LakshanandSugumar/agrobo/land/farmland-shortlist.md

# Agrobo farmland shortlist (first tomato farm)

Pulled from public listings on 2026-10-19. Prices, acreage and water details are as the listing states them and are not verified. Listings change daily, so call the broker before relying on any row.

**Filters used:** Southwest Florida first (launch region), California kept as backup, open or cleared ground (no orchards to rip out), at least ~20 acres in one block, a stated irrigation water source.

## Southwest Florida (launch region, chosen 2026-10-21)

SW Florida grows fresh-market tomatoes from fall to spring, so summer heat and rain, not frost, set the season. Soils are sandy with low organic matter and are farmed on raised beds with plastic mulch and seepage or drip irrigation. Every row below needs a South Florida Water Management District water use permit confirmed.

| # | Property | Acres (ha) | Ask | $/acre | Water (as listed) | Ground today | Why / watch-outs |
|---|---|---|---|---|---|---|---|
| 1 | Alva, Lee Co., FL (N River Rd) | 111.6 (45) | $1,332,000 | ~$11,900 | Irrigation canal on west boundary, no well listed | Cleared ex-citrus, laser-leveled, ag lease to Jan 2027 | Cheapest per acre, already leveled, near the Immokalee tomato belt. Needs a well/water use permit and soil residue test (ex-citrus). Agent Dalton Wade, (727) 888-4175. [Listing](https://www.landsearch.com/properties/n-river-rd-alva-fl-33920/5167966) |
| 2 | 1016 Goodno Rd, LaBelle, Hendry Co., FL | 140 (57) + adjoining 56 ac | $2,736,747 | ~$19,500 | Canal at south end for irrigation, Gerber Water District | Cleared ex-orange grove | Room to grow to ~196 ac. Sweetwater Land Co., Linda Dekle Davis, (863) 517-1153. [Listing](https://www.landsearch.com/properties/1016-goodno-rd-labelle-fl-33935/5572793) |
| 3 | 960 G Rd, LaBelle, Hendry Co., FL | 144.5 (58) | $2,537,500 | ~$17,600 | Water well + canals | Fenced pasture, suited to row crops | Fencing needs repair, listing mentions vandalism. Southern Heritage RE, Sherri Denning, (863) 673-0829. [Listing](https://www.landsearch.com/properties/960-g-rd-labelle-fl-33935/5158578) |
| 4 | Clewiston, Hendry Co., FL | 326 (132) | $11,000,000 on listing page ($8,000,000 on search page) | ~$33,700 | Wells, irrigation and water management, retention pond | ~180 ac active sod, ex-watermelon | Biggest and fully irrigated, but priciest; confirm the real ask. Agent Jamie Bederak, (423) 557-4310. [Listing](https://www.landsearch.com/properties/clewiston-fl/5443580) |

## California (backup, not the launch region)

| # | Property | Acres (ha) | Ask | $/acre | Water (as listed) | Ground today | Why / watch-outs |
|---|---|---|---|---|---|---|---|
| 1 | Dutra Central Ave Ranch, Clarksburg, Yolo Co., CA | 117 (47) | $2,223,000 | ~$19,000 | Riparian rights + pre-1914 North Delta rights, 2,000 GPM slough pump | Productive Delta ag land, 5 parcels | Senior surface water rights are the most valuable thing on this list. Yolo is core processing-tomato country. Listing flyer filename is dated 2012, so confirm it is current. [Listing](https://www.landwatch.com/yolo-county-california-farms-and-ranches-for-sale/pid/427597666) |
| 2 | 13450 Turner Island Rd, Dos Palos, Merced Co., CA | 127.5 gross / 122.5 farmable (50) | $2,677,500 | ~$21,000 | San Luis Canal Co. surface water + 1 ag well | Open ground | Clean open block with surface water. One page shows it Pending, the listing says Available; confirm status. Possible broker: Murray Ag Real Estate. [Listing](https://www.landwatch.com/merced-county-california-farms-and-ranches-for-sale/pid/428495026) |
| 3 | Palm Ave, Winton, Merced Co., CA | 19.7 (8) | $625,000 | ~$31,700 | Tier 1 Merced Irrigation District + shared ag well (40 HP) | Row crops 6+ years | Pilot-sized only (8 ha), but turnkey with strong water. MLS MC26201161. [Listing](https://www.landwatch.com/merced-county-california-farms-and-ranches-for-sale/pid/428203794) |

**Try-before-buy option:** 595 N Header Canal Rd, Fort Pierce, St. Lucie Co., FL. About 76-80 ac for lease at $5,000/month (12-60 months), seepage irrigation, multiple wells, pump stations, farmed 20+ years. Useful to run a first season while closing on a purchase. Contact Matt Eflanli, (561) 666-8288. [Listing](https://www.landsearch.com/properties/595-n-header-canal-rd-fort-pierce-fl-34945/4898677)

**Looked at and dropped:** French Camp, CA (76 ac, $4.49M, planted almonds, ~$59k/ac); Colusa River Rd, CA (345 ac, $6.5M, mostly walnuts and rice, row-crop acreage not stated); plus orchard, vineyard and rural-home listings in the Central Valley feed.

## Land vs robot cost

At ~$11,900-21,000/acre, land is roughly $29k-54k per hectare, against the sim's modeled robot capex of ~$77k/ha. On the top picks, land is a smaller check than the fleet.

## Due diligence before an offer

1. **Water:** confirm rights and deliveries in writing (district allocation history, well yield test). In the San Joaquin Valley, groundwater pumping limits under SGMA apply, so surface water matters. In Florida, confirm a South Florida Water Management District water use permit.
2. **Soil:** NRCS soil survey plus lab tests, including pesticide residue on ex-citrus ground.
3. **Title, zoning and Williamson Act status**, Phase I environmental, flood zone.
4. **Robot fit:** run each parcel's boundary and slope through the prototype's `/strategy_engine` to check block shape, headlands and RTK/cell coverage.

## Sources
- [LandSearch: Florida row crop land](https://www.landsearch.com/row-crop/florida)
- [LandSearch: San Joaquin County farmland](https://www.landsearch.com/agricultural/san-joaquin-county-ca)
- [LandWatch: Central Valley farms and ranches](https://www.landwatch.com/california-land-for-sale/central-valley-region/farms-ranches)
- Individual listing links in the table above.
