LakshanandSugumar/agrobo/robots/calc/fleet_capex.md

| Scenario | UGV/ha | $/UGV incl. share of implements + dock | UGVs $/ha | UAV | Hauler | Hub | Prep | **Total $/ha** | vs model |
|---|---:|---:|---:|---:|---:|---:|---:|---:|---:|
| Prototype model | 1.23 | 55,000 | 67,650 | 60 | 3,750 | 3,750 | 1,500 | **76,710** | +0 % |
| Real BOM, pilot prices, sim cycle time, mechanical weeder | 1.24 | 59,524 | 74,037 | 55 | 3,711 | 3,750 | 0 | **81,553** | +6 % |
| Real BOM, pilot prices, sim cycle time, laser weeder | 1.24 | 72,874 | 90,642 | 55 | 3,711 | 3,750 | 0 | **98,158** | +28 % |
| Real BOM, 100-unit prices, sim cycle time, mechanical weeder | 1.24 | 43,580 | 54,206 | 41 | 2,783 | 3,750 | 0 | **60,781** | -21 % |
| Real BOM, 100-unit prices, design-target cycle time, mechanical weeder | 0.82 | 43,580 | 35,912 | 41 | 2,783 | 3,750 | 0 | **42,486** | -45 % |
