LakshanandSugumar/agrobo/robots/electrical/E-02_safety_circuit.pdf

# E-02 Safety chain -> PNOZ s4 -> K1 drive / K2 arms

Dual channel, cross-monitored, Cat 3 / PL d target (ISO 13849-1). Stop category 0 for drive, cat 1 for arms (controlled stop then K2).

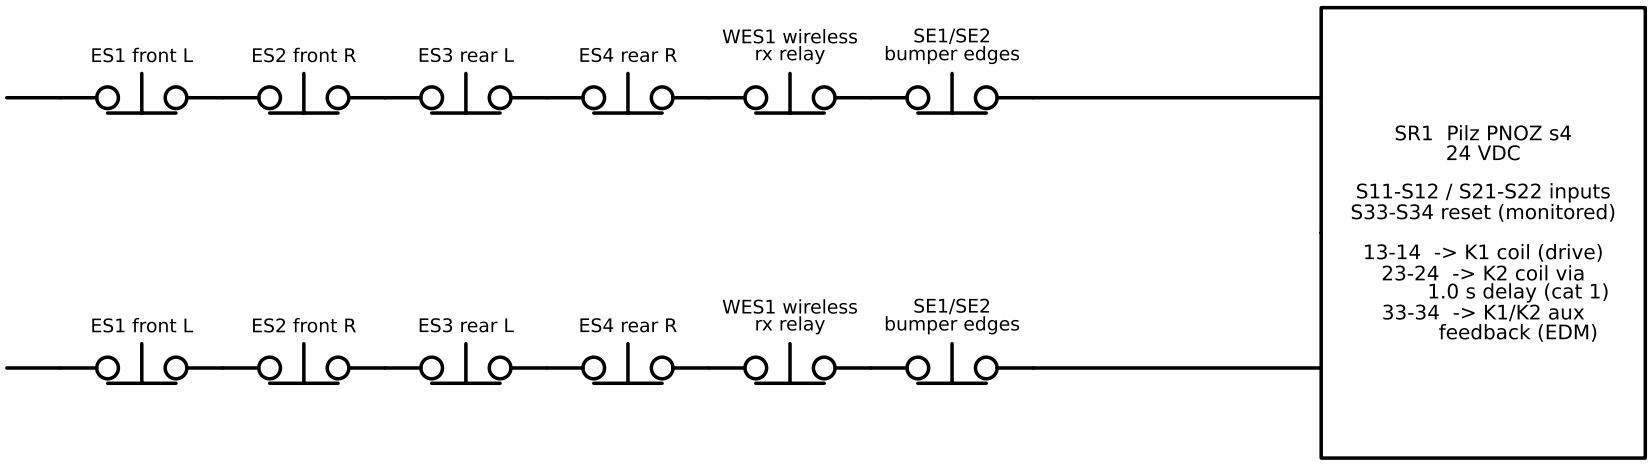
[picture p8: figure]
ES1 front L; ES2 front R; ES3 rear L; ES4 rear R; WES1 wireless rx relay; SE1/SE2 bumper edges; SR1 Pilz PNOZ s4 24 VDC; S11-S12 / S21-S22 inputs S33-S34 reset (monitored); 13-14 -> K1 coil (drive) 23-24 -> K2 coil via 1.0 s delay (cat 1) 33-34 -> K1/K2 aux feedback (EDM)

CH1 (S11-S12)

CH2 (S21-S22)

RS1 reset (blue)
at rear panel Also wired into SR1 inputs in series: FR5 controller safety I/O (each arm reports protective stop), BMS fault relay. Software stop (non-safety) path: Jetson -> Teensy -> VESC zero current + FR5 'stop' over Ethernet; used for normal pauses.
Geofence + speed limit (0.5 m/s near people detected by perception) are software functions and are NOT counted as safety functions in v1. Production: add SICK outdoorScan3 safety laser scanner zones (protective field 1.5 m at 1.5 m/s) to reach ISO 18497 people-detection.
