LakshanandSugumar/agrobo/robots/electrical/E-03_data_comms.pdf

# E-03 Data and communications architecture

Ethernet backbone + GMSL2 + USB3 + CAN-FD | ROS 2 Jazzy on Jetson, micro-ROS on Teensy | Agrobo rev A 2026-10-21

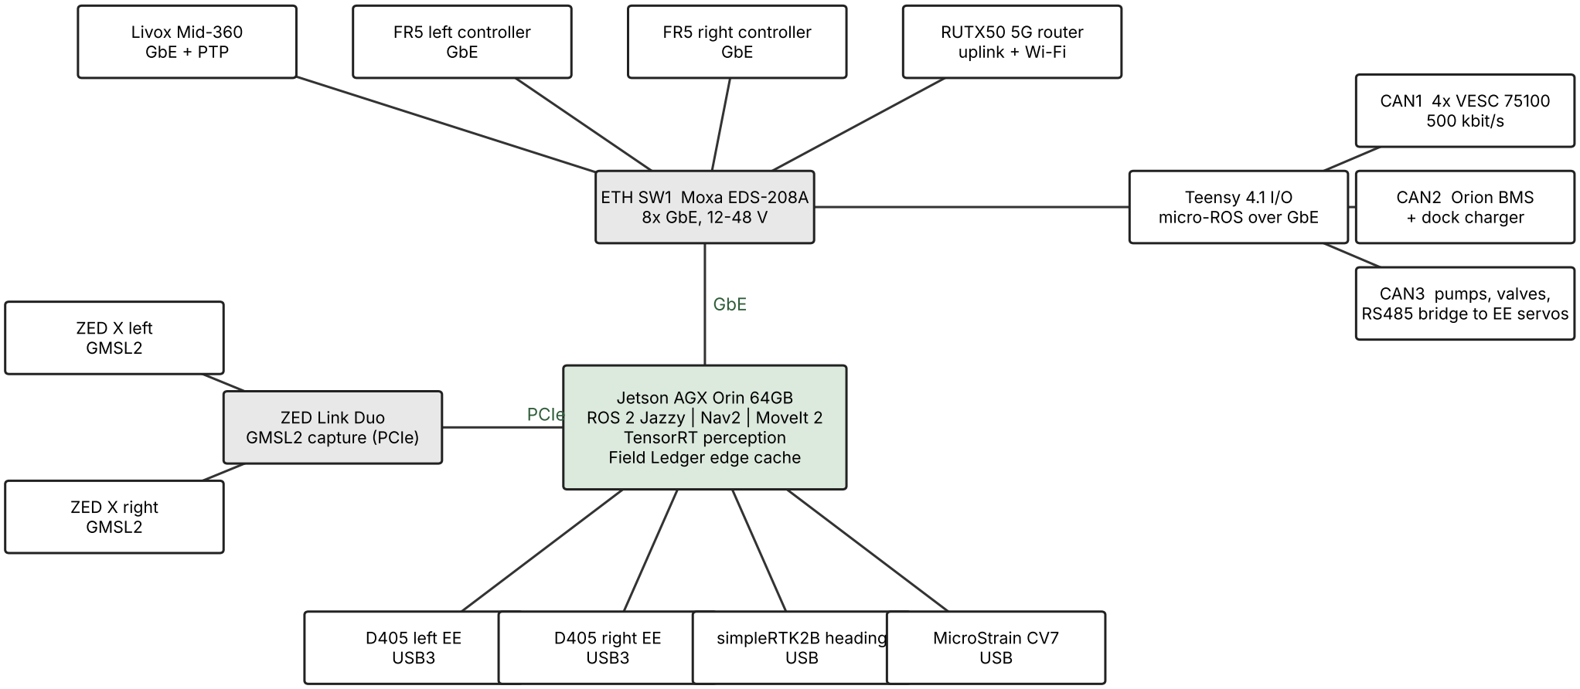
[picture p9: figure]
GbE; PCIe; Jetson AGX Orin 64GB ROS 2 Jazzy | Nav2 | MoveIt 2; TensorRT perception Field Ledger edge cache; ETH SW1 Moxa EDS-208A 8x GbE, 12-48 V; Livox Mid-360; GbE + PTP; FR5 left controller GbE; FR5 right controller GbE; RUTX50 5G router uplink + Wi-Fi; Teensy 4.1 I/O micro-ROS over GbE; ZED Link Duo GMSL2 capture (PCIe); ZED X left GMSL2; ZED X right GMSL2; D405 left EE USB3; D405 right EE USB3; simpleRTK2B heading USB; MicroStrain CV7 USB; CAN1 4x VESC 75100 500 kbit/s; CAN2 Orion BMS + dock charger; CAN3 pumps, valves, RS485 bridge to EE servos

RTK corrections: FDOT Florida Permanent Reference Network (FPRN) NTRIP over 5G; fallback = farm base station on a 900 MHz radio. Time sync: PTP grandmaster on the Jetson to lidar + switch; ZED X pair hardware-triggered by the ZED Link card.
Offline-first: the robot runs its day plan from the local Field Ledger cache; telemetry is buffered and synced when 5G returns.
