LakshanandSugumar/agrobo/film/v3/tex/leaflet0.png

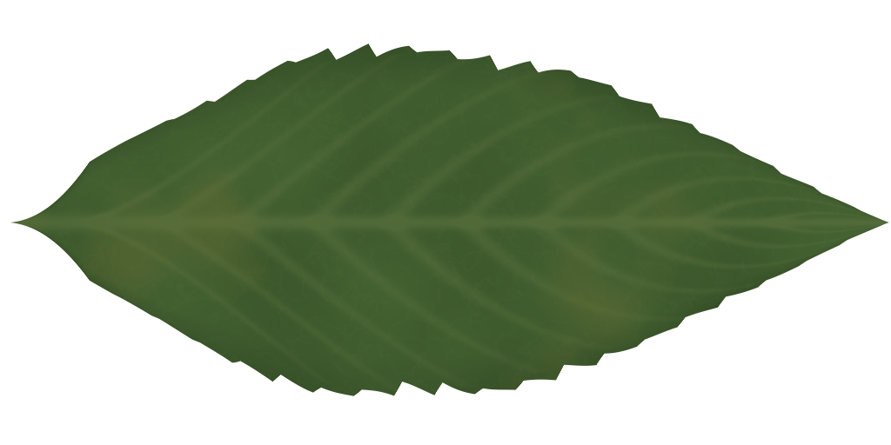
film/v3/tex/leaflet0.png
