LakshanandSugumar/agrobo/film/v3/tex/leaflet0_h.png

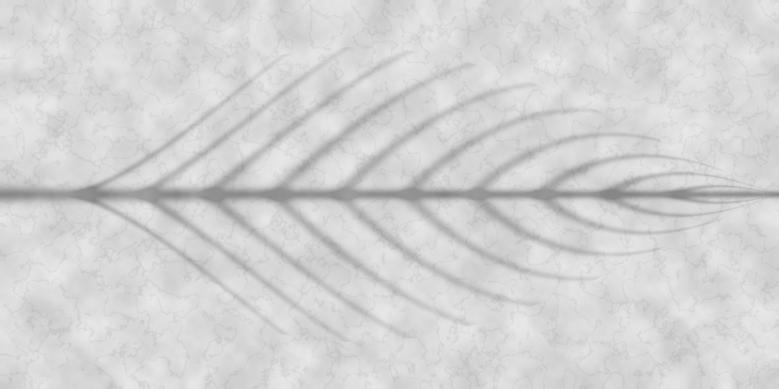
film/v3/tex/leaflet0_h.png
