LakshanandSugumar/agrobo/film/v3/tex/leaflet1.png

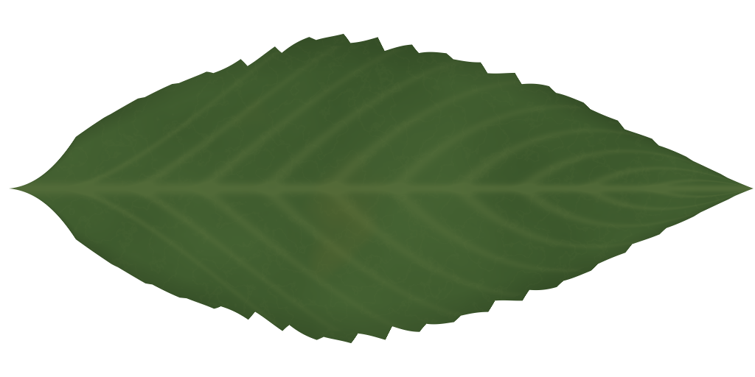
film/v3/tex/leaflet1.png
