LakshanandSugumar/agrobo/film/v3/tex/leaflet1_h.png

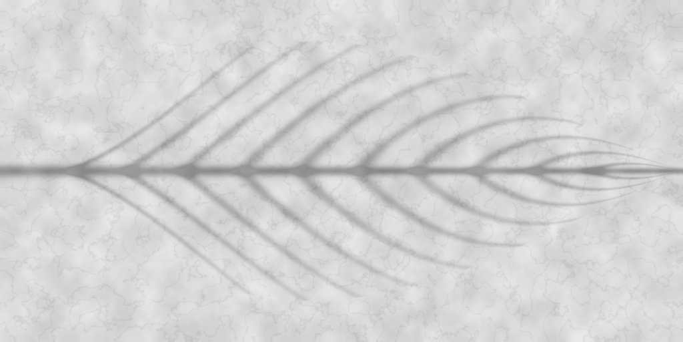
film/v3/tex/leaflet1_h.png
