LakshanandSugumar/agrobo/film/v3/tex/leaflet2.png

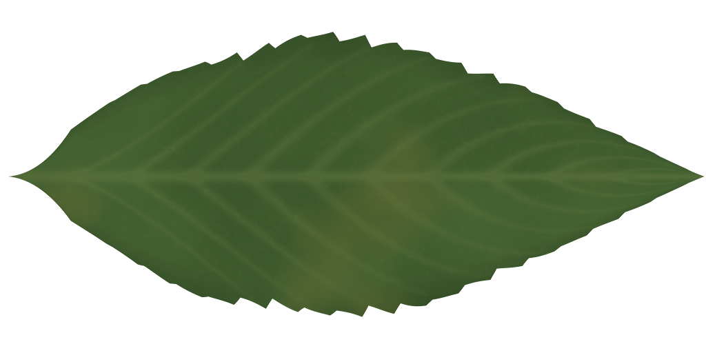
film/v3/tex/leaflet2.png
