LakshanandSugumar/agrobo/film/v3/tex/leaflet2_h.png

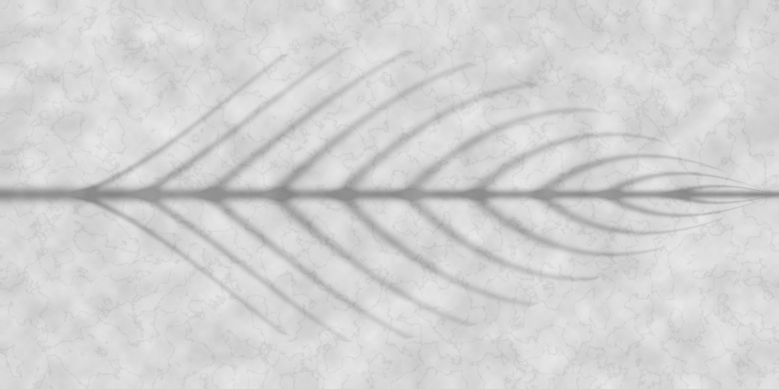
film/v3/tex/leaflet2_h.png
