LakshanandSugumar/agrobo/film/v3/tex/twig0.png

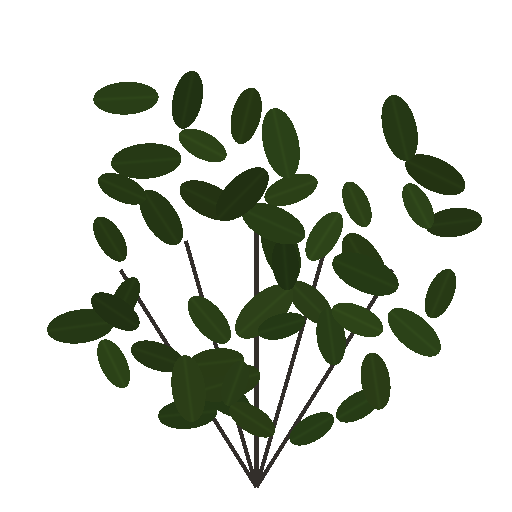
film/v3/tex/twig0.png
