LakshanandSugumar/agrobo/film/v3/tex/twig1.png

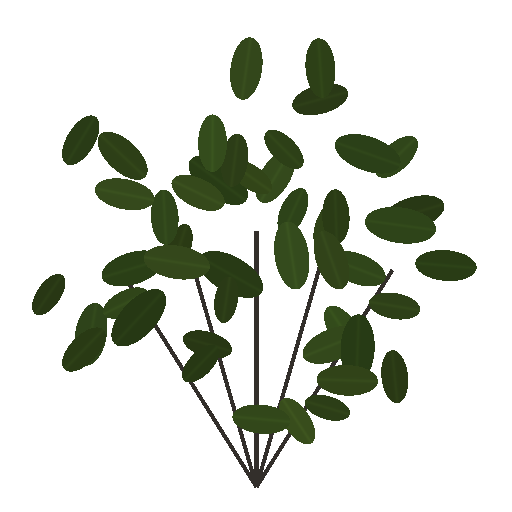
film/v3/tex/twig1.png
