LakshanandSugumar/agrobo/film/v3/tex/twig2.png

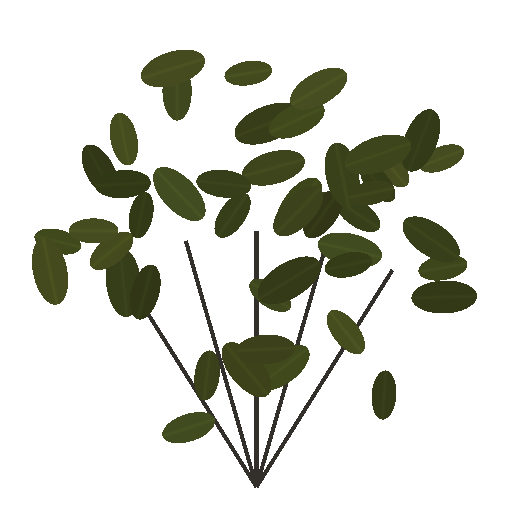
film/v3/tex/twig2.png
