LakshanandSugumar/agrobo/film/v3/tex/twig3.png

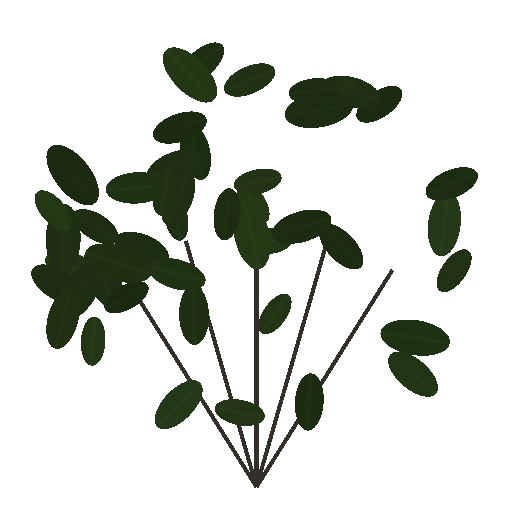
film/v3/tex/twig3.png
