LakshanandSugumar/agrobo/preview/film-takeover.png

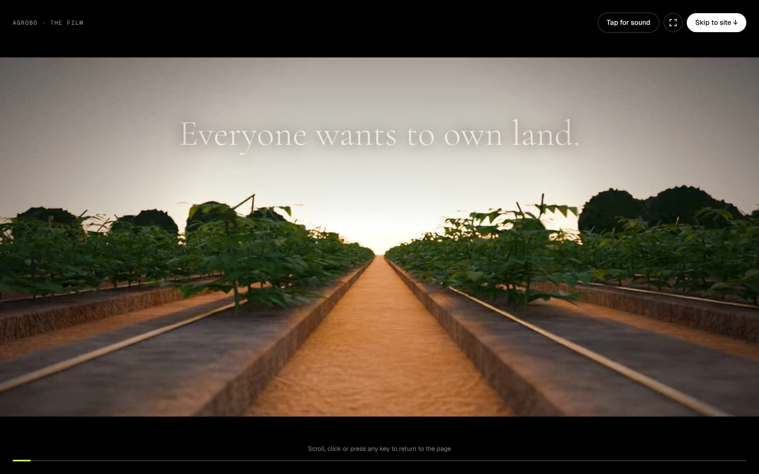
preview/film-takeover.png
