LakshanandSugumar/agrobo/preview/home.png

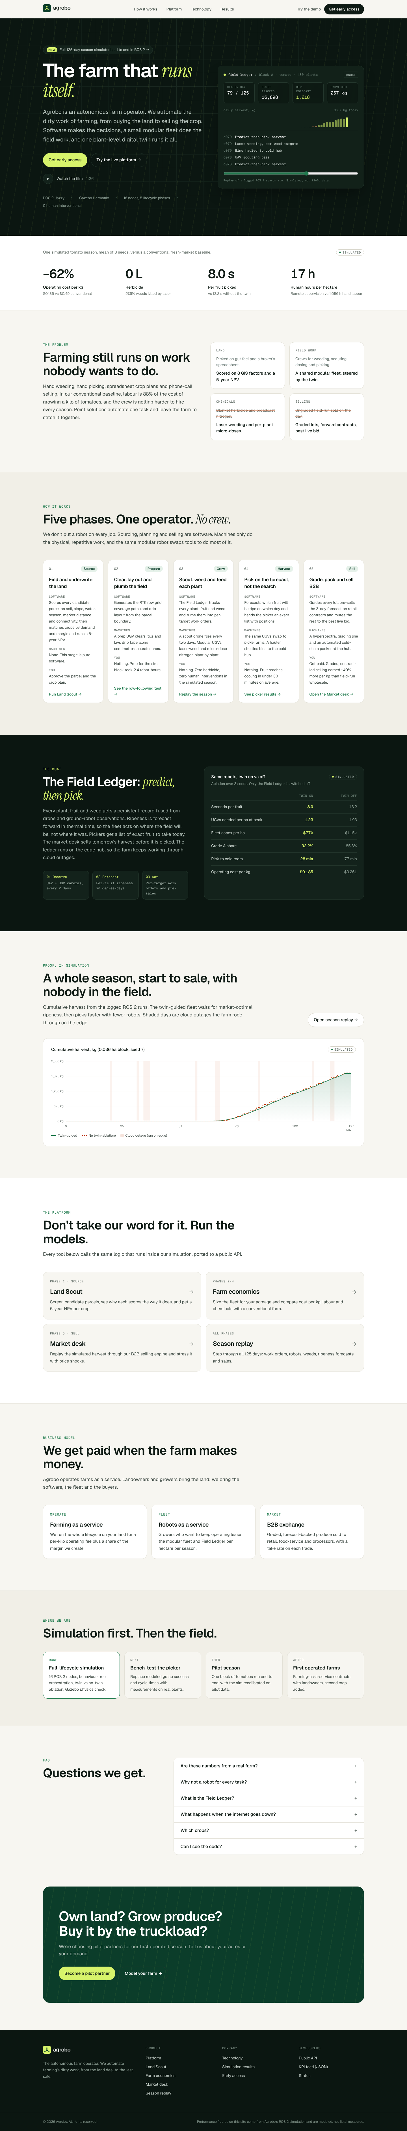
preview/home.png
