LakshanandSugumar/agrobo/preview/platform_economics.png

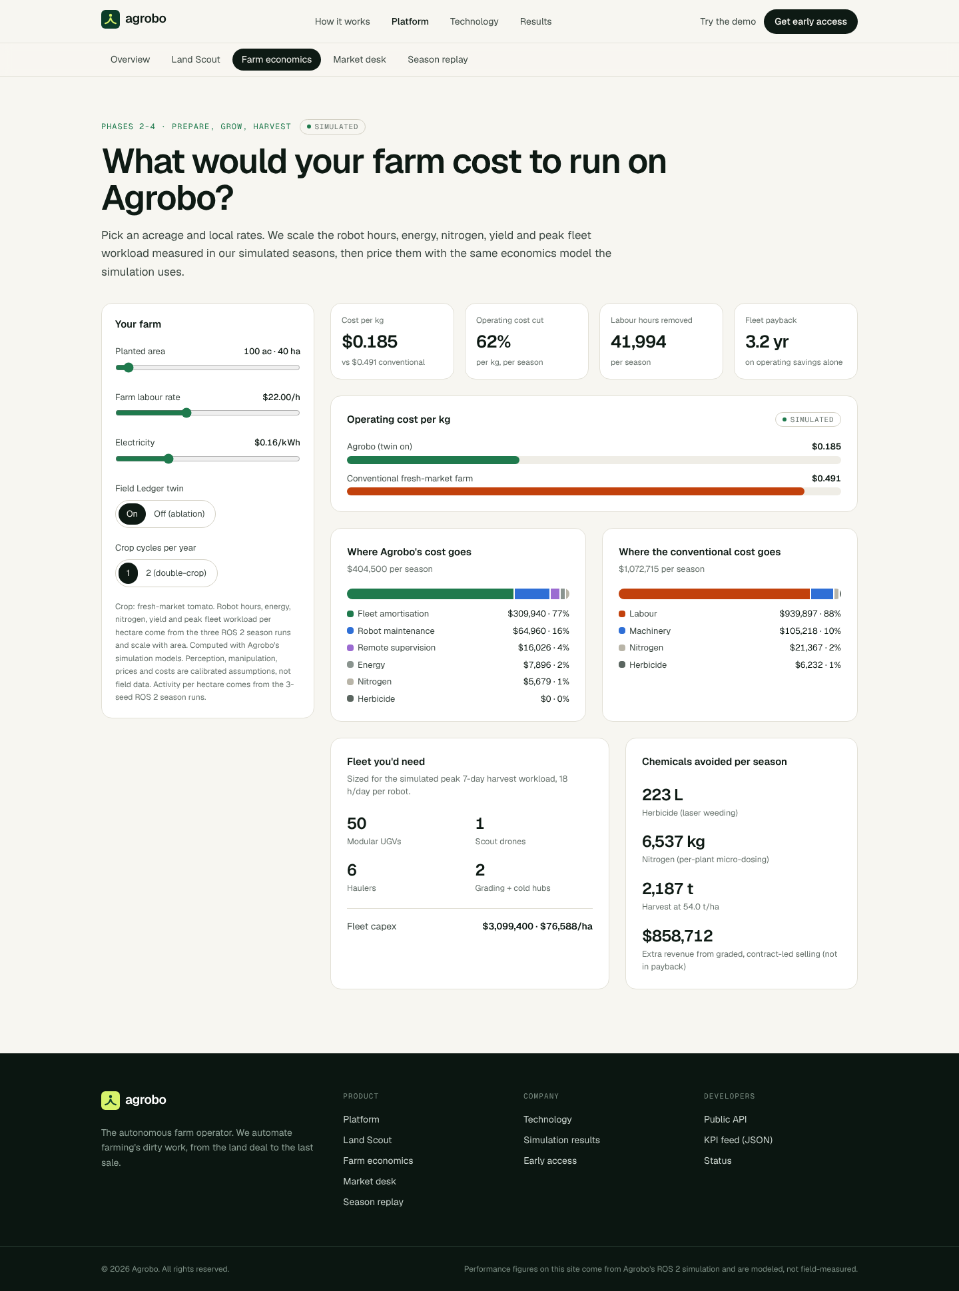
preview/platform_economics.png
