LakshanandSugumar/agrobo/preview/platform_land.png

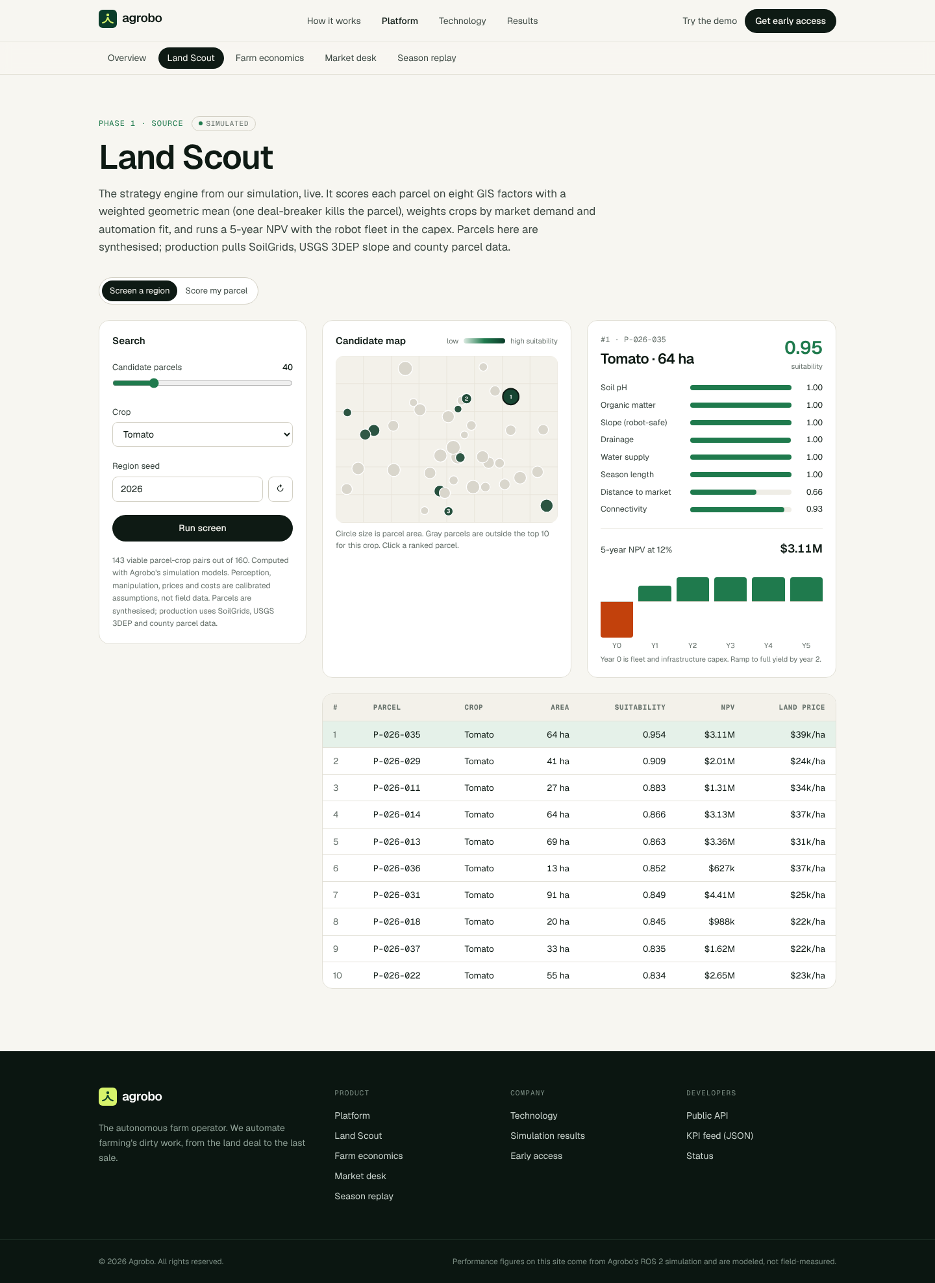
preview/platform_land.png
