LakshanandSugumar/agrobo/preview/platform_market.png

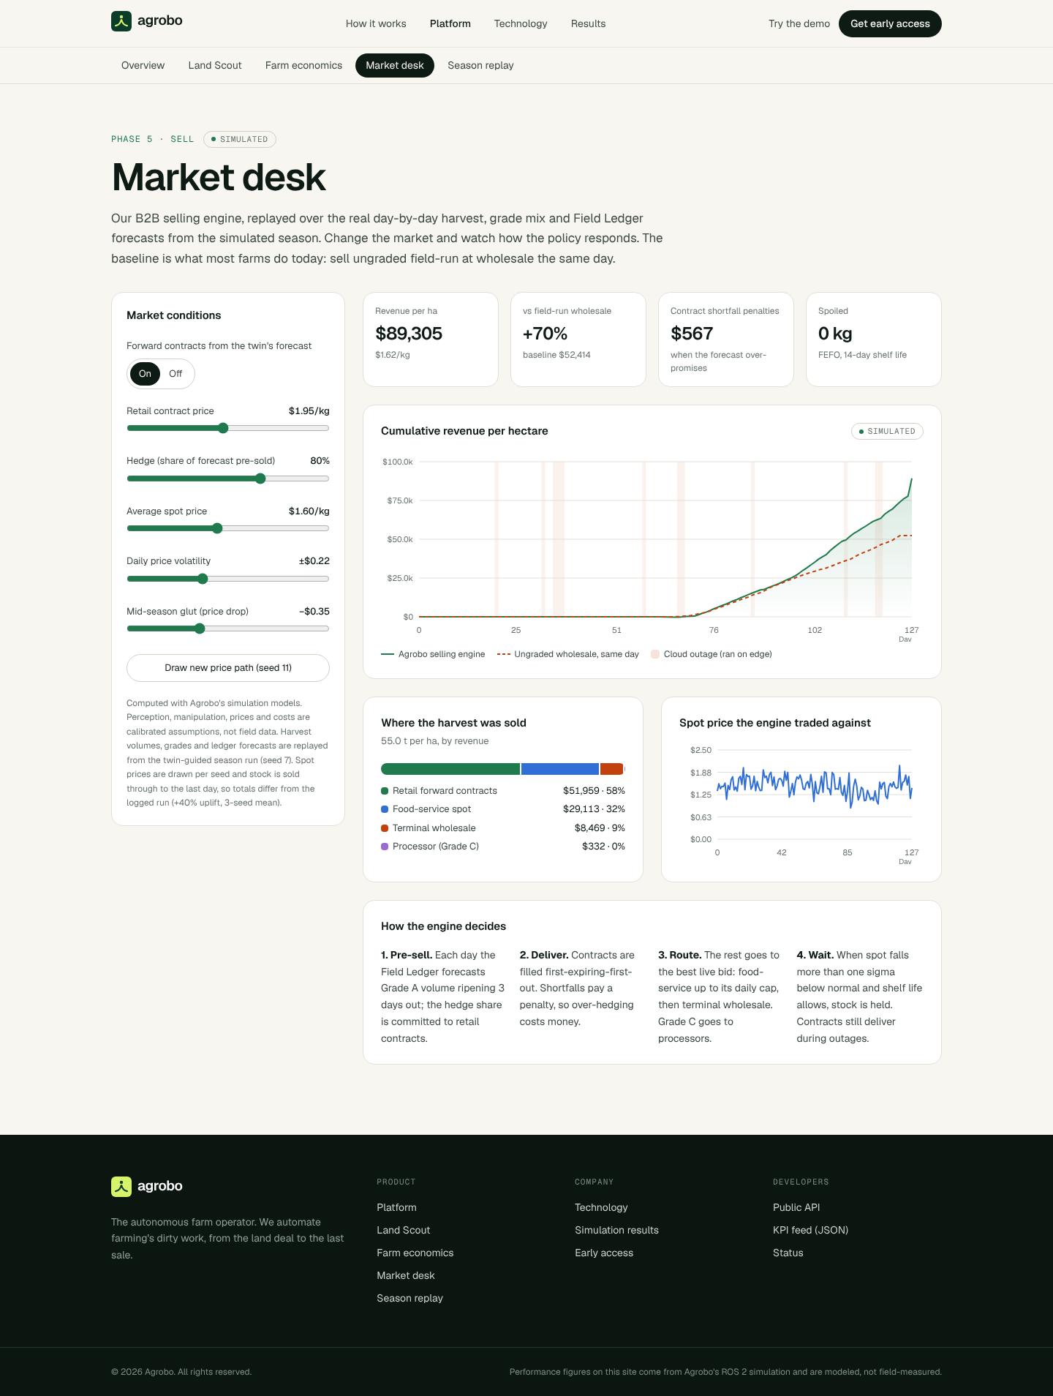
preview/platform_market.png
