LakshanandSugumar/agrobo/preview/platform_season.png

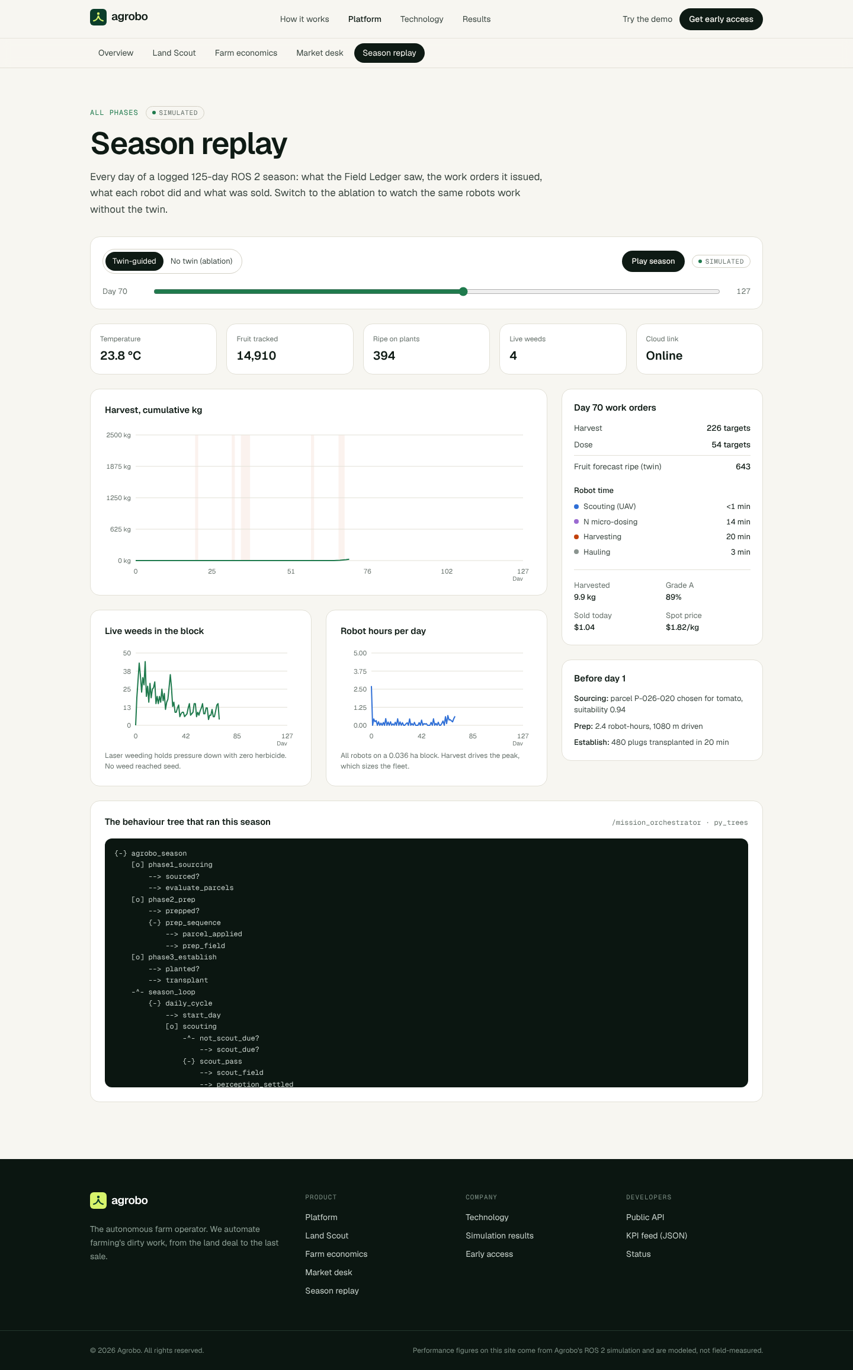
preview/platform_season.png
