LakshanandSugumar/agrobo/preview/technology.png

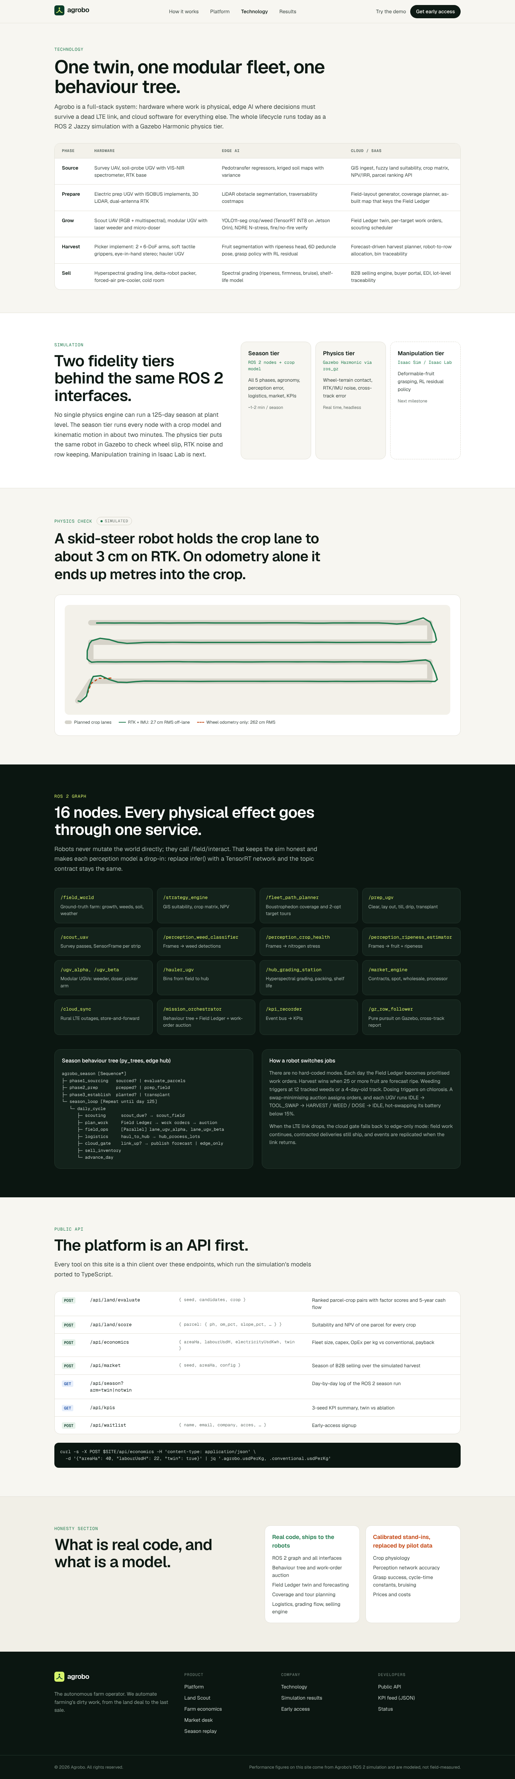
preview/technology.png
