LakshanandSugumar/agrobo/robots/cad/renders/HL1_hauler.png

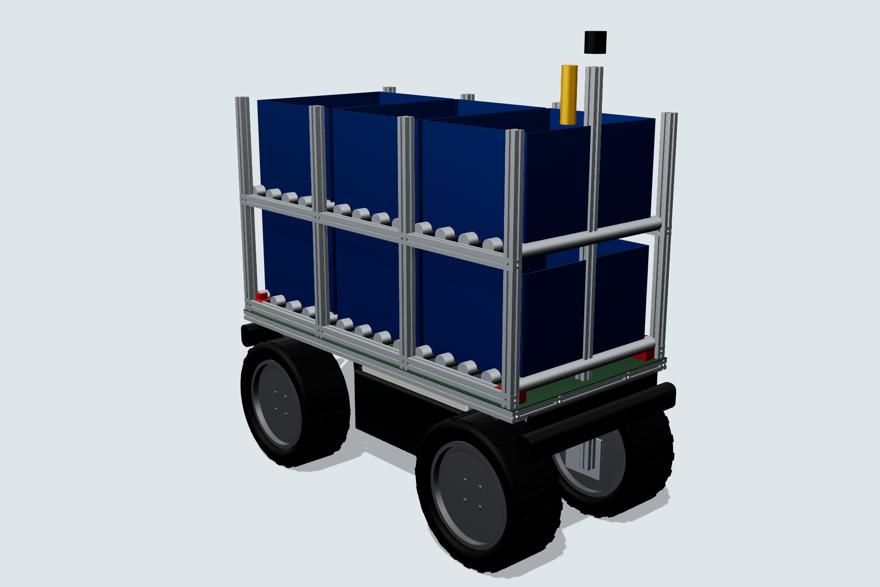
robots/cad/renders/HL1_hauler.png
