LakshanandSugumar/agrobo/robots/cad/renders/HM1_front_view_in_aisle.png

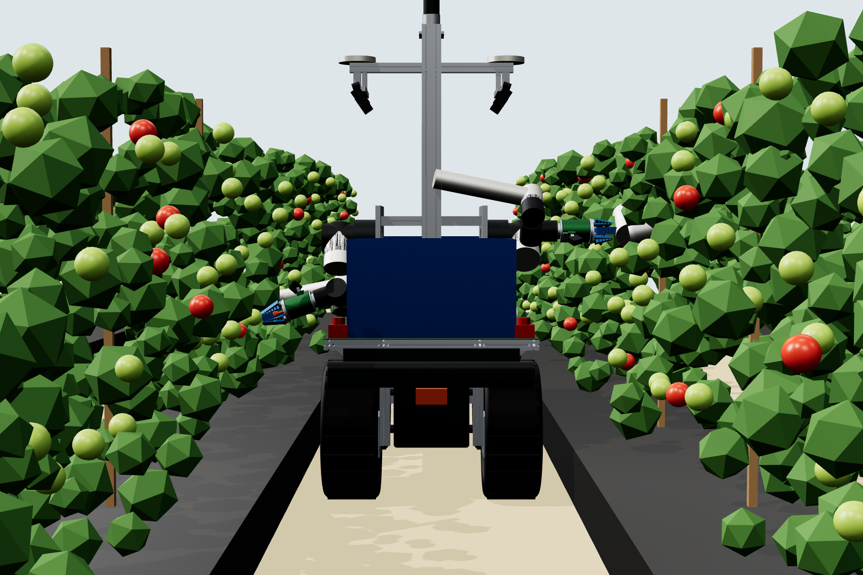
robots/cad/renders/HM1_front_view_in_aisle.png
