LakshanandSugumar/agrobo/robots/preview/gazebo-cameras.jpg

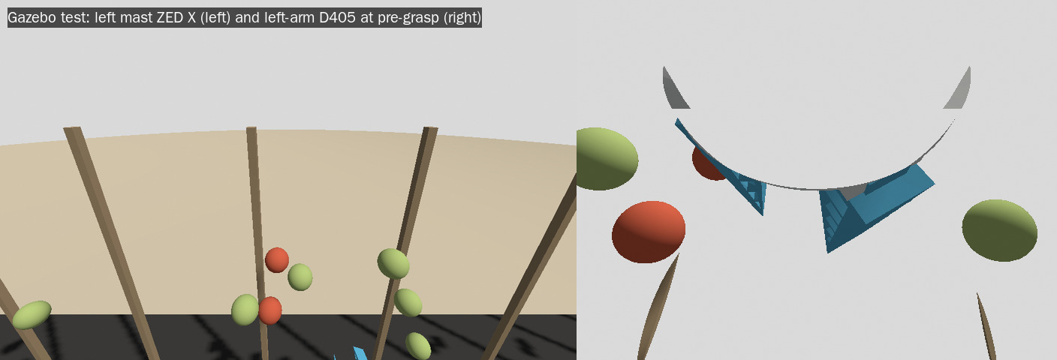
robots/preview/gazebo-cameras.jpg
