LakshanandSugumar/agrobo/screenshots/economics.png

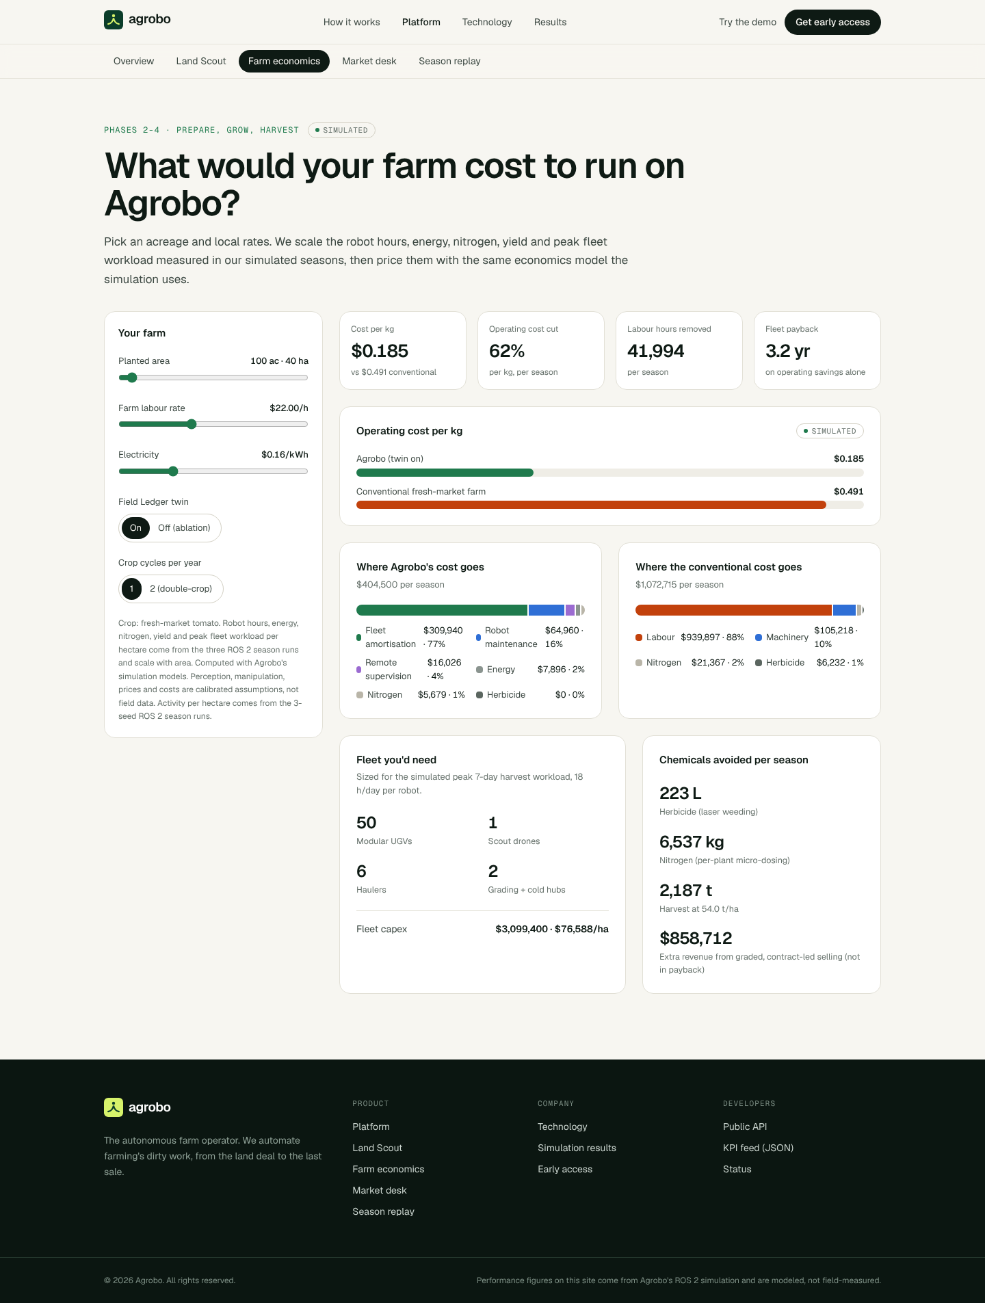
screenshots/economics.png
