LakshanandSugumar/agrobo/training/preview/scripted-pick-sequence.jpg

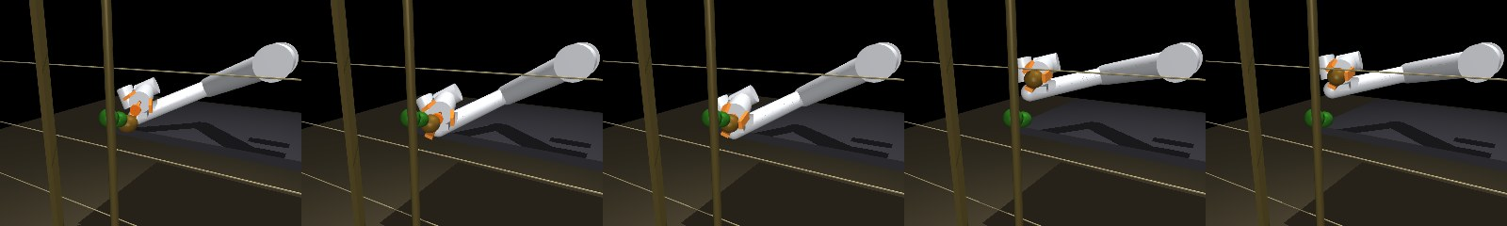
training/preview/scripted-pick-sequence.jpg
