LakshanandSugumar/agrobo/training/preview/synthetic-florida-labelled.jpg

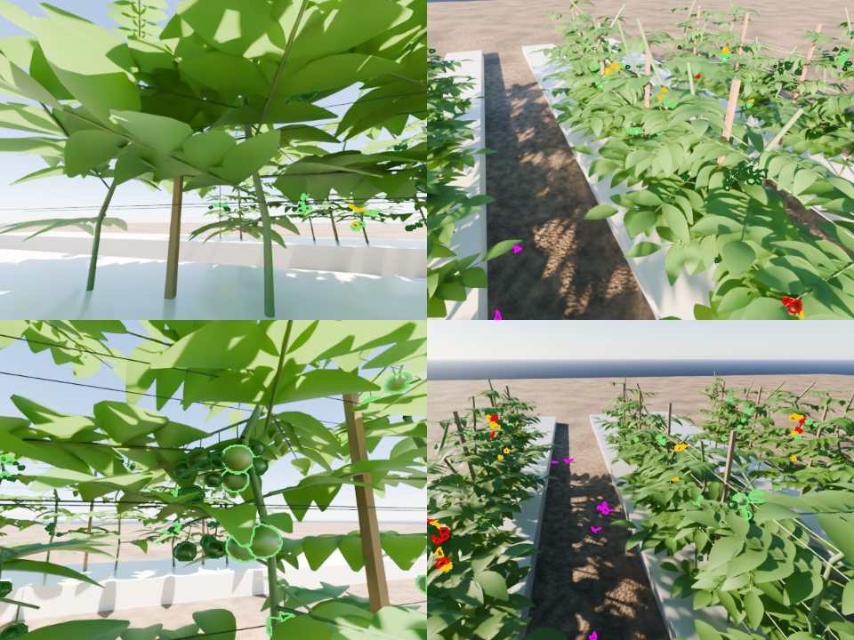
training/preview/synthetic-florida-labelled.jpg
