LakshanandSugumar/agrobo/world/preview/gazebo-sensors.jpg

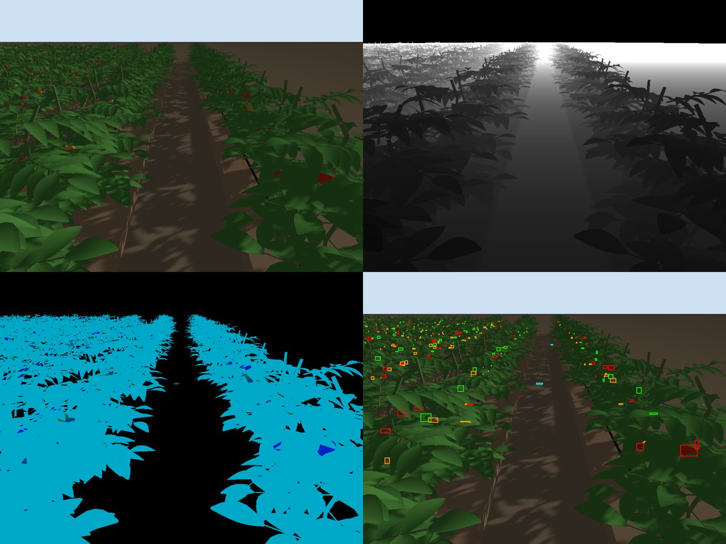
world/preview/gazebo-sensors.jpg
