LakshanandSugumar/agrobo/world/preview/labelled-samples.jpg

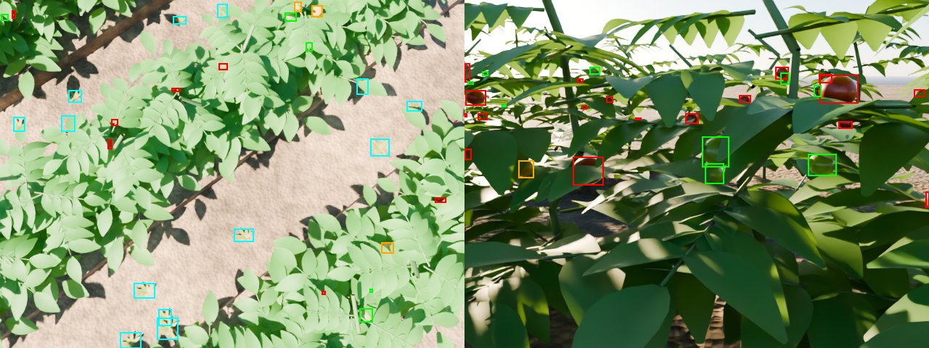
world/preview/labelled-samples.jpg
