LakshanandSugumar/agrobo/world/synth/sample_dataset/images/000000.png

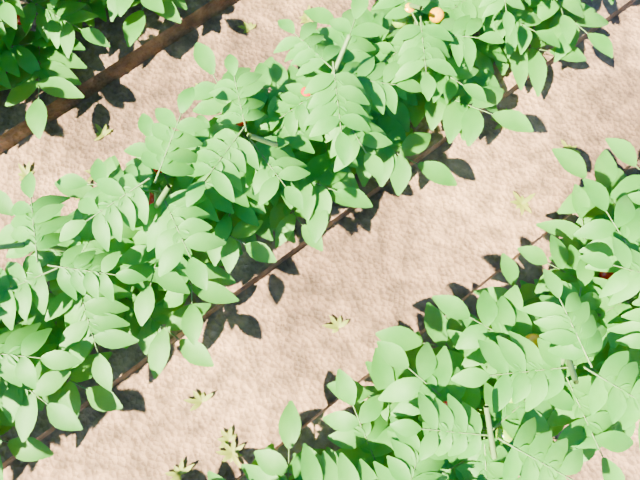
world/synth/sample_dataset/images/000000.png
