LakshanandSugumar/agrobo/world/synth/sample_dataset/images/000001.png

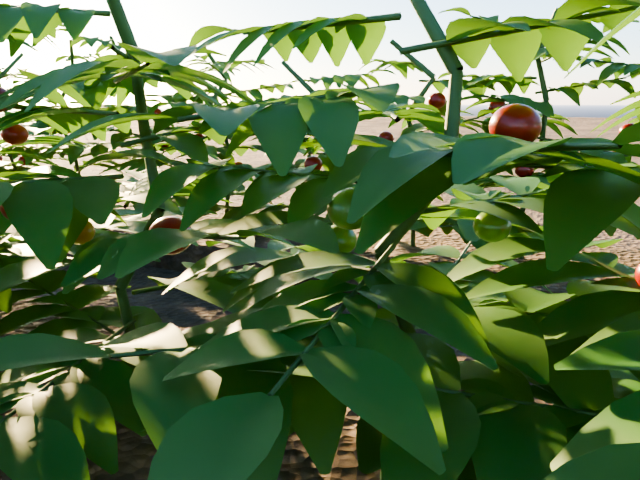
world/synth/sample_dataset/images/000001.png
