LakshanandSugumar/agrobo/world/synth/sample_dataset/masks/000000.png

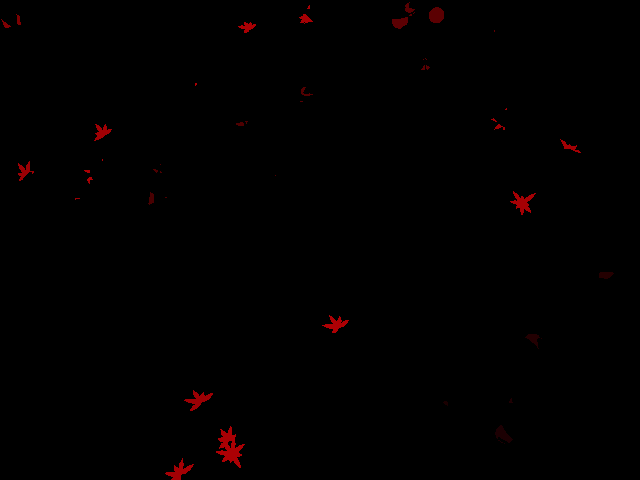
world/synth/sample_dataset/masks/000000.png
