LakshanandSugumar/agrobo/world/synth/sample_dataset/masks/000001.png

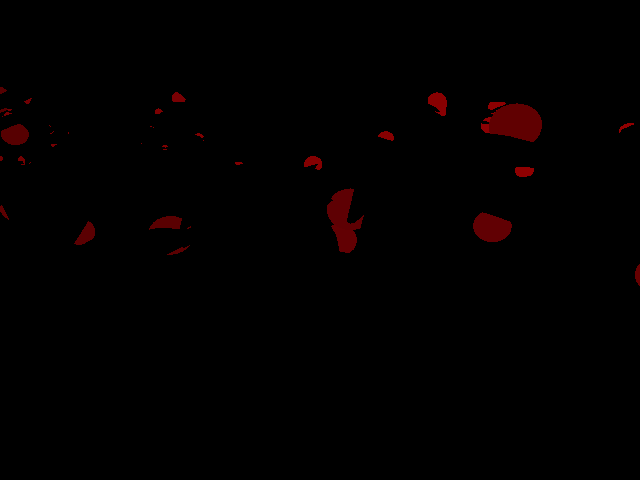
world/synth/sample_dataset/masks/000001.png
