LakshanandSugumar/agrobo/robots/cad/step/HM1_harvester_full_assembly.step

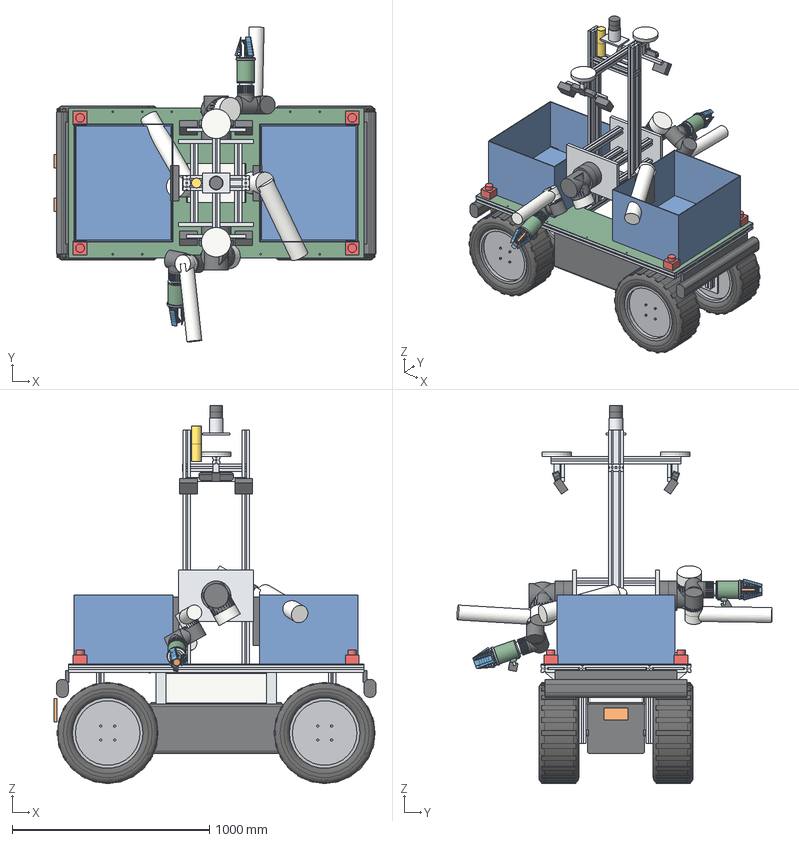
[picture p39: CAD file, 2026-10-21]
robots/cad/step/HM1_harvester_full_assembly.step
1632.0 x 1596.9 x 1916.5 mm
deck_frame
legs_and_axle_plates
deck_plate
tyre_fl x 4
hub_motor_fl x 4
shaft_fl x 4
battery_keel
keel_hangers
battery_connector
electronics_enclosure
bumpers
estops
dock_contacts
mast_posts
mast_beams
arm_mount_plates
lidar_pedestal
zedx
lidar
gnss
beacon
floods
brackets
arm_ctrl
totes
left_arm_base
left_shoulder
left_upper_arm
left_forearm
left_wrist_1
left_wrist_2
left_wrist_3
left_ee_flange_adapter x 2
left_ee_housing x 2
left_ee_servo_xm430 x 2
left_ee_front_plate x 2
left_ee_fingers x 2
left_ee_suction_cup x 2
left_ee_d405 x 2
left_ee_cam_bracket x 2
left_ee_ring_light x 2
right_arm_base
right_shoulder
right_upper_arm
right_forearm
right_wrist_1
right_wrist_2
right_wrist_3
