LakshanandSugumar/agrobo/robots/cad/step/EE1_end_effector_assembly.step

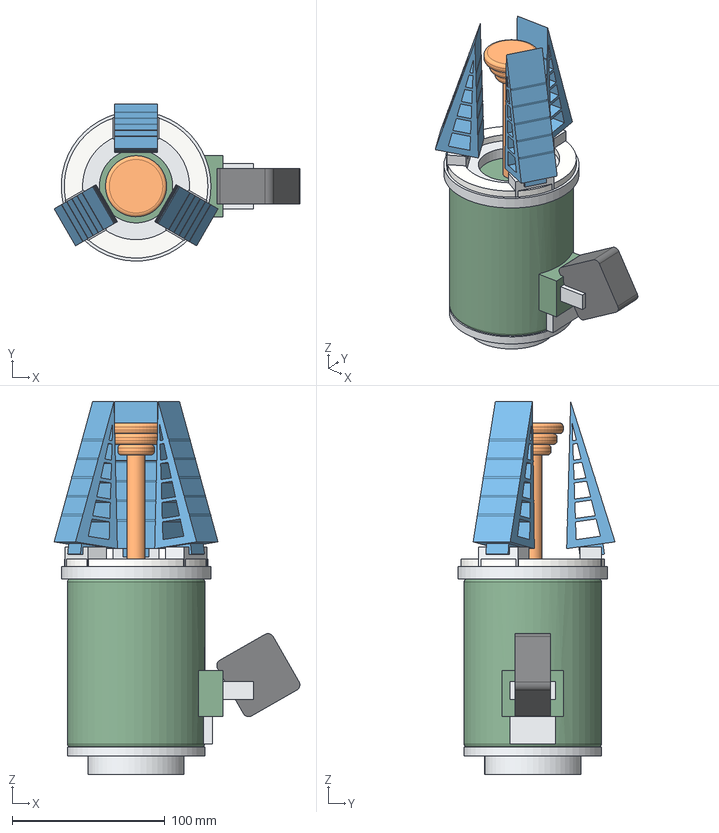
[picture p40: CAD file, 2026-10-21]
robots/cad/step/EE1_end_effector_assembly.step
160.8 x 102.8 x 244.1 mm
flange_adapter
housing
servo_xm430
front_plate
fingers
suction_cup
d405
cam_bracket
ring_light
