LakshanandSugumar/agrobo/robots/cad/step/HL1_hauler_full_assembly.step

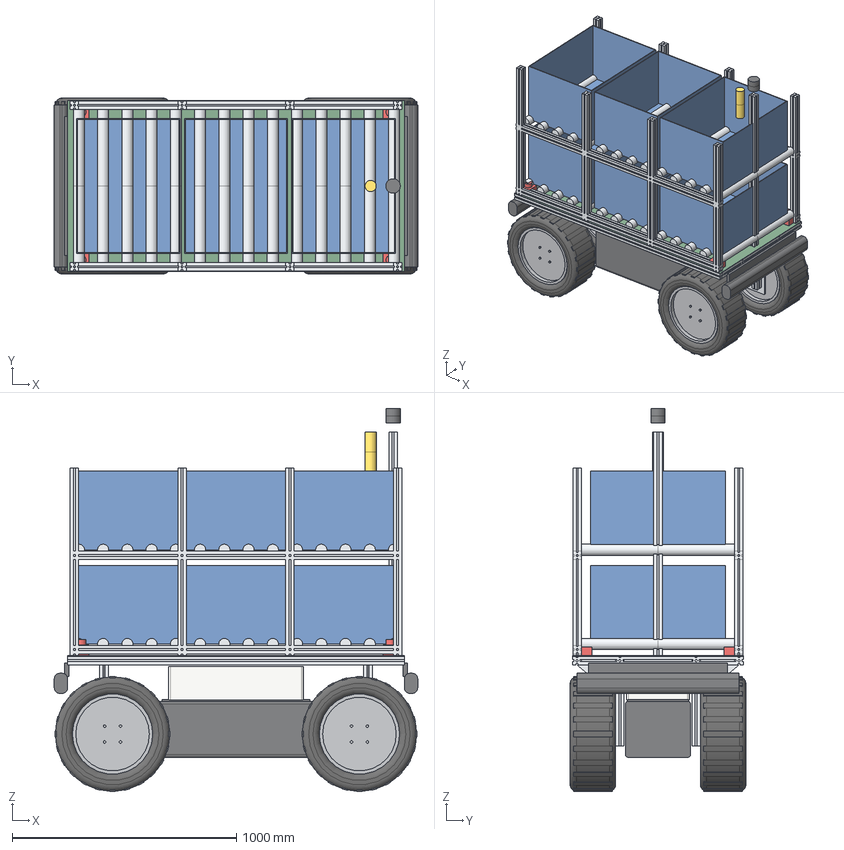
[picture p41: CAD file, 2026-10-21]
robots/cad/step/HL1_hauler_full_assembly.step
1620.0 x 783.0 x 1706.5 mm
deck_frame
legs_and_axle_plates
deck_plate
tyre_1_1 x 4
hub_1_1 x 4
battery_keel
electronics_enclosure
bumpers
estops
tote_rack_rollers
tote_0_0
tote_0_1
tote_1_0
tote_1_1
tote_2_0
tote_2_1
sensor_post
lidar
beacon
