LakshanandSugumar/agrobo/robots/cad/dxf/HM1-101_arm_mount_plate_20mm_6061_x2.dxf

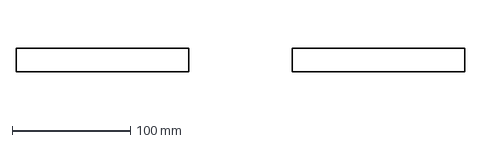
[picture p42: CAD file, 2026-10-21]
robots/cad/dxf/HM1-101_arm_mount_plate_20mm_6061_x2.dxf
380.0 x 20.0 mm
