LakshanandSugumar/agrobo/robots/cad/step/HM1-101_arm_mount_plate.step

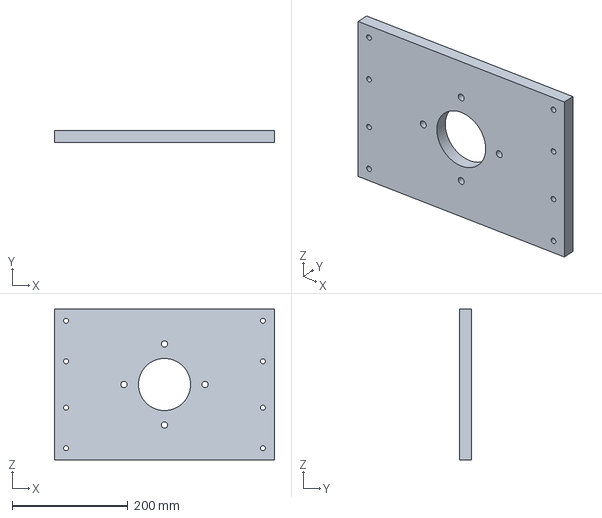
[picture p43: CAD file, 2026-10-21]
robots/cad/step/HM1-101_arm_mount_plate.step
380.0 x 20.0 x 260.0 mm
