LakshanandSugumar/agrobo/robots/urdf/agrobo_description/meshes/arm_wrist_3.stl

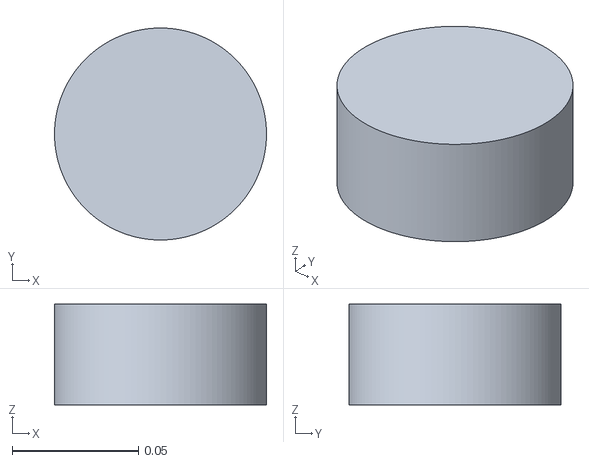
[picture p44: CAD file, 2026-10-21]
robots/urdf/agrobo_description/meshes/arm_wrist_3.stl
0.084 x 0.084 x 0.04
