LakshanandSugumar/agrobo/world/models/agrobo_scout_uav/meshes/agrobo_scout_uav.obj

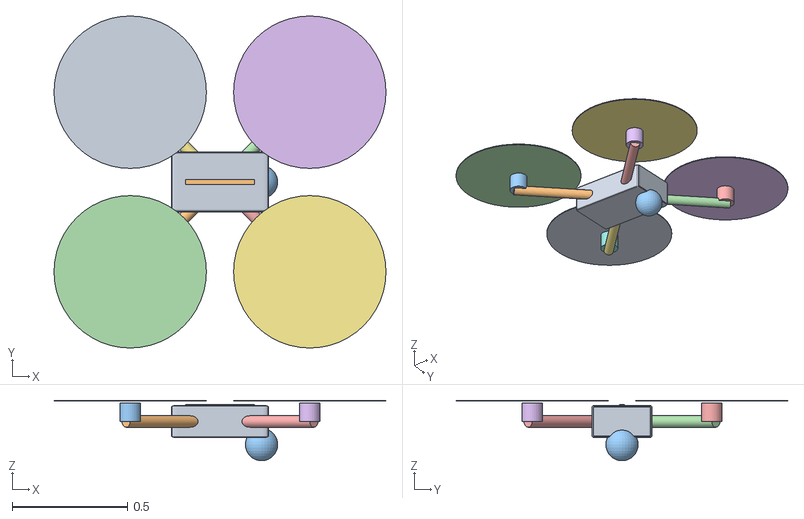
[picture p45: CAD file, 2026-10-21]
world/models/agrobo_scout_uav/meshes/agrobo_scout_uav.obj
1.44 x 1.44 x 0.262
drone_b
drone_g
drone_cam
drone_arm
drone_mot
drone_disc
drone_arm.001
drone_mot.001
drone_disc.001
drone_arm.002
drone_mot.002
drone_disc.002
drone_arm.003
drone_mot.003
drone_disc.003
