LakshanandSugumar/agrobo/world/models/agrobo_ugv_tiller/meshes/agrobo_ugv_tiller.obj

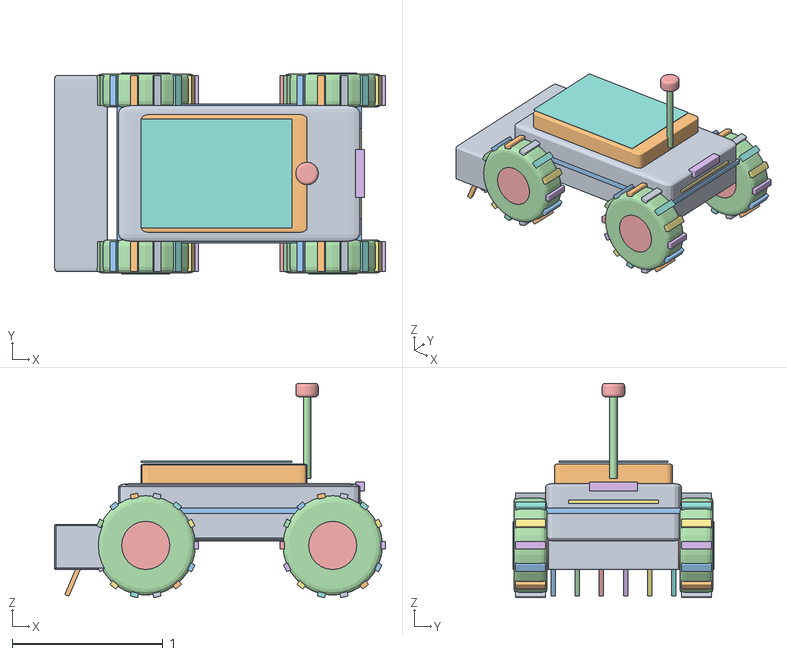
[picture p47: CAD file, 2026-10-21]
world/models/agrobo_ugv_tiller/meshes/agrobo_ugv_tiller.obj
2.20 x 1.33 x 1.42
ugv_chassis
ugv_top
ugv_stripe
ugv_w
ugv_hub
ugv_lug
ugv_lug.001
ugv_lug.002
ugv_lug.003
ugv_lug.004
ugv_lug.005
ugv_lug.006
ugv_lug.007
ugv_lug.008
ugv_lug.009
ugv_lug.010
ugv_lug.011
ugv_lug.012
ugv_lug.013
ugv_w.001
ugv_hub.001
ugv_lug.014
ugv_lug.015
ugv_lug.016
ugv_lug.017
ugv_lug.018
ugv_lug.019
ugv_lug.020
ugv_lug.021
ugv_lug.022
ugv_lug.023
ugv_lug.024
ugv_lug.025
ugv_lug.026
ugv_lug.027
ugv_w.002
ugv_hub.002
ugv_lug.028
ugv_lug.029
ugv_lug.030
ugv_lug.031
ugv_lug.032
ugv_lug.033
ugv_lug.034
ugv_lug.035
ugv_lug.036
ugv_lug.037
ugv_lug.038
ugv_lug.039
ugv_lug.040
ugv_lug.041
ugv_w.003
ugv_hub.003
ugv_lug.042
ugv_lug.043
ugv_lug.044
ugv_lug.045
ugv_lug.046
ugv_lug.047
ugv_lug.048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
