LakshanandSugumar/agrobo/world/models/tomato_fruit_green/meshes/tomato_fruit_green.obj

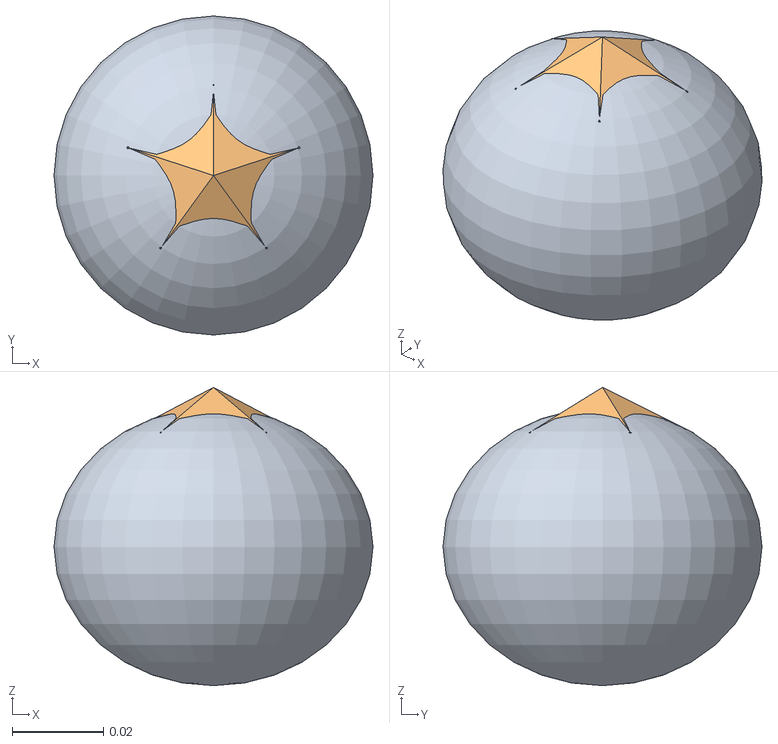
[picture p48: CAD file, 2026-10-21]
world/models/tomato_fruit_green/meshes/tomato_fruit_green.obj
0.07 x 0.07 x 0.0655
fruit
calyx
