LakshanandSugumar/agrobo/world/models/tomato_plant_fruiting_0_fruit_0/meshes/tomato_plant_fruiting_0_fruit_0.obj

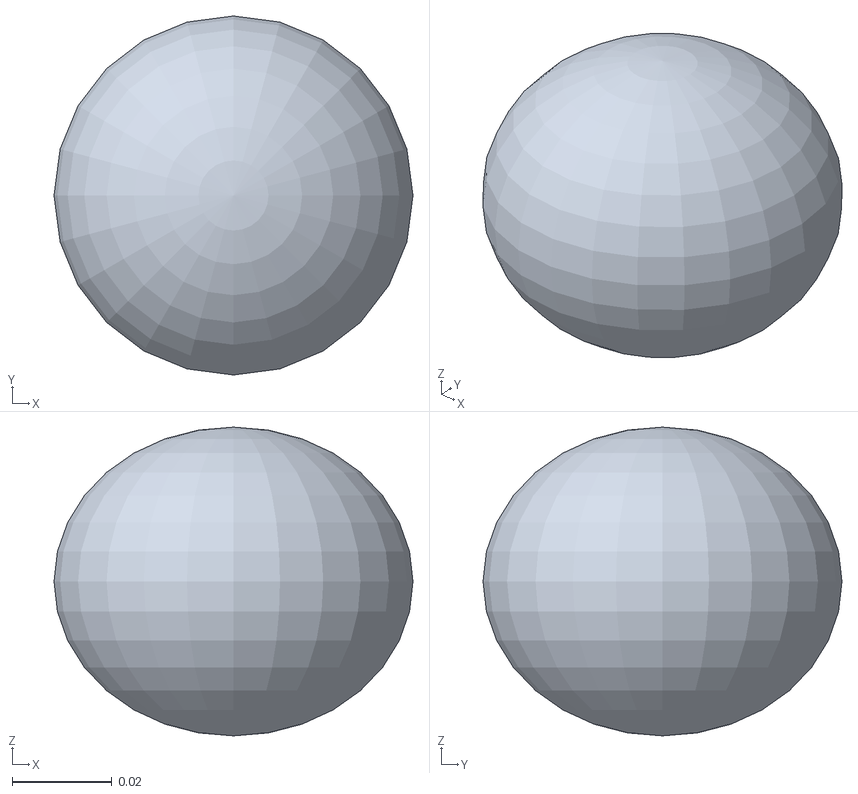
[picture p50: CAD file, 2026-10-21]
world/models/tomato_plant_fruiting_0_fruit_0/meshes/tomato_plant_fruiting_0_fruit_0.obj
0.072 x 0.072 x 0.0619
