LakshanandSugumar/agrobo/world/models/tomato_plant_fruiting_0_fruit_1/meshes/tomato_plant_fruiting_0_fruit_1.obj

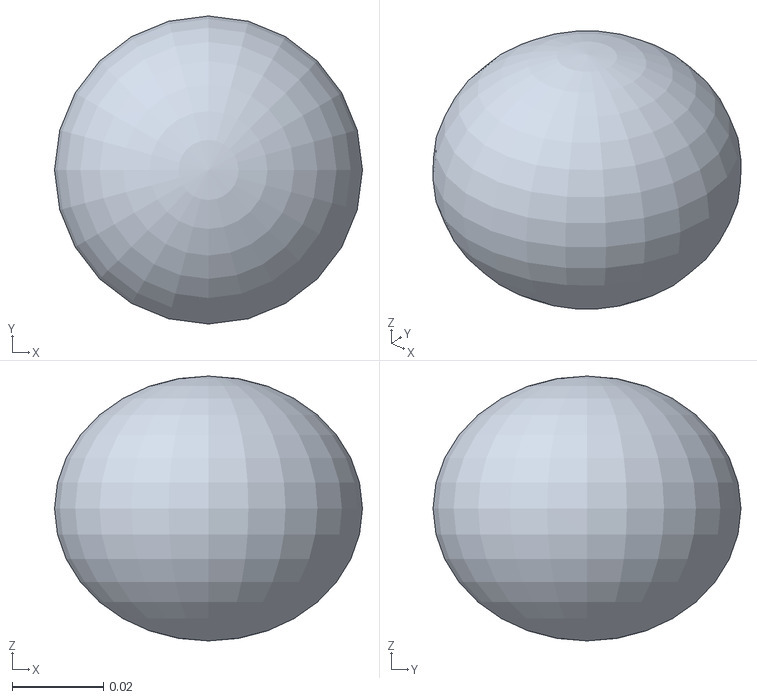
[picture p51: CAD file, 2026-10-21]
world/models/tomato_plant_fruiting_0_fruit_1/meshes/tomato_plant_fruiting_0_fruit_1.obj
0.0674 x 0.0674 x 0.058
