LakshanandSugumar/agrobo/world/models/tomato_plant_fruiting_0_fruit_2/meshes/tomato_plant_fruiting_0_fruit_2.obj

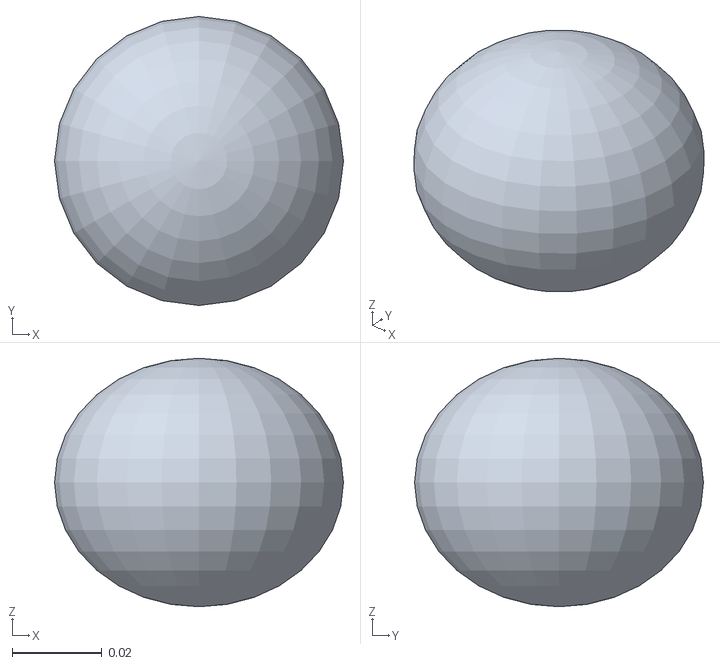
[picture p52: CAD file, 2026-10-21]
world/models/tomato_plant_fruiting_0_fruit_2/meshes/tomato_plant_fruiting_0_fruit_2.obj
0.0645 x 0.0645 x 0.0554
