LakshanandSugumar/agrobo/world/models/tomato_plant_fruiting_0_fruit_3/meshes/tomato_plant_fruiting_0_fruit_3.obj

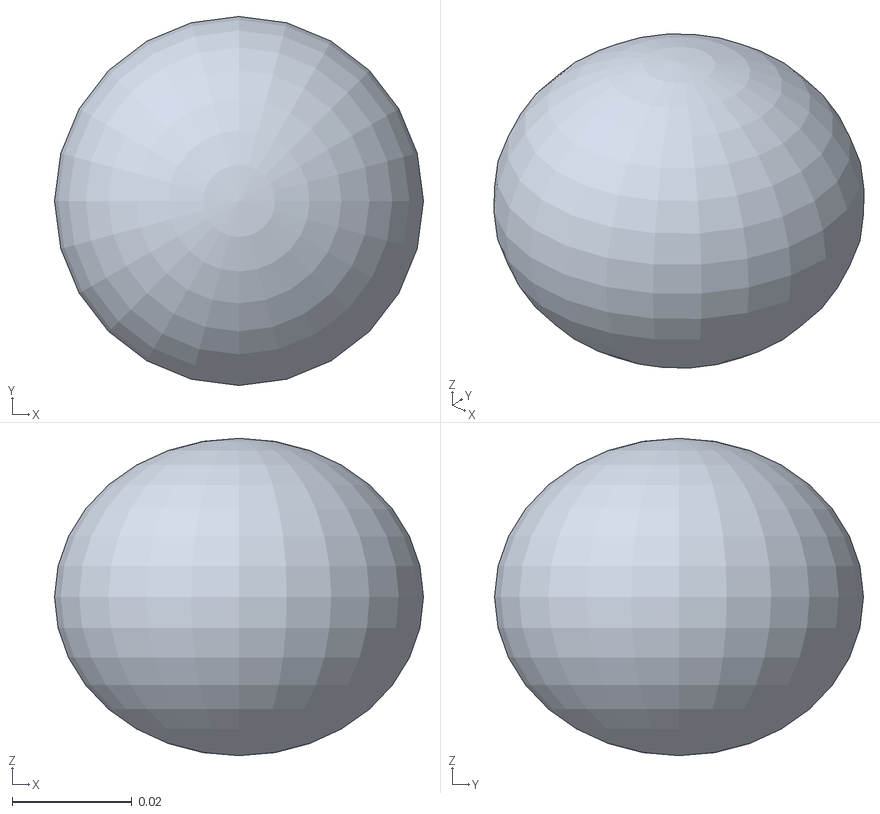
[picture p53: CAD file, 2026-10-21]
world/models/tomato_plant_fruiting_0_fruit_3/meshes/tomato_plant_fruiting_0_fruit_3.obj
0.0617 x 0.0617 x 0.0531
