LakshanandSugumar/agrobo/world/models/tomato_plant_fruiting_0_fruit_4/meshes/tomato_plant_fruiting_0_fruit_4.obj

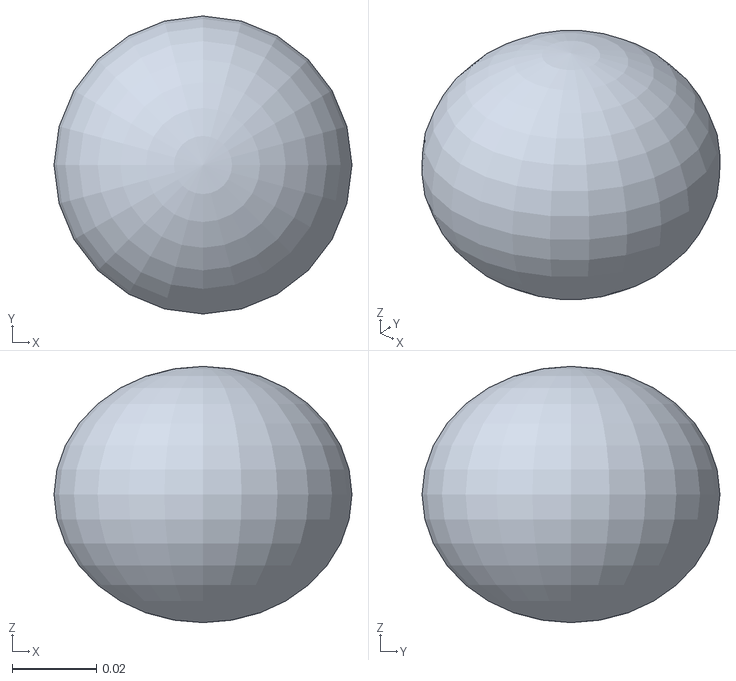
[picture p54: CAD file, 2026-10-21]
world/models/tomato_plant_fruiting_0_fruit_4/meshes/tomato_plant_fruiting_0_fruit_4.obj
0.0706 x 0.0706 x 0.0607
