LakshanandSugumar/agrobo/world/models/tomato_plant_fruiting_1/meshes/tomato_plant_fruiting_1_foliage.obj

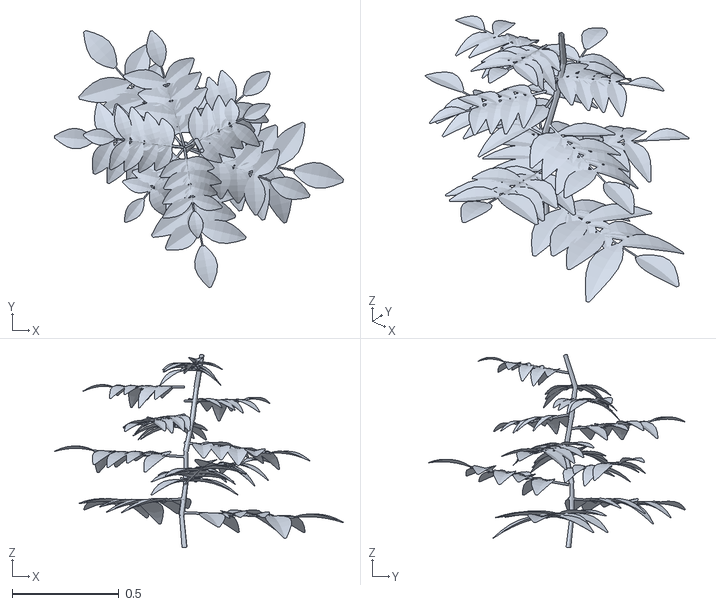
[picture p55: CAD file, 2026-10-21]
world/models/tomato_plant_fruiting_1/meshes/tomato_plant_fruiting_1_foliage.obj
1.35 x 1.20 x 0.905
