LakshanandSugumar/agrobo/world/models/tomato_plant_fruiting_1_fruit_0/meshes/tomato_plant_fruiting_1_fruit_0.obj

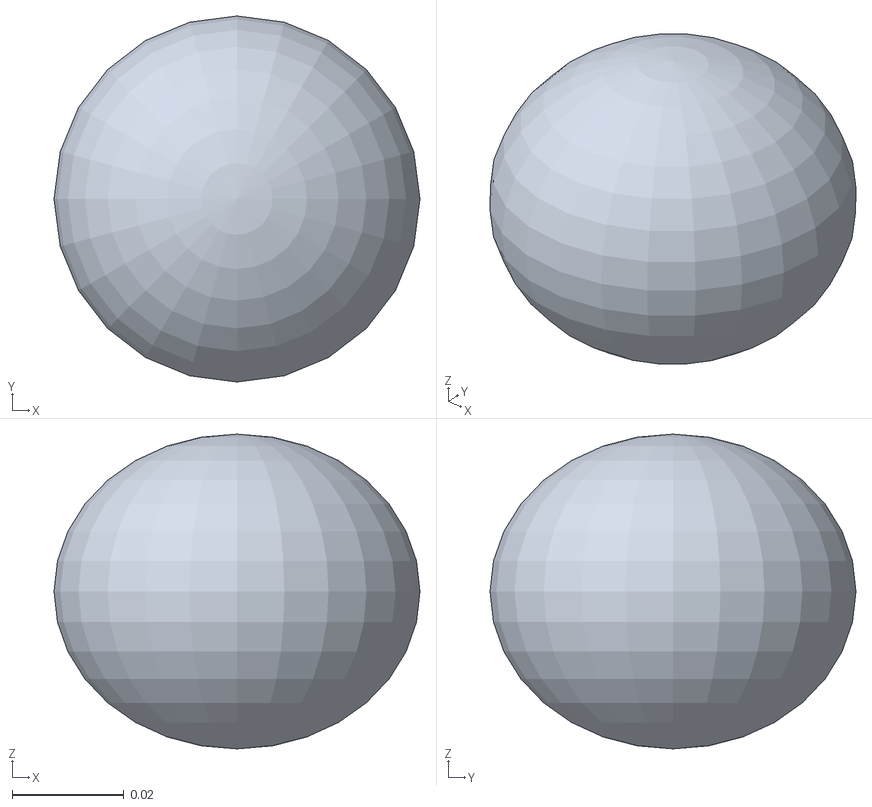
[picture p56: CAD file, 2026-10-21]
world/models/tomato_plant_fruiting_1_fruit_0/meshes/tomato_plant_fruiting_1_fruit_0.obj
0.0654 x 0.0654 x 0.0562
