LakshanandSugumar/agrobo/world/models/tomato_plant_fruiting_1_fruit_1/meshes/tomato_plant_fruiting_1_fruit_1.obj

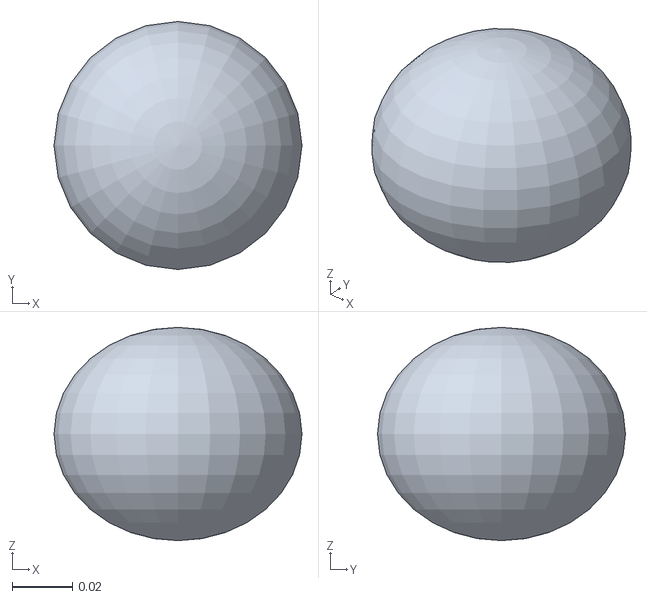
[picture p57: CAD file, 2026-10-21]
world/models/tomato_plant_fruiting_1_fruit_1/meshes/tomato_plant_fruiting_1_fruit_1.obj
0.0825 x 0.0825 x 0.0709
