LakshanandSugumar/agrobo/world/models/tomato_plant_fruiting_1_fruit_2/meshes/tomato_plant_fruiting_1_fruit_2.obj

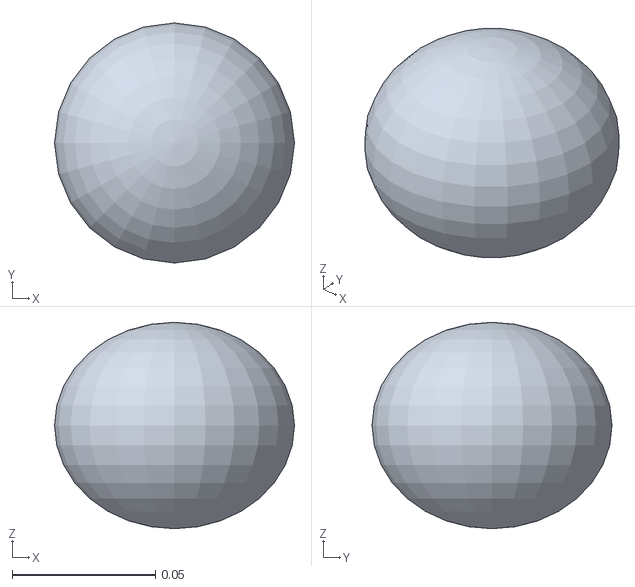
[picture p58: CAD file, 2026-10-21]
world/models/tomato_plant_fruiting_1_fruit_2/meshes/tomato_plant_fruiting_1_fruit_2.obj
0.0836 x 0.0836 x 0.0719
