LakshanandSugumar/agrobo/world/models/tomato_plant_fruiting_1_fruit_4/meshes/tomato_plant_fruiting_1_fruit_4.obj

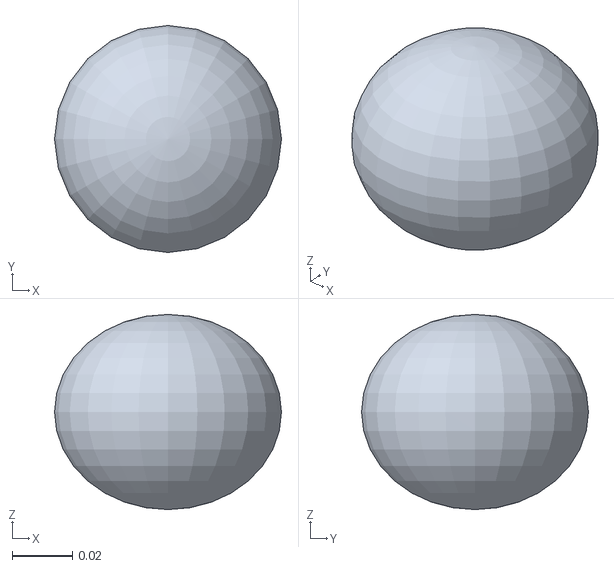
[picture p59: CAD file, 2026-10-21]
world/models/tomato_plant_fruiting_1_fruit_4/meshes/tomato_plant_fruiting_1_fruit_4.obj
0.0755 x 0.0755 x 0.065
