LakshanandSugumar/agrobo/world/models/tomato_plant_fruiting_2/meshes/tomato_plant_fruiting_2_foliage.obj

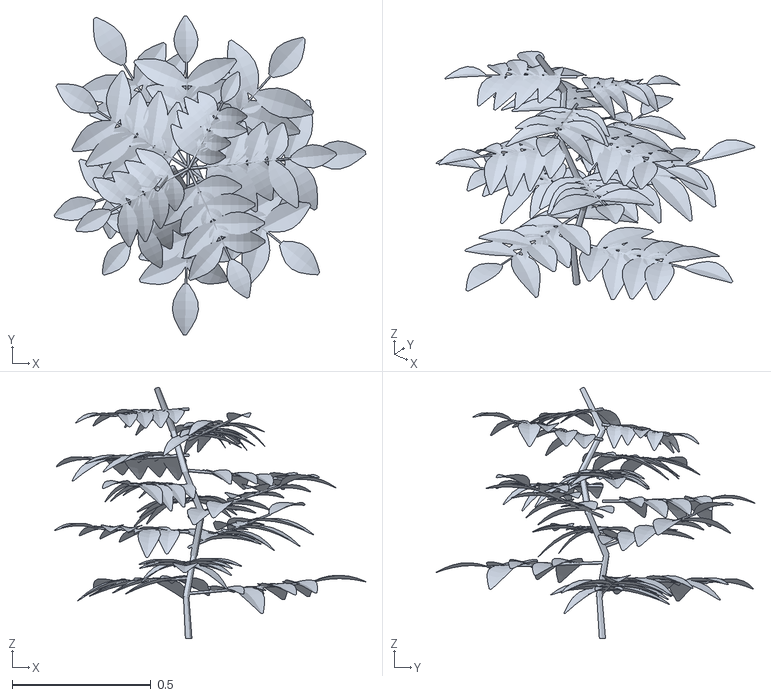
[picture p60: CAD file, 2026-10-21]
world/models/tomato_plant_fruiting_2/meshes/tomato_plant_fruiting_2_foliage.obj
1.12 x 1.15 x 0.906
