LakshanandSugumar/agrobo/world/models/tomato_plant_fruiting_2_fruit_2/meshes/tomato_plant_fruiting_2_fruit_2.obj

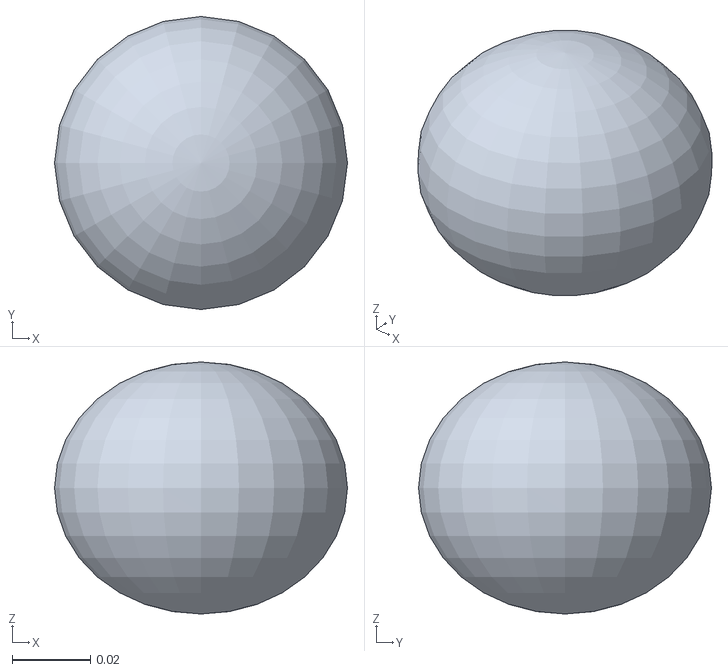
[picture p61: CAD file, 2026-10-21]
world/models/tomato_plant_fruiting_2_fruit_2/meshes/tomato_plant_fruiting_2_fruit_2.obj
0.075 x 0.075 x 0.0645
