LakshanandSugumar/agrobo/world/models/tomato_plant_seedling_1/meshes/tomato_plant_seedling_1_foliage.obj

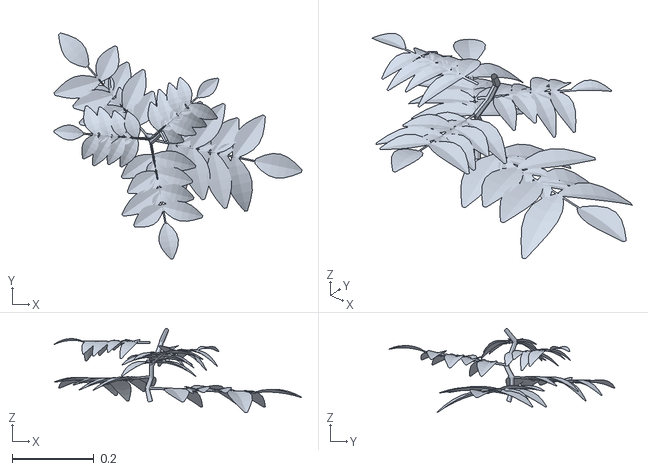
[picture p63: CAD file, 2026-10-21]
world/models/tomato_plant_seedling_1/meshes/tomato_plant_seedling_1_foliage.obj
0.608 x 0.554 x 0.207
