LakshanandSugumar/agrobo/world/models/tomato_plant_seedling_2/meshes/tomato_plant_seedling_2.obj

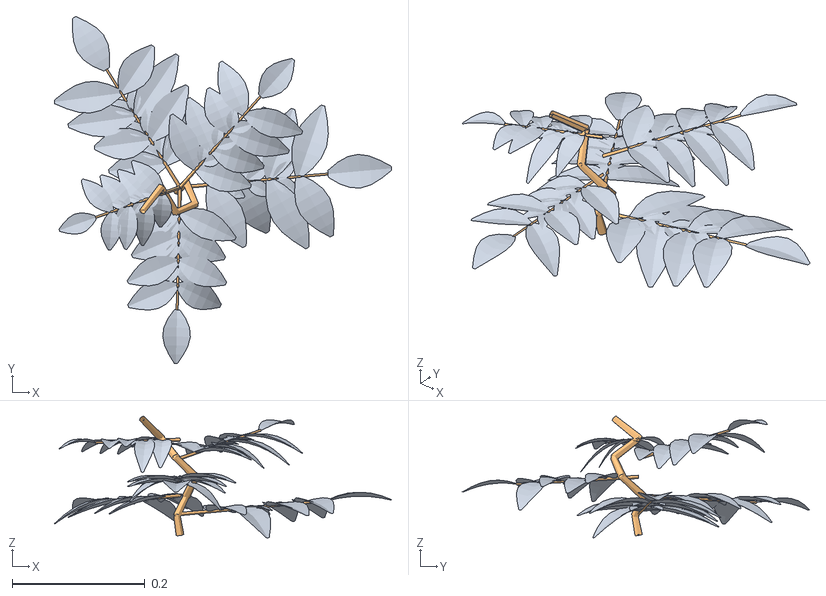
[picture p64: CAD file, 2026-10-21]
world/models/tomato_plant_seedling_2/meshes/tomato_plant_seedling_2.obj
0.509 x 0.523 x 0.184
p_leaves
p_stem
