LakshanandSugumar/agrobo/world/models/tomato_plant_vegetative_0/meshes/tomato_plant_vegetative_0_foliage.obj

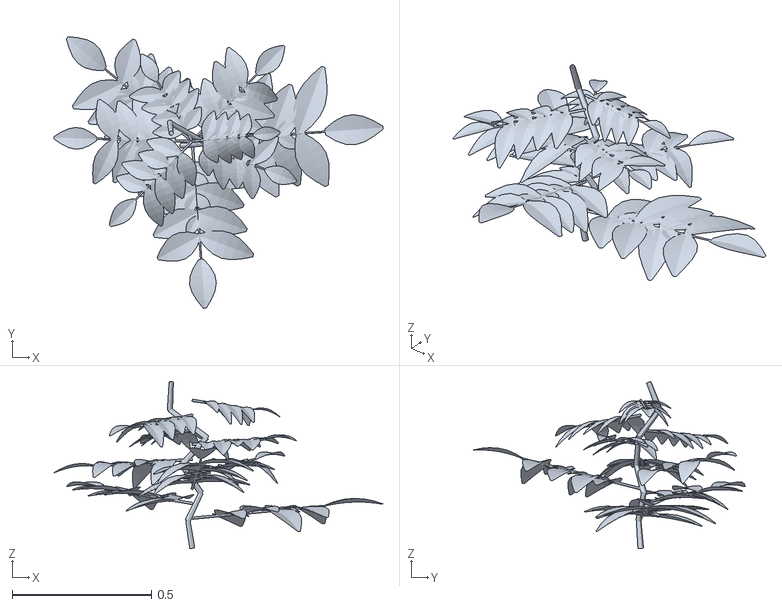
[picture p65: CAD file, 2026-10-21]
world/models/tomato_plant_vegetative_0/meshes/tomato_plant_vegetative_0_foliage.obj
1.18 x 0.975 x 0.6
