LakshanandSugumar/agrobo/world/models/tomato_plant_vegetative_1/meshes/tomato_plant_vegetative_1.obj

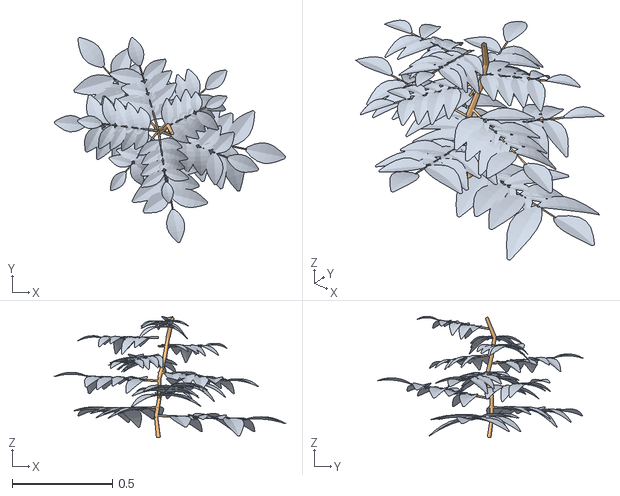
[picture p66: CAD file, 2026-10-21]
world/models/tomato_plant_vegetative_1/meshes/tomato_plant_vegetative_1.obj
1.15 x 1.02 x 0.603
p_leaves
p_stem
