LakshanandSugumar/agrobo/world/models/tomato_plant_vegetative_2/meshes/tomato_plant_vegetative_2.obj

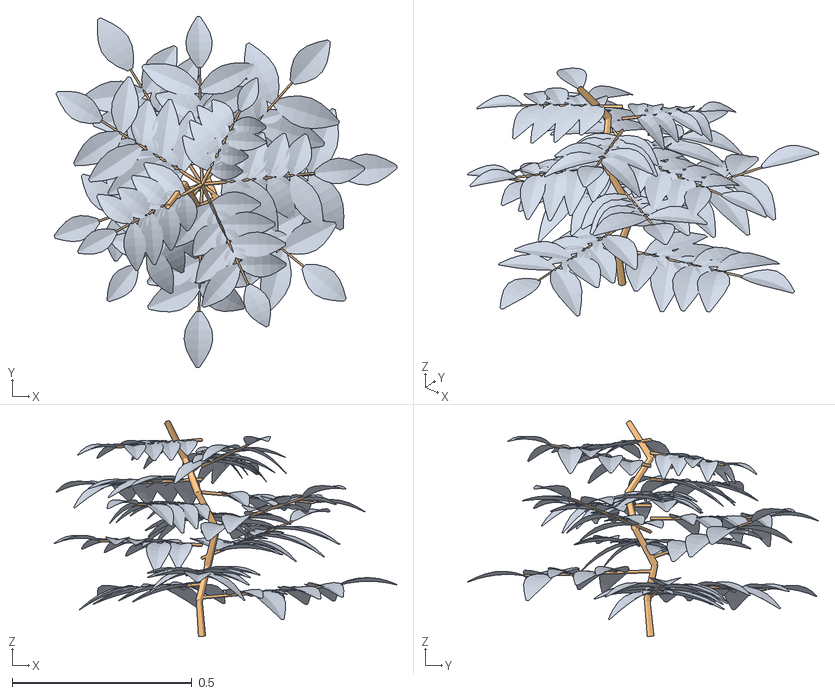
[picture p67: CAD file, 2026-10-21]
world/models/tomato_plant_vegetative_2/meshes/tomato_plant_vegetative_2.obj
0.955 x 0.977 x 0.602
p_leaves
p_stem
