LakshanandSugumar/agrobo/world/models/weed_seedling/meshes/weed_seedling_2s.obj

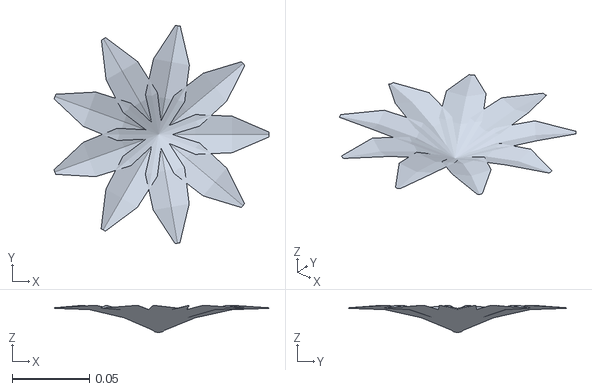
[picture p68: CAD file, 2026-10-21]
world/models/weed_seedling/meshes/weed_seedling_2s.obj
0.139 x 0.142 x 0.0178
