LakshanandSugumar/agrobo/robots/cad/dxf/AB1-201_deck_plate_3mm_5052.dxf

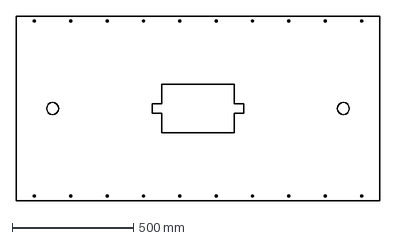
[picture p69: CAD file, 2026-10-21]
robots/cad/dxf/AB1-201_deck_plate_3mm_5052.dxf
1500.0 x 760.0 mm
