LakshanandSugumar/agrobo/robots/cad/step/EE1-005_cam_bracket.step

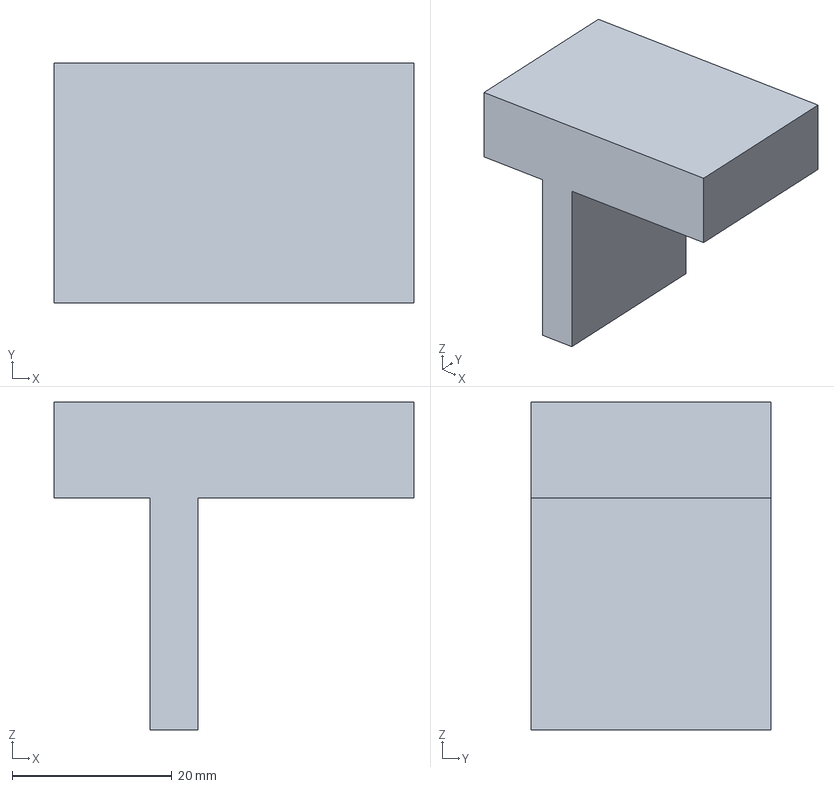
[picture p70: CAD file, 2026-10-21]
robots/cad/step/EE1-005_cam_bracket.step
45.0 x 30.0 x 41.0 mm
