LakshanandSugumar/agrobo/robots/urdf/agrobo_description/meshes/ee_body.stl

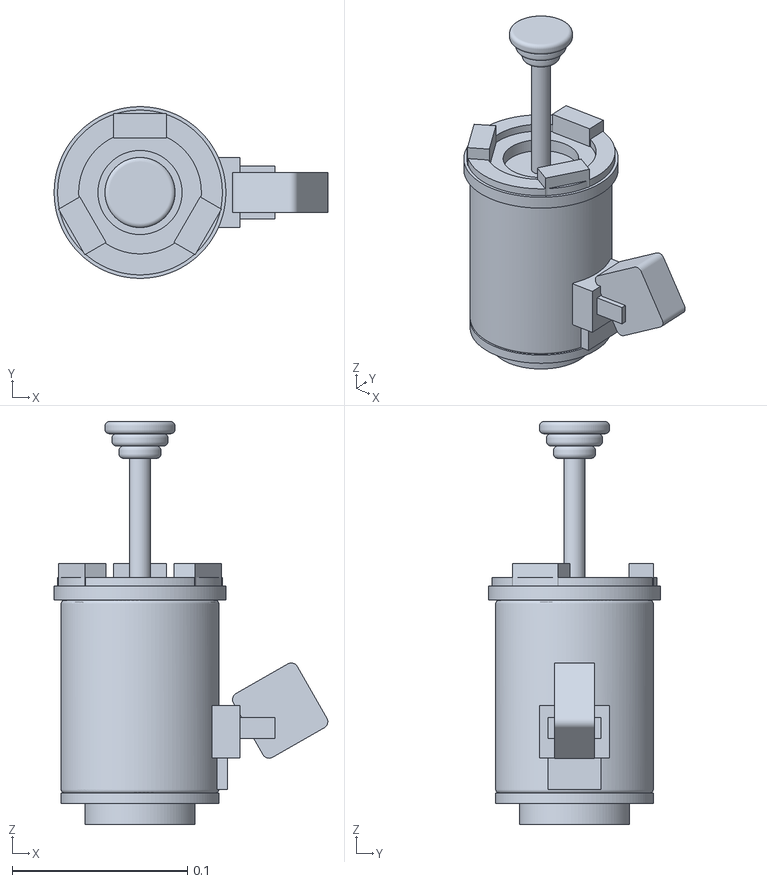
[picture p71: CAD file, 2026-10-21]
robots/urdf/agrobo_description/meshes/ee_body.stl
0.156 x 0.098 x 0.23
