LakshanandSugumar/agrobo/world/models/tomato_plant_fruiting_0/meshes/tomato_plant_fruiting_0_foliage.obj

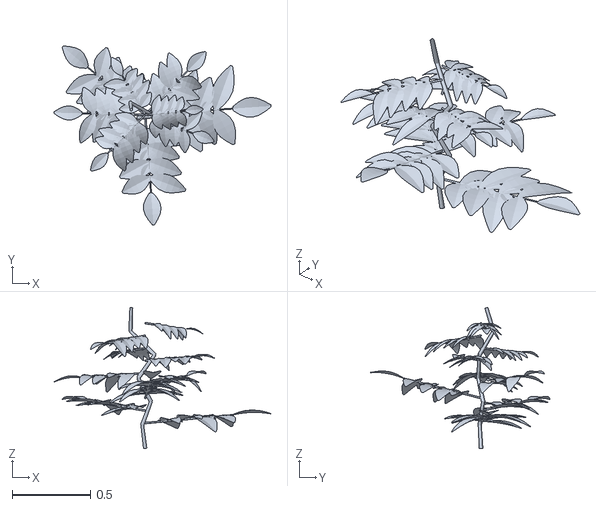
[picture p72: CAD file, 2026-10-21]
world/models/tomato_plant_fruiting_0/meshes/tomato_plant_fruiting_0_foliage.obj
1.39 x 1.15 x 0.905
