LakshanandSugumar/agrobo/world/models/tomato_plant_fruiting_1/meshes/tomato_plant_fruiting_1.obj

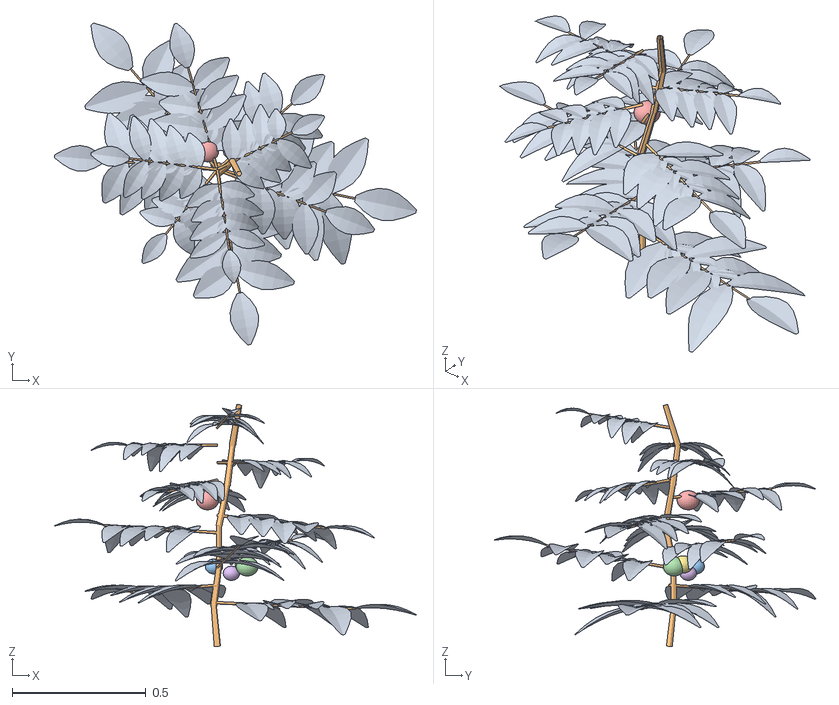
[picture p73: CAD file, 2026-10-21]
world/models/tomato_plant_fruiting_1/meshes/tomato_plant_fruiting_1.obj
1.35 x 1.20 x 0.905
p_leaves
p_stem
p_fr0
p_fr1
p_fr2
p_fr3
p_fr4
