LakshanandSugumar/agrobo/world/models/tomato_plant_fruiting_2/meshes/tomato_plant_fruiting_2.obj

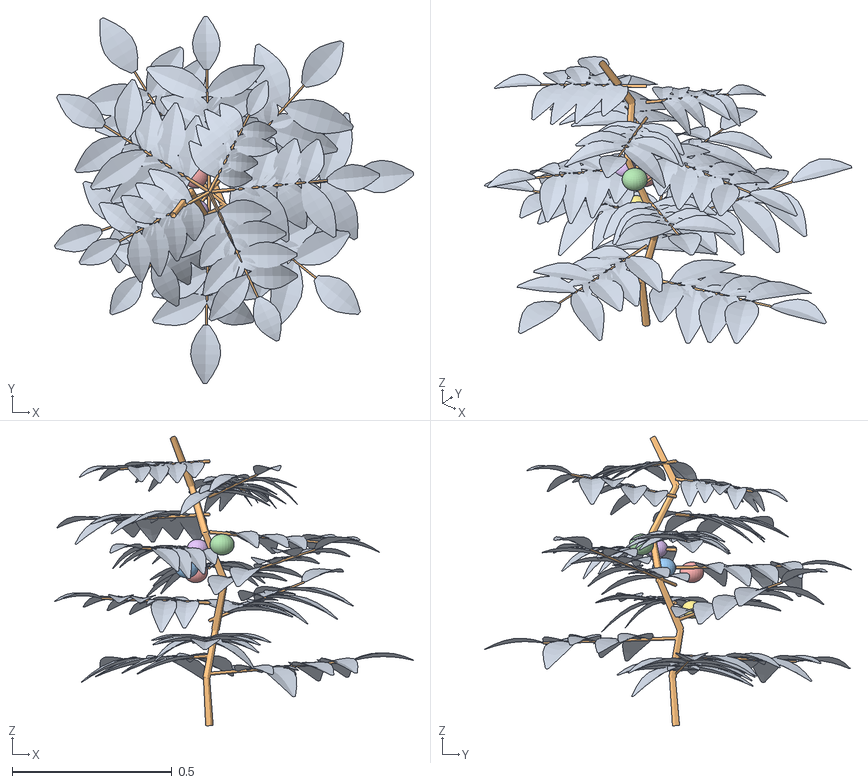
[picture p74: CAD file, 2026-10-21]
world/models/tomato_plant_fruiting_2/meshes/tomato_plant_fruiting_2.obj
1.12 x 1.15 x 0.906
p_leaves
p_stem
p_fr0
p_fr1
p_fr2
p_fr3
p_fr4
