LakshanandSugumar/agrobo/world/models/tomato_plant_seedling_0/meshes/tomato_plant_seedling_0_foliage.obj

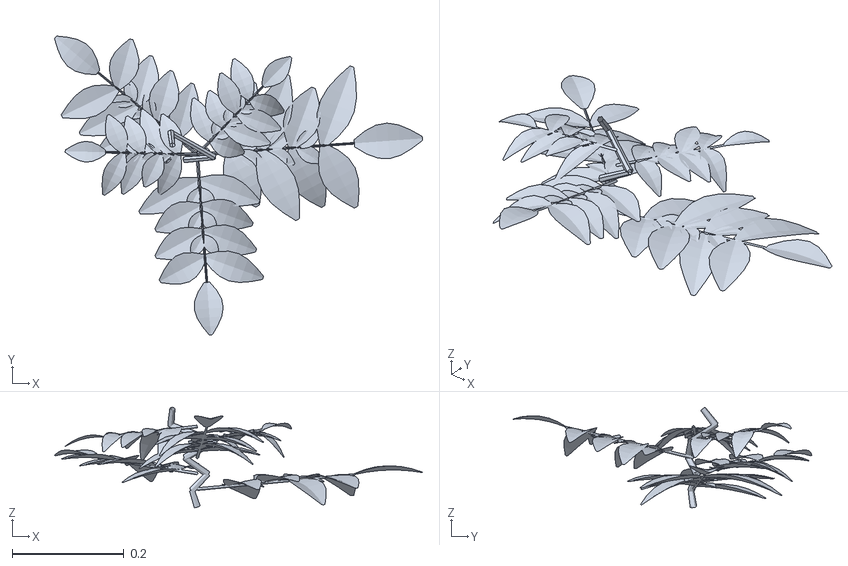
[picture p75: CAD file, 2026-10-21]
world/models/tomato_plant_seedling_0/meshes/tomato_plant_seedling_0_foliage.obj
0.658 x 0.534 x 0.18
