LakshanandSugumar/agrobo/world/models/tomato_plant_seedling_2/meshes/tomato_plant_seedling_2_foliage.obj

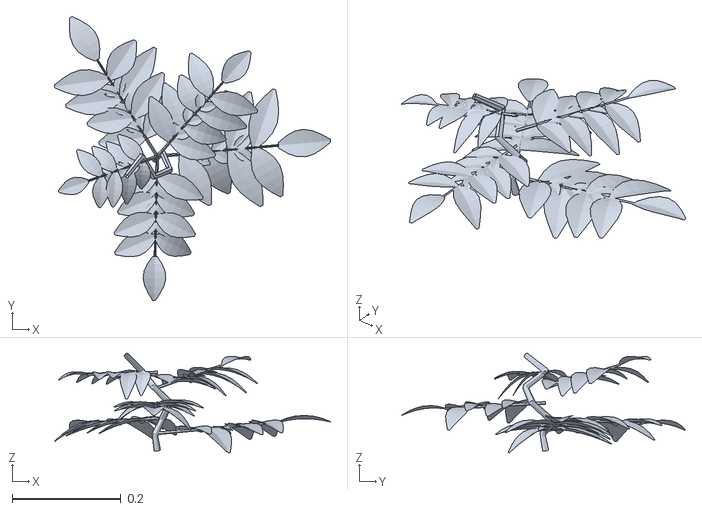
[picture p77: CAD file, 2026-10-21]
world/models/tomato_plant_seedling_2/meshes/tomato_plant_seedling_2_foliage.obj
0.509 x 0.523 x 0.184
