LakshanandSugumar/agrobo/world/models/tomato_plant_vegetative_0/meshes/tomato_plant_vegetative_0.obj

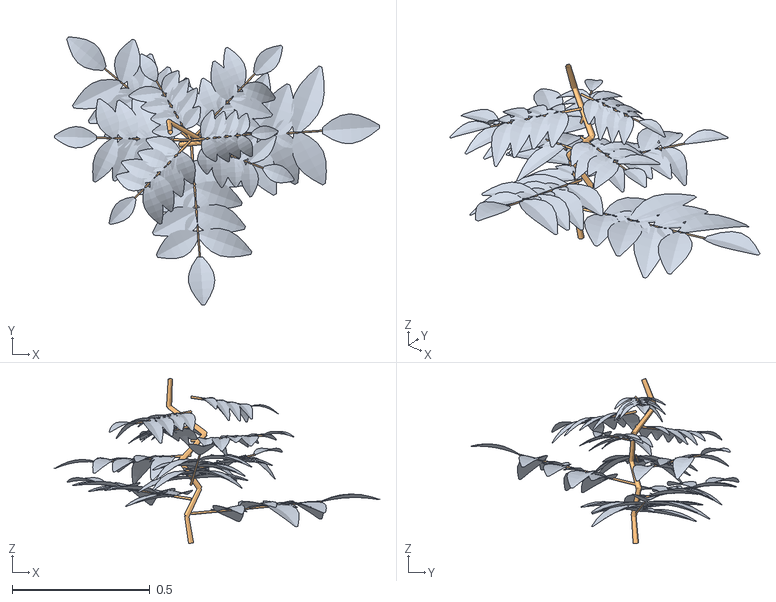
[picture p78: CAD file, 2026-10-21]
world/models/tomato_plant_vegetative_0/meshes/tomato_plant_vegetative_0.obj
1.18 x 0.975 x 0.6
p_leaves
p_stem
