LakshanandSugumar/agrobo/world/models/tomato_plant_vegetative_1/meshes/tomato_plant_vegetative_1_foliage.obj

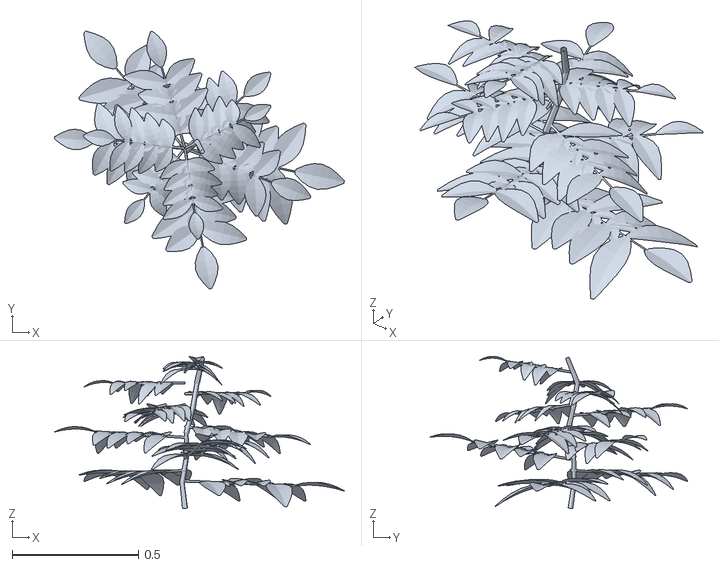
[picture p79: CAD file, 2026-10-21]
world/models/tomato_plant_vegetative_1/meshes/tomato_plant_vegetative_1_foliage.obj
1.15 x 1.02 x 0.603
