LakshanandSugumar/agrobo/robots/cad/dxf/AB1-202_axle_plate_10mm_6061_x4.dxf

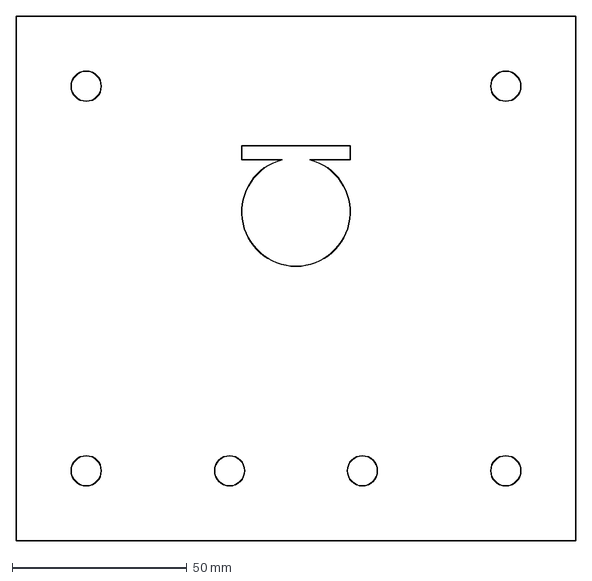
[picture p82: CAD file, 2026-10-21]
robots/cad/dxf/AB1-202_axle_plate_10mm_6061_x4.dxf
160.0 x 150.0 mm
