LakshanandSugumar/agrobo/robots/cad/step/EE1-003_front_plate.step

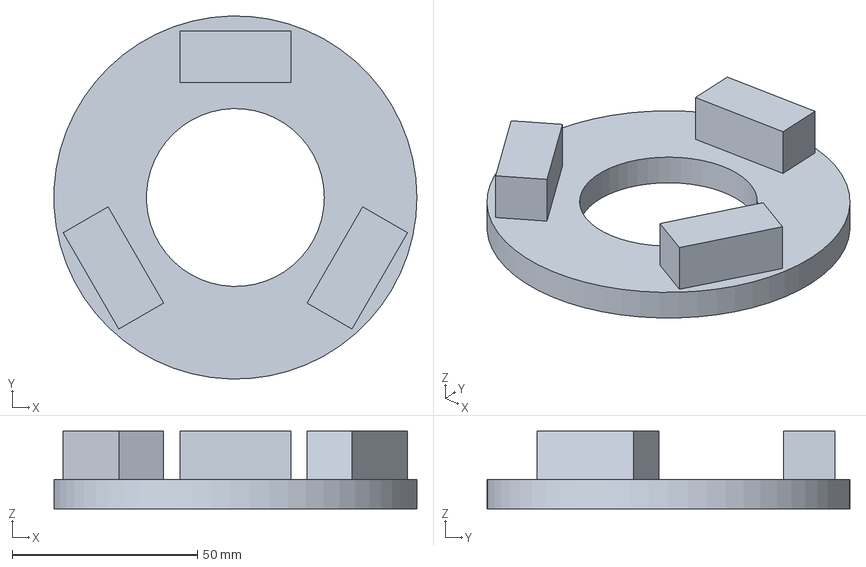
[picture p83: CAD file, 2026-10-21]
robots/cad/step/EE1-003_front_plate.step
97.9 x 98.0 x 21.0 mm
