LakshanandSugumar/agrobo/robots/urdf/agrobo_description/meshes/base_chassis.stl

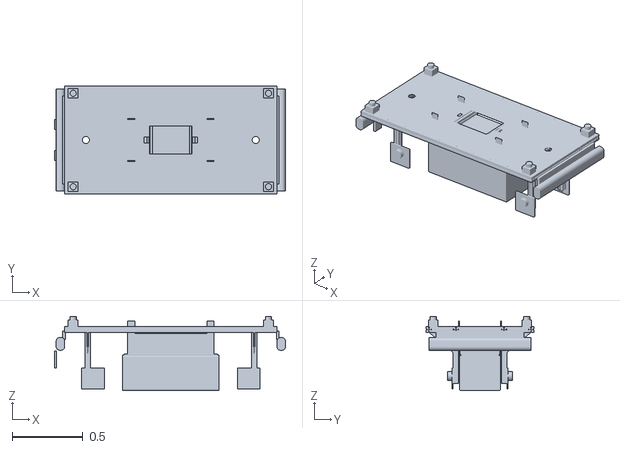
[picture p84: CAD file, 2026-10-21]
robots/urdf/agrobo_description/meshes/base_chassis.stl
1.63 x 0.76 x 0.524
