LakshanandSugumar/agrobo/robots/urdf/agrobo_description/meshes/arm_wrist_1.stl

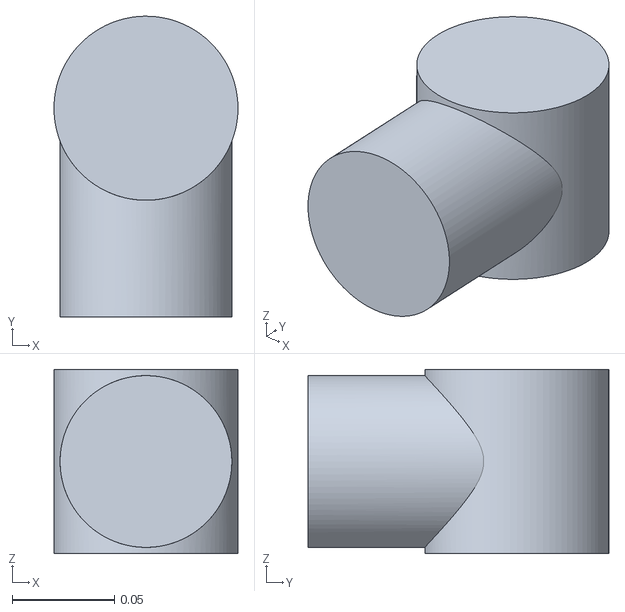
[picture p85: CAD file, 2026-10-21]
robots/urdf/agrobo_description/meshes/arm_wrist_1.stl
0.09 x 0.147 x 0.09
