LakshanandSugumar/agrobo/robots/cad/step/EE1-001_flange_adapter.step

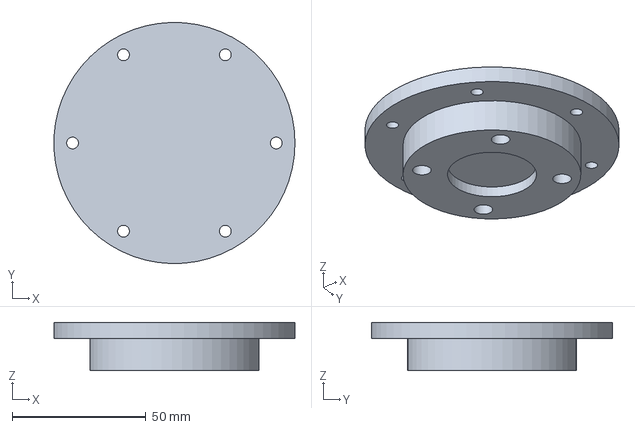
[picture p86: CAD file, 2026-10-21]
robots/cad/step/EE1-001_flange_adapter.step
89.9 x 90.0 x 18.0 mm
