LakshanandSugumar/agrobo/robots/urdf/agrobo_description/meshes/harvester_totes.stl

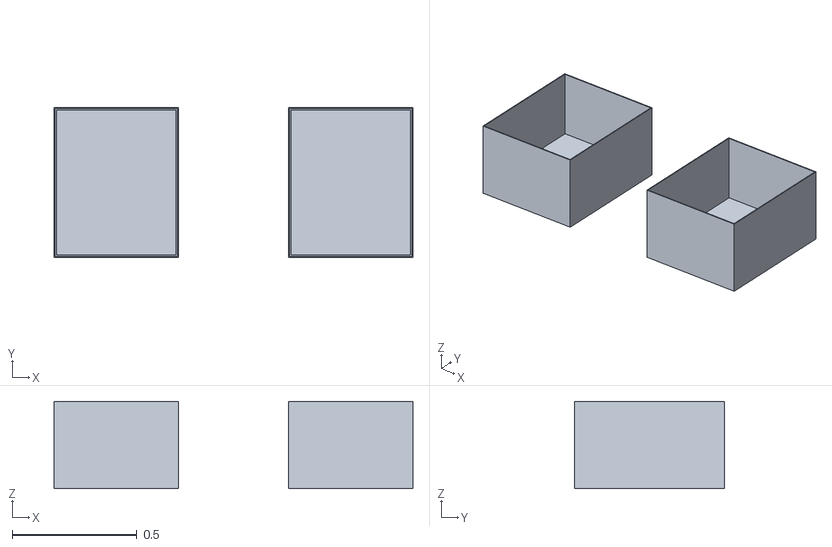
[picture p87: CAD file, 2026-10-21]
robots/urdf/agrobo_description/meshes/harvester_totes.stl
1.44 x 0.6 x 0.35
