LakshanandSugumar/agrobo/robots/urdf/agrobo_description/meshes/arm_upper_arm.stl

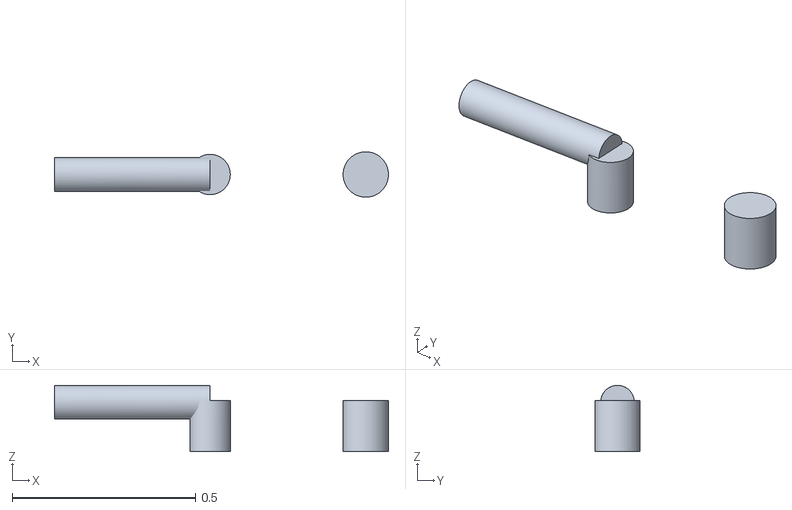
[picture p88: CAD file, 2026-10-21]
robots/urdf/agrobo_description/meshes/arm_upper_arm.stl
0.912 x 0.124 x 0.181
