LakshanandSugumar/agrobo/robots/cad/step/AB1-202_axle_plate.step

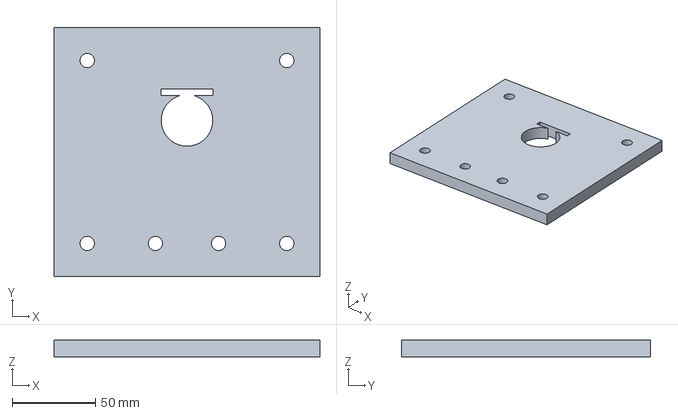
[picture p89: CAD file, 2026-10-21]
robots/cad/step/AB1-202_axle_plate.step
160.0 x 150.0 x 10.0 mm
