LakshanandSugumar/agrobo/robots/urdf/agrobo_description/meshes/wheel.stl

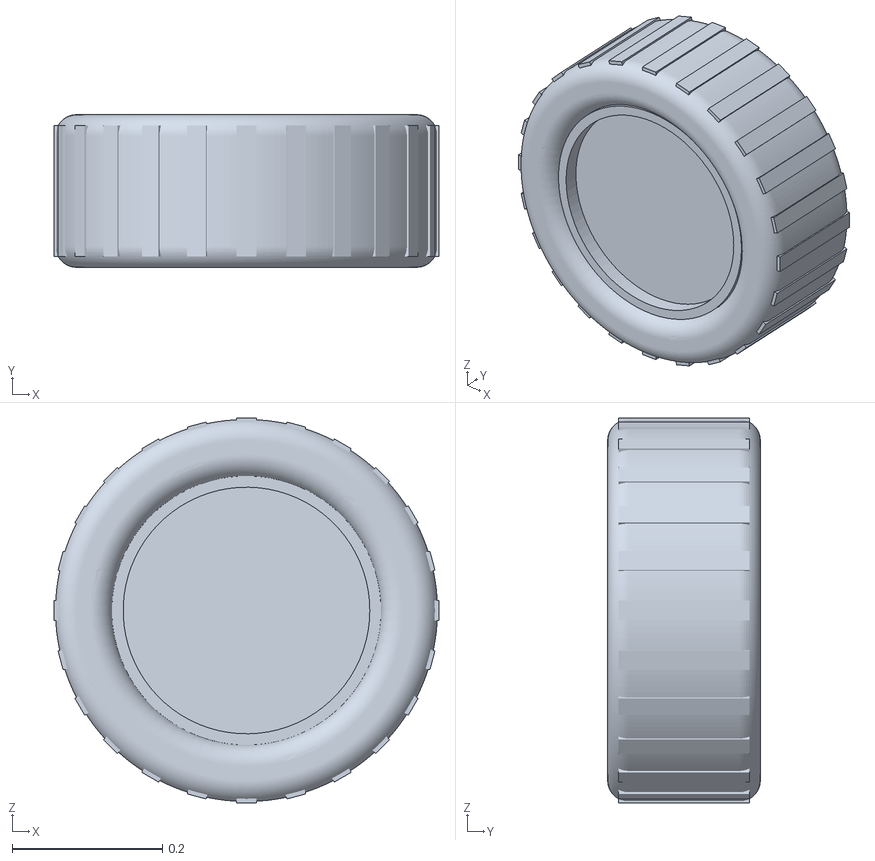
[picture p90: CAD file, 2026-10-21]
robots/urdf/agrobo_description/meshes/wheel.stl
0.512 x 0.203 x 0.512
