LakshanandSugumar/agrobo/robots/cad/step/AB1-201_deck_plate.step

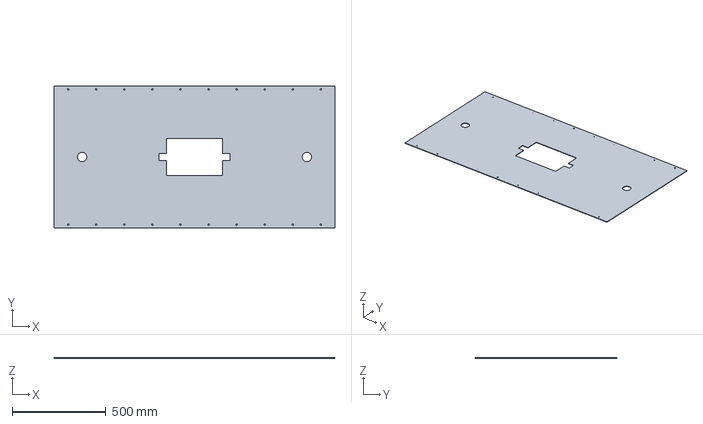
[picture p91: CAD file, 2026-10-21]
robots/cad/step/AB1-201_deck_plate.step
1500.0 x 760.0 x 3.00 mm
