LakshanandSugumar/agrobo/robots/urdf/agrobo_description/meshes/harvester_mast.stl

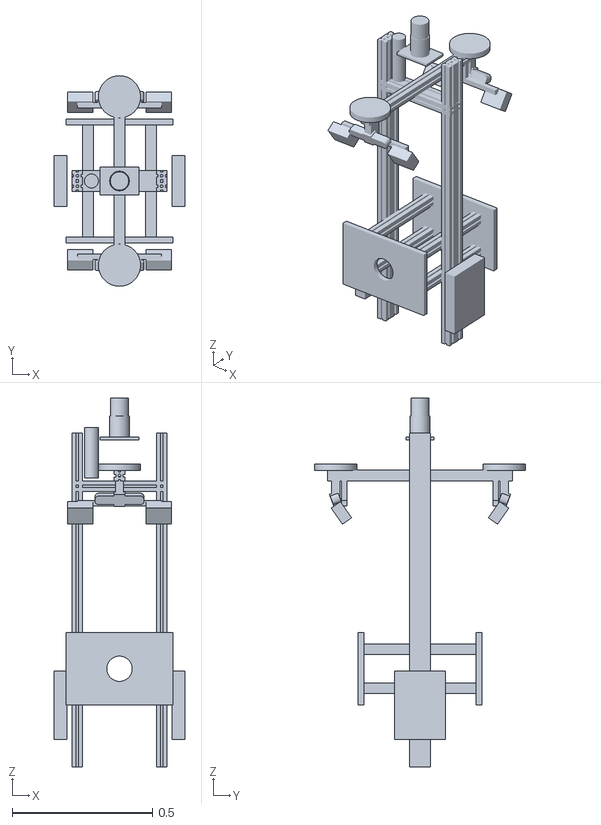
[picture p92: CAD file, 2026-10-21]
robots/urdf/agrobo_description/meshes/harvester_mast.stl
0.465 x 0.75 x 1.31
