LakshanandSugumar/agrobo/robots/urdf/agrobo_description/meshes/arm_arm_base.stl

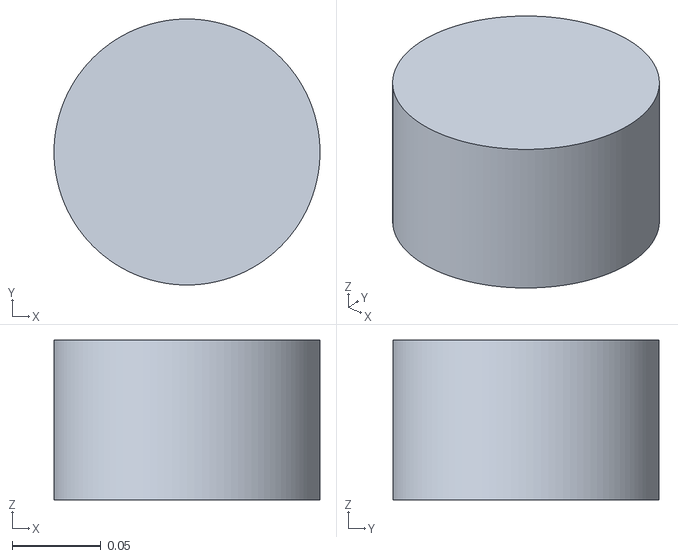
[picture p93: CAD file, 2026-10-21]
robots/urdf/agrobo_description/meshes/arm_arm_base.stl
0.15 x 0.15 x 0.09
