LakshanandSugumar/agrobo/robots/cad/step/EE1-002_housing.step

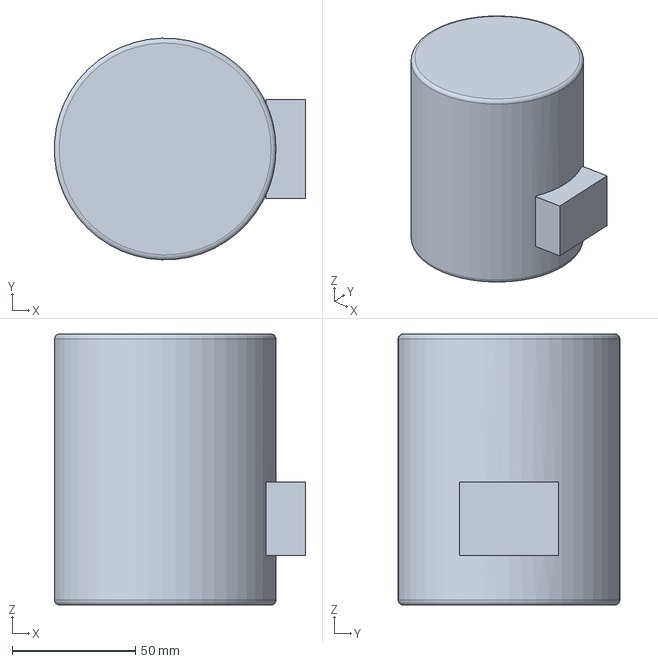
[picture p94: CAD file, 2026-10-21]
robots/cad/step/EE1-002_housing.step
101.9 x 90.0 x 110.0 mm
