LakshanandSugumar/agrobo/robots/urdf/agrobo_description/meshes/arm_wrist_2.stl

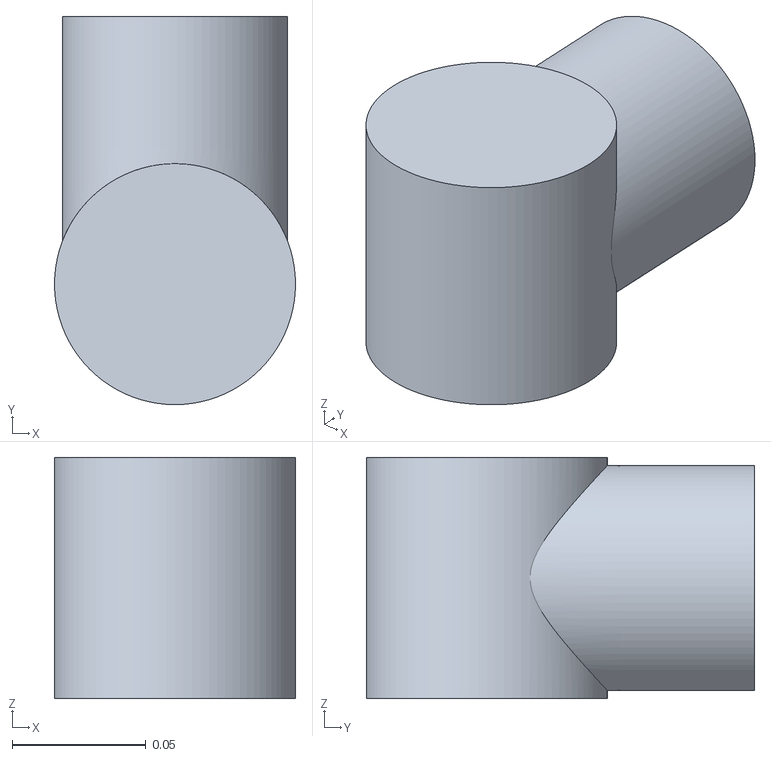
[picture p95: CAD file, 2026-10-21]
robots/urdf/agrobo_description/meshes/arm_wrist_2.stl
0.09 x 0.145 x 0.09
