LakshanandSugumar/agrobo/robots/cad/step/EE1-004_finger_single.step

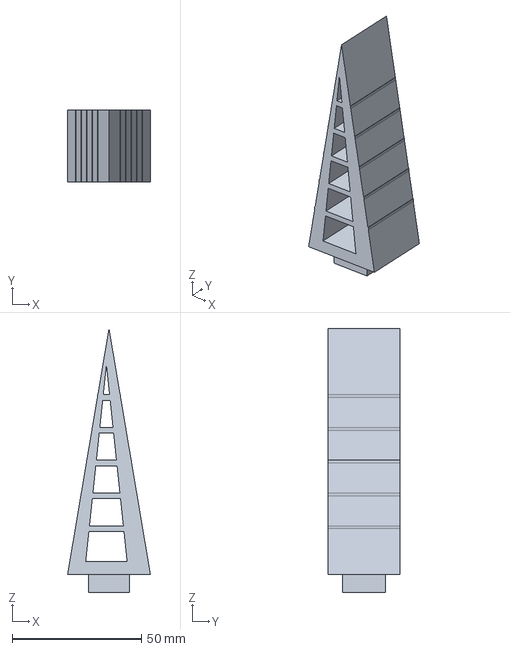
[picture p96: CAD file, 2026-10-21]
robots/cad/step/EE1-004_finger_single.step
32.0 x 28.0 x 102.0 mm
