LakshanandSugumar/agrobo/robots/urdf/agrobo_description/meshes/ee_finger.stl

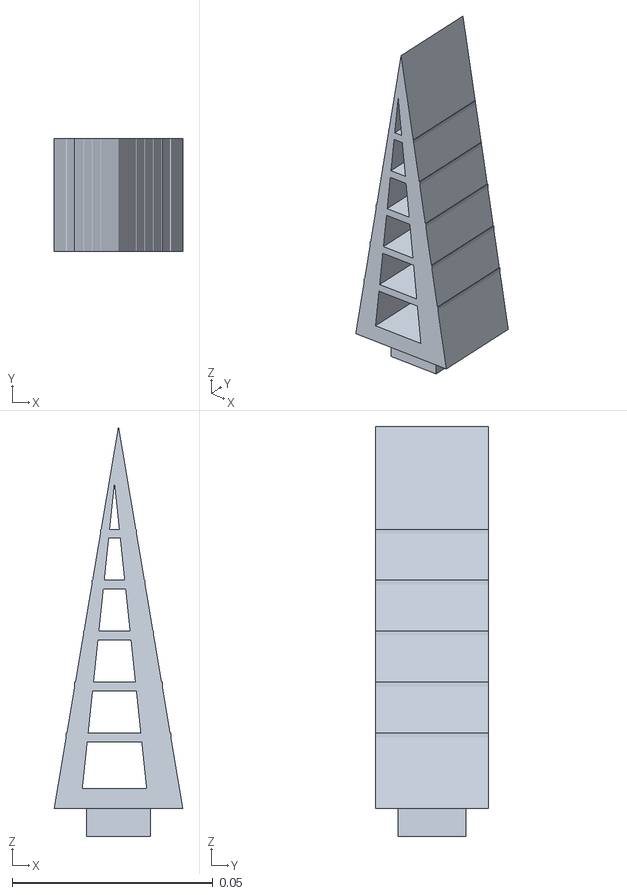
[picture p97: CAD file, 2026-10-21]
robots/urdf/agrobo_description/meshes/ee_finger.stl
0.032 x 0.028 x 0.102
