LakshanandSugumar/agrobo/robots/urdf/agrobo_description/meshes/arm_shoulder.stl

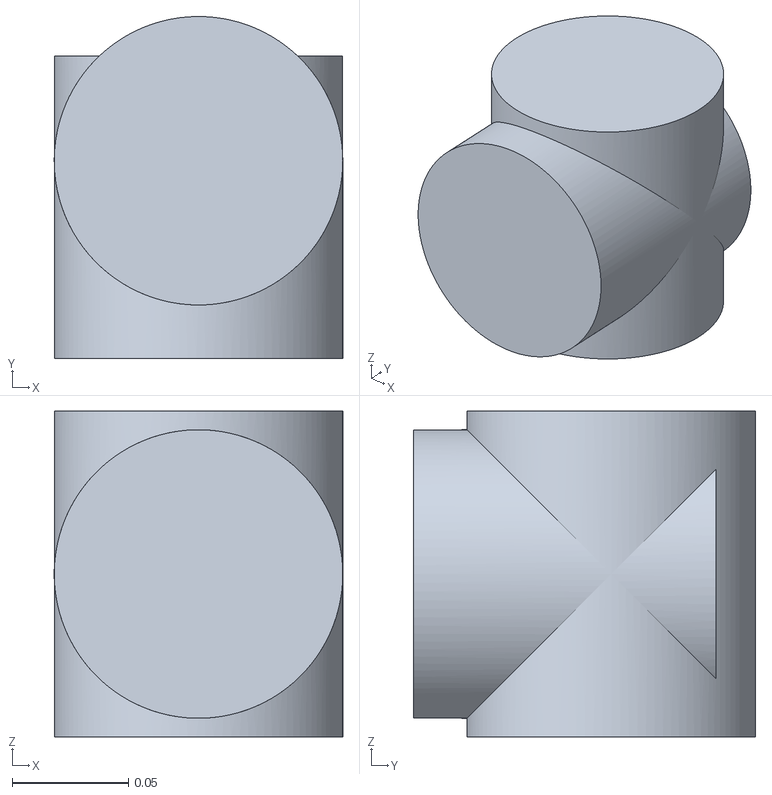
[picture p98: CAD file, 2026-10-21]
robots/urdf/agrobo_description/meshes/arm_shoulder.stl
0.124 x 0.147 x 0.14
