LakshanandSugumar/agrobo/robots/urdf/agrobo_description/meshes/arm_forearm.stl

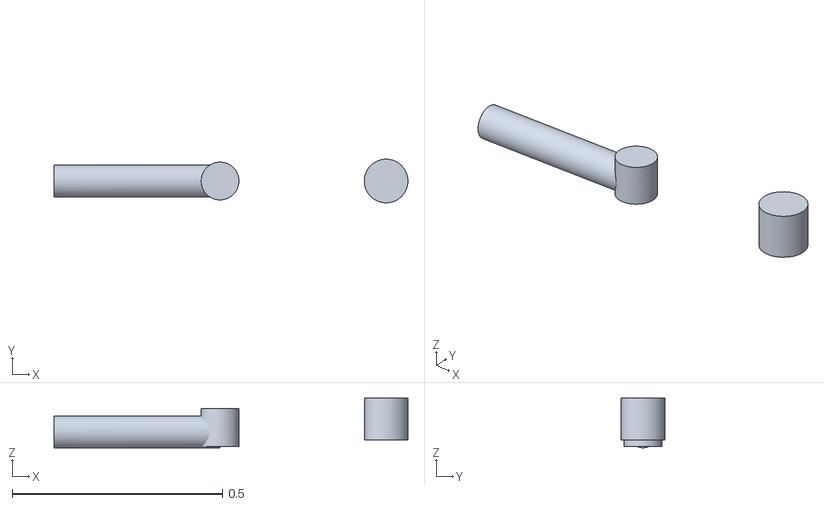
[picture p99: CAD file, 2026-10-21]
robots/urdf/agrobo_description/meshes/arm_forearm.stl
0.842 x 0.104 x 0.118
