LakshanandSugumar/agrobo/(list of files, cad)

Other CAD files:
world/models/tomato_fruit_red/meshes/tomato_fruit_red.obj
world/models/tomato_fruit_turning/meshes/tomato_fruit_turning.obj
world/models/tomato_plant_fruiting_1_fruit_3/meshes/tomato_plant_fruiting_1_fruit_3.obj
world/models/tomato_plant_fruiting_2_fruit_0/meshes/tomato_plant_fruiting_2_fruit_0.obj
world/models/tomato_plant_fruiting_2_fruit_1/meshes/tomato_plant_fruiting_2_fruit_1.obj
world/models/tomato_plant_fruiting_2_fruit_3/meshes/tomato_plant_fruiting_2_fruit_3.obj
world/models/tomato_plant_fruiting_2_fruit_4/meshes/tomato_plant_fruiting_2_fruit_4.obj
robots/cad/stl/EE1-001_flange_adapter.stl
robots/cad/stl/EE1-002_housing.stl
robots/cad/stl/EE1-003_front_plate.stl
robots/cad/stl/EE1-004_finger_single.stl
robots/cad/stl/EE1-005_cam_bracket.stl
