LakshanandSugumar/agrobo/robots/calc/results.md

# AB-1 / HM-1 design calculations

Generated by `calc/design_calcs.py` from `cad/src/params.py`. Inputs are engineering estimates; items marked *verify* need a bench or field measurement on the first prototype.

## 1. Mass budget and centre of gravity

| Item | kg | CoG z (m) |
|---|---:|---:|
| deck frame + legs + brackets | 95.0 | 0.50 |
| LFP keel pack 10.75 kWh | 78.0 | 0.28 |
| 4x hub motor + tyre | 78.0 | 0.25 |
| electronics enclosure + cooler (under deck) | 28.0 | 0.48 |
| 2x FR5 arm | 44.0 | 0.95 |
| 2x arm controller | 5.0 | 0.70 |
| mast + sensors + lights | 28.0 | 1.25 |
| 2x end-effector | 2.2 | 0.95 |
| 2x totes, full (35 kg fruit each) | 76.0 | 0.75 |
| **Gross (crates full)** | **434** | **0.556** |

Empty totes: 364 kg, CoG z 0.519 m.

## 2. Static stability

- Lateral tip-over angle (arms stowed): **27.5 deg**
- Lateral tip-over, one arm fully out to the downhill side with fruit: **25.9 deg** (CoG shift 20 mm)
- Longitudinal tip-over angle: **44.7 deg**
- Florida vegetable fields are < 2 deg; the bed shoulder can tilt one side by ~6 deg if a tyre rides up on it. Required margin: tip angle >= 3x worst operating tilt (6 deg -> 18 deg). Result: PASS.
- Software limit: arms may not extend beyond 0.6 m lateral when IMU roll > 8 deg.

## 3. Traction and drive motors

- Rolling resistance: Crr 0.15 (loose sand), 0.25 (wet furrow), +5 % grade.
- Continuous tractive force 852 N -> **54 N m per wheel** (motor rated 130 N m).
- Peak (wet furrow + 0.3 g) 2556 N -> **162 N m per wheel** (motor peak 200 N m).
- Traction limit at mu = 0.5 (wet sand): 2130 N > peak demand: SLIP RISK.
- Drive power at 1.5 m/s transit: 1597 W total (80 % drivetrain efficiency).
- Wheel speed at 1.5 m/s: 56 rpm (hub motor runs 45 km/h at 10 in rim, so it is torque-limited, not speed-limited; run it in FOC current mode with the VESC). *Verify* low-speed torque ripple below 0.1 m/s on the bench.

## 4. Power budget and runtime

| Load | Harvesting W | Transit W |
|---|---:|---:|
| drive (4 hub motors, crawl/stop-go while picking) | 250 | 1597 |
| 2x FR5 arm (avg while picking) | 360 | 80 |
| Jetson AGX Orin 64GB (MAXN) | 60 | 45 |
| cameras (2 ZED X, 2 D405) + lidar + GNSS + IMU | 35 | 25 |
| network (5G router + mesh radio) | 18 | 18 |
| LED work lights (night ~50 % of hours) | 100 | 0 |
| enclosure thermoelectric cooler (FL summer) | 150 | 150 |
| 2x vacuum pump + valves | 30 | 0 |
| EE servos + ring lights | 16 | 2 |
| safety controller, BMS, contactors, misc | 20 | 20 |
| **Total incl. 5 % DC-DC loss** | **1094** | **2039** |

- Pack: 16S2P EVE LF105 = 51.2 V x 210 Ah = **10.75 kWh**, 90 % usable = 9.68 kWh.
- Runtime harvesting: **8.8 h**; transit only: 4.7 h.
- Dock charge at 3.5 kW (Delta-Q IC3500-class, CC to 85 % + taper): 2.9 h.
- Achievable duty with autonomous dock charging: **17.8 h/day** (prototype economics assumed 18 h/day with hot swaps; see docs/09_cost_vs_model.md).

## 5. Arm workspace coverage (fruit band, near half of canopy)

- Shoulder at y = 0.372 m, z = 0.95 m, side-mounted. Row centre 0.915 m from aisle centre.
- Fruit band z 0.45-1.4 m, canopy depth 0.35 m, +/-0.45 m along the row per stop.
- Effective reach to grasp centre with approach standoff: 0.800 m.
- **Coverage: 99.8 %** of sampled fruit positions are reachable from one stop (remaining ones are on the far side of the row and get picked from the next aisle).

## 6. Pick cycle-time budget (per arm)

| Step | s |
|---|---:|
| approach from previous fruit (twin-predicted target, no search) | 2.5 |
| visual servo final 10 cm with D405 (closed loop) | 1.8 |
| suction engage + finger close (current-limited 3.6 N) | 0.8 |
| twist 120 deg + pull (detach at calyx, jointless variety) | 1.2 |
| retract + place in crate (soft drop < 10 cm) | 2.6 |
| verify + log fruit id in Field Ledger | 0.1 |
| **Total per fruit per arm** | **9.0** |

- Two arms at 85 % utilisation: **680 fruit/h per robot** = 5.3 s/fruit robot-level (prototype sim modelled 8.0 s/fruit twin-guided, so the sim is the conservative case). Published research pickers run 10-25 s/fruit per arm; 9 s/arm is a v1 target to prove on the bench, not a measured number.
- At 0.20 kg mature-green fruit: 136 kg/h; 2 totes (70 kg) fill in 31 min, so the hauler must swap totes at least that often.

## 7. Ground pressure

- Per-tyre load 109 kg; footprint ~195 cm2 at 10 psi -> **55 kPa** (human foot ~ 25-60 kPa; tractors 80-150 kPa). Low compaction in the aisle; no beds are driven on.
