LakshanandSugumar/agrobo/preview/results.png

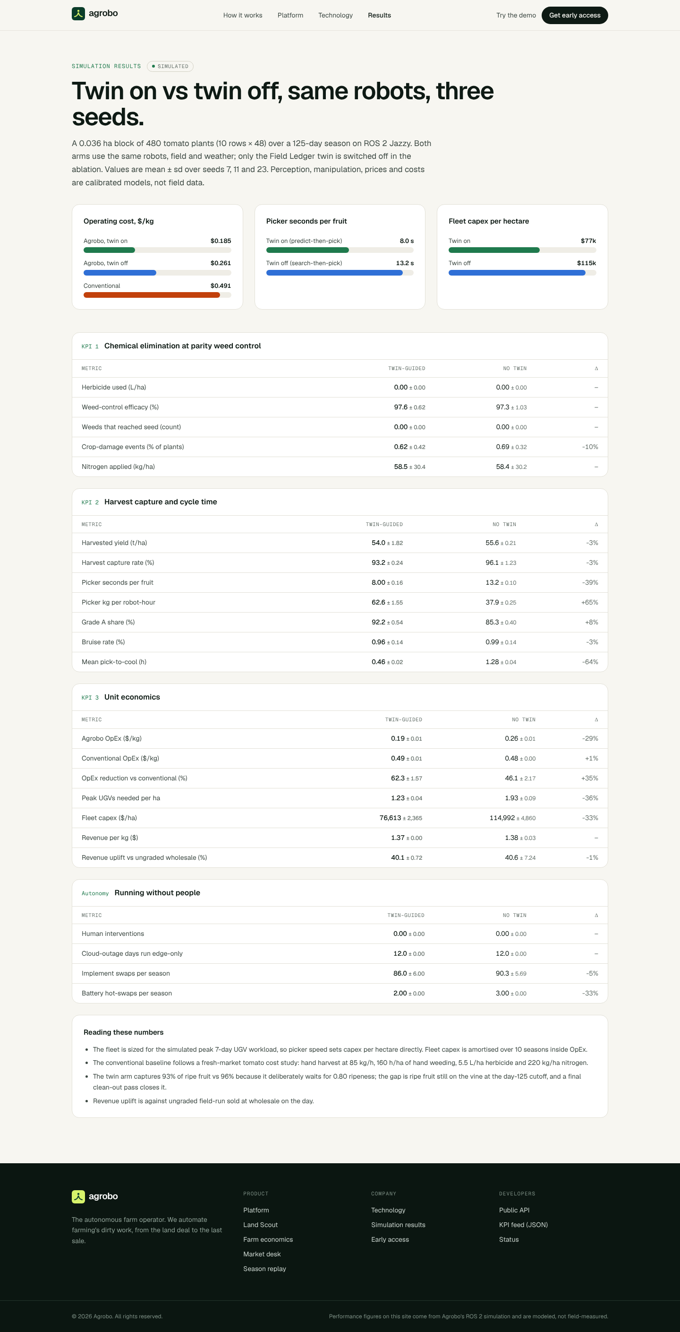
preview/results.png
