LakshanandSugumar/agrobo/robots/urdf/agrobo_description/agrobo_harvester.relative.urdf

<?xml version="1.0"?>
<!-- Agrobo HM-1 harvester on AB-1 base. GENERATED by urdf/generate_urdf.py from cad/src/params.py. Do not hand-edit. -->
<robot name="agrobo_harvester">
  <link name="base_footprint">
  </link>
  <link name="base_link">
    <inertial><origin xyz="0 0 0.42"/><mass value="213"/><inertia ixx="9.9844" iyy="43.532" izz="46.327" ixy="0" ixz="0" iyz="0"/></inertial>
    <visual><geometry><mesh filename="meshes/base_chassis.stl"/></geometry><material name="grey"><color rgba="0.78 0.8 0.82 1"/></material></visual>
    <collision><origin xyz="0 0 0.58" rpy="0 0 0"/><geometry><box size="1.6 0.76 0.04"/></geometry></collision>
    <collision><origin xyz="0 0 0.275" rpy="0 0 0"/><geometry><box size="0.68 0.29 0.25"/></geometry></collision>
    <collision><origin xyz="0 0 0.48" rpy="0 0 0"/><geometry><box size="0.6 0.28 0.15"/></geometry></collision>
    <collision><origin xyz="0.78 0 0.48" rpy="0 0 0"/><geometry><box size="0.06 0.72 0.09"/></geometry></collision>
    <collision><origin xyz="-0.78 0 0.48" rpy="0 0 0"/><geometry><box size="0.06 0.72 0.09"/></geometry></collision>
    <collision><origin xyz="0.55 0.17 0.39" rpy="0 0 0"/><geometry><box size="0.16 0.05 0.38"/></geometry></collision>
    <collision><origin xyz="0.55 -0.17 0.39" rpy="0 0 0"/><geometry><box size="0.16 0.05 0.38"/></geometry></collision>
    <collision><origin xyz="-0.55 0.17 0.39" rpy="0 0 0"/><geometry><box size="0.16 0.05 0.38"/></geometry></collision>
    <collision><origin xyz="-0.55 -0.17 0.39" rpy="0 0 0"/><geometry><box size="0.16 0.05 0.38"/></geometry></collision>
  </link>
  <joint name="base_footprint_joint" type="fixed"><parent link="base_footprint"/><child link="base_link"/><origin xyz="0 0 0" rpy="0 0 0"/>
  </joint>
  <link name="front_left_wheel">
    <inertial><origin xyz="0 0 0"/><mass value="19.5"/><inertia ixx="0.38148" iyy="0.62903" izz="0.38148" ixy="0" ixz="0" iyz="0"/></inertial>
    <visual><geometry><mesh filename="meshes/wheel.stl"/></geometry><material name="dark"><color rgba="0.15 0.15 0.16 1"/></material></visual>
    <collision><origin xyz="0 0 0" rpy="1.5708 0 0"/><geometry><cylinder radius="0.254" length="0.203"/></geometry></collision>
  </link>
  <joint name="front_left_wheel_joint" type="continuous"><parent link="base_link"/><child link="front_left_wheel"/><origin xyz="0.55 0.29 0.254" rpy="0 0 0"/>
    <axis xyz="0 1 0"/>
  </joint>
  <link name="front_right_wheel">
    <inertial><origin xyz="0 0 0"/><mass value="19.5"/><inertia ixx="0.38148" iyy="0.62903" izz="0.38148" ixy="0" ixz="0" iyz="0"/></inertial>
    <visual><geometry><mesh filename="meshes/wheel.stl"/></geometry><material name="dark"><color rgba="0.15 0.15 0.16 1"/></material></visual>
    <collision><origin xyz="0 0 0" rpy="1.5708 0 0"/><geometry><cylinder radius="0.254" length="0.203"/></geometry></collision>
  </link>
  <joint name="front_right_wheel_joint" type="continuous"><parent link="base_link"/><child link="front_right_wheel"/><origin xyz="0.55 -0.29 0.254" rpy="0 0 0"/>
    <axis xyz="0 1 0"/>
  </joint>
  <link name="rear_left_wheel">
    <inertial><origin xyz="0 0 0"/><mass value="19.5"/><inertia ixx="0.38148" iyy="0.62903" izz="0.38148" ixy="0" ixz="0" iyz="0"/></inertial>
    <visual><geometry><mesh filename="meshes/wheel.stl"/></geometry><material name="dark"><color rgba="0.15 0.15 0.16 1"/></material></visual>
    <collision><origin xyz="0 0 0" rpy="1.5708 0 0"/><geometry><cylinder radius="0.254" length="0.203"/></geometry></collision>
  </link>
  <joint name="rear_left_wheel_joint" type="continuous"><parent link="base_link"/><child link="rear_left_wheel"/><origin xyz="-0.55 0.29 0.254" rpy="0 0 0"/>
    <axis xyz="0 1 0"/>
  </joint>
  <link name="rear_right_wheel">
    <inertial><origin xyz="0 0 0"/><mass value="19.5"/><inertia ixx="0.38148" iyy="0.62903" izz="0.38148" ixy="0" ixz="0" iyz="0"/></inertial>
    <visual><geometry><mesh filename="meshes/wheel.stl"/></geometry><material name="dark"><color rgba="0.15 0.15 0.16 1"/></material></visual>
    <collision><origin xyz="0 0 0" rpy="1.5708 0 0"/><geometry><cylinder radius="0.254" length="0.203"/></geometry></collision>
  </link>
  <joint name="rear_right_wheel_joint" type="continuous"><parent link="base_link"/><child link="rear_right_wheel"/><origin xyz="-0.55 -0.29 0.254" rpy="0 0 0"/>
    <axis xyz="0 1 0"/>
  </joint>
  <link name="harvester_mast">
    <inertial><origin xyz="0 0 1.2"/><mass value="28"/><inertia ixx="4.5033" iyy="3.7333" izz="1.5167" ixy="0" ixz="0" iyz="0"/></inertial>
    <visual><geometry><mesh filename="meshes/harvester_mast.stl"/></geometry><material name="grey"><color rgba="0.78 0.8 0.82 1"/></material></visual>
    <collision><origin xyz="-0.15 0 1.225" rpy="0 0 0"/><geometry><box size="0.04 0.08 1.25"/></geometry></collision>
    <collision><origin xyz="0.15 0 1.225" rpy="0 0 0"/><geometry><box size="0.04 0.08 1.25"/></geometry></collision>
    <collision><origin xyz="0 0 0.95" rpy="0 0 0"/><geometry><box size="0.38 0.44 0.26"/></geometry></collision>
    <collision><origin xyz="0 0 1.64" rpy="0 0 0"/><geometry><box size="0.1 0.7 0.06"/></geometry></collision>
    <collision><origin xyz="0 0 1.88" rpy="0 0 0"/><geometry><cylinder radius="0.035" length="0.08"/></geometry></collision>
  </link>
  <joint name="mast_joint" type="fixed"><parent link="base_link"/><child link="harvester_mast"/><origin xyz="0 0 0" rpy="0 0 0"/>
  </joint>
  <link name="harvester_totes">
    <inertial><origin xyz="0 0 0.775"/><mass value="6"/><inertia ixx="0.24125" iyy="1.0412" izz="1.16" ixy="0" ixz="0" iyz="0"/></inertial>
    <visual><geometry><mesh filename="meshes/harvester_totes.stl"/></geometry><material name="tote"><color rgba="0.15 0.35 0.62 1"/></material></visual>
    <collision><origin xyz="0.47 0 0.778" rpy="0 0 0"/><geometry><box size="0.5 0.6 0.35"/></geometry></collision>
    <collision><origin xyz="-0.47 0 0.778" rpy="0 0 0"/><geometry><box size="0.5 0.6 0.35"/></geometry></collision>
  </link>
  <joint name="totes_joint" type="fixed"><parent link="base_link"/><child link="harvester_totes"/><origin xyz="0 0 0" rpy="0 0 0"/>
  </joint>
  <link name="lidar_link">
  </link>
  <joint name="lidar_joint" type="fixed"><parent link="base_link"/><child link="lidar_link"/><origin xyz="0 0 1.882" rpy="0 0 0"/>
  </joint>
  <link name="imu_link">
  </link>
  <joint name="imu_joint" type="fixed"><parent link="base_link"/><child link="imu_link"/><origin xyz="0 0 0.48" rpy="0 0 0"/>
  </joint>
  <link name="gnss_left_link">
  </link>
  <joint name="gnss_left_joint" type="fixed"><parent link="base_link"/><child link="gnss_left_link"/><origin xyz="0 0.3 1.67" rpy="0 0 0"/>
  </joint>
  <link name="gnss_right_link">
  </link>
  <joint name="gnss_right_joint" type="fixed"><parent link="base_link"/><child link="gnss_right_link"/><origin xyz="0 -0.3 1.67" rpy="0 0 0"/>
  </joint>
  <link name="zed_left_link">
  </link>
  <joint name="zed_left_joint" type="fixed"><parent link="base_link"/><child link="zed_left_link"/><origin xyz="0 0.325 1.555" rpy="0 0.349066 1.5708"/>
  </joint>
  <link name="zed_right_link">
  </link>
  <joint name="zed_right_joint" type="fixed"><parent link="base_link"/><child link="zed_right_link"/><origin xyz="0 -0.325 1.555" rpy="0 0.349066 -1.5708"/>
  </joint>
  <link name="left_arm_base">
    <inertial><origin xyz="0 0 0.045"/><mass value="2"/><inertia ixx="0.0041625" iyy="0.0041625" izz="0.005625" ixy="0" ixz="0" iyz="0"/></inertial>
    <visual><geometry><mesh filename="meshes/arm_arm_base.stl"/></geometry><material name="dark"><color rgba="0.15 0.15 0.16 1"/></material></visual>
    <collision><origin xyz="0 0 0.045" rpy="0 0 0"/><geometry><cylinder radius="0.075" length="0.09"/></geometry></collision>
  </link>
  <joint name="left_arm_mount_joint" type="fixed"><parent link="harvester_mast"/><child link="left_arm_base"/><origin xyz="0 0.22 0.95" rpy="-1.5708 0 0"/>
  </joint>
  <link name="left_arm_shoulder">
    <inertial><origin xyz="0 0 0"/><mass value="4"/><inertia ixx="0.010758" iyy="0.010758" izz="0.00845" ixy="0" ixz="0" iyz="0"/></inertial>
    <visual><geometry><mesh filename="meshes/arm_shoulder.stl"/></geometry><material name="dark"><color rgba="0.15 0.15 0.16 1"/></material></visual>
    <collision><origin xyz="0 0 0" rpy="0 0 0"/><geometry><cylinder radius="0.062" length="0.14"/></geometry></collision>
  </link>
  <joint name="left_arm_shoulder_pan_joint" type="revolute"><parent link="left_arm_base"/><child link="left_arm_shoulder"/><origin xyz="0 0 0.152" rpy="0 0 0"/>
    <axis xyz="0 0 1"/>
    <limit lower="-3.0543" upper="3.0543" effort="150" velocity="3.142"/><dynamics damping="0.5" friction="0.1"/>
  </joint>
  <link name="left_arm_upper_arm">
    <inertial><origin xyz="0 0 0"/><mass value="6.5"/><inertia ixx="0.10422" iyy="0.10422" izz="0.008125" ixy="0" ixz="0" iyz="0"/></inertial>
    <visual><geometry><mesh filename="meshes/arm_upper_arm.stl"/></geometry><material name="white"><color rgba="0.93 0.93 0.91 1"/></material></visual>
    <collision><origin xyz="-0.2125 0 0.135" rpy="0 1.5708 0"/><geometry><cylinder radius="0.046" length="0.425"/></geometry></collision>
    <collision><origin xyz="0 0 0.07" rpy="0 0 0"/><geometry><cylinder radius="0.062" length="0.14"/></geometry></collision>
    <collision><origin xyz="-0.425 0 0.07" rpy="0 0 0"/><geometry><cylinder radius="0.055" length="0.14"/></geometry></collision>
  </link>
  <joint name="left_arm_shoulder_lift_joint" type="revolute"><parent link="left_arm_shoulder"/><child link="left_arm_upper_arm"/><origin xyz="0 0 0" rpy="1.5708 0 0"/>
    <axis xyz="0 0 1"/>
    <limit lower="-4.6251" upper="1.4835" effort="150" velocity="3.142"/><dynamics damping="0.5" friction="0.1"/>
  </joint>
  <link name="left_arm_forearm">
    <inertial><origin xyz="0 0 0"/><mass value="3.5"/><inertia ixx="0.048067" iyy="0.048067" izz="0.0028" ixy="0" ixz="0" iyz="0"/></inertial>
    <visual><geometry><mesh filename="meshes/arm_forearm.stl"/></geometry><material name="white"><color rgba="0.93 0.93 0.91 1"/></material></visual>
    <collision><origin xyz="-0.1975 0 0.02" rpy="0 1.5708 0"/><geometry><cylinder radius="0.038" length="0.395"/></geometry></collision>
    <collision><origin xyz="-0.395 0 0.03" rpy="0 0 0"/><geometry><cylinder radius="0.045" length="0.09"/></geometry></collision>
  </link>
  <joint name="left_arm_elbow_joint" type="revolute"><parent link="left_arm_upper_arm"/><child link="left_arm_forearm"/><origin xyz="-0.425 0 0" rpy="0 0 0"/>
    <axis xyz="0 0 1"/>
    <limit lower="-2.7925" upper="2.7925" effort="150" velocity="3.142"/><dynamics damping="0.5" friction="0.1"/>
  </joint>
  <link name="left_arm_wrist_1">
    <inertial><origin xyz="0 0 0"/><mass value="1.6"/><inertia ixx="0.0021433" iyy="0.0021433" izz="0.00162" ixy="0" ixz="0" iyz="0"/></inertial>
    <visual><geometry><mesh filename="meshes/arm_wrist_1.stl"/></geometry><material name="dark"><color rgba="0.15 0.15 0.16 1"/></material></visual>
    <collision><origin xyz="0 0 0" rpy="0 0 0"/><geometry><cylinder radius="0.045" length="0.09"/></geometry></collision>
  </link>
  <joint name="left_arm_wrist_1_joint" type="revolute"><parent link="left_arm_forearm"/><child link="left_arm_wrist_1"/><origin xyz="-0.395 0 0.102" rpy="0 0 0"/>
    <axis xyz="0 0 1"/>
    <limit lower="-4.6251" upper="1.4835" effort="28" velocity="3.142"/><dynamics damping="0.5" friction="0.1"/>
  </joint>
  <link name="left_arm_wrist_2">
    <inertial><origin xyz="0 0 0"/><mass value="1.6"/><inertia ixx="0.0021433" iyy="0.0021433" izz="0.00162" ixy="0" ixz="0" iyz="0"/></inertial>
    <visual><geometry><mesh filename="meshes/arm_wrist_2.stl"/></geometry><material name="dark"><color rgba="0.15 0.15 0.16 1"/></material></visual>
    <collision><origin xyz="0 0 0" rpy="0 0 0"/><geometry><cylinder radius="0.045" length="0.09"/></geometry></collision>
  </link>
  <joint name="left_arm_wrist_2_joint" type="revolute"><parent link="left_arm_wrist_1"/><child link="left_arm_wrist_2"/><origin xyz="0 -0.102 0" rpy="1.5708 0 0"/>
    <axis xyz="0 0 1"/>
    <limit lower="-3.0543" upper="3.0543" effort="28" velocity="3.142"/><dynamics damping="0.5" friction="0.1"/>
  </joint>
  <link name="left_arm_wrist_3">
    <inertial><origin xyz="0 0 0"/><mass value="0.8"/><inertia ixx="0.00045947" iyy="0.00045947" izz="0.0007056" ixy="0" ixz="0" iyz="0"/></inertial>
    <visual><geometry><mesh filename="meshes/arm_wrist_3.stl"/></geometry><material name="dark"><color rgba="0.15 0.15 0.16 1"/></material></visual>
    <collision><origin xyz="0 0 -0.02" rpy="0 0 0"/><geometry><cylinder radius="0.042" length="0.04"/></geometry></collision>
  </link>
  <joint name="left_arm_wrist_3_joint" type="revolute"><parent link="left_arm_wrist_2"/><child link="left_arm_wrist_3"/><origin xyz="0 0.1 0" rpy="1.5708 3.14159 3.14159"/>
    <axis xyz="0 0 1"/>
    <limit lower="-3.0543" upper="3.0543" effort="28" velocity="3.142"/><dynamics damping="0.5" friction="0.1"/>
  </joint>
  <link name="left_arm_tool0">
  </link>
  <joint name="left_arm_tool0_joint" type="fixed"><parent link="left_arm_wrist_3"/><child link="left_arm_tool0"/><origin xyz="0 0 0" rpy="0 0 0"/>
  </joint>
  <link name="left_ee_body">
    <inertial><origin xyz="0 0 0.08"/><mass value="0.95"/><inertia ixx="0.0025076" iyy="0.0025076" izz="0.00096187" ixy="0" ixz="0" iyz="0"/></inertial>
    <visual><geometry><mesh filename="meshes/ee_body.stl"/></geometry><material name="grey"><color rgba="0.78 0.8 0.82 1"/></material></visual>
    <collision><origin xyz="0 0 0.073" rpy="0 0 0"/><geometry><cylinder radius="0.045" length="0.146"/></geometry></collision>
    <collision><origin xyz="0.067 0 0.12" rpy="0 0 0"/><geometry><box size="0.03 0.03 0.06"/></geometry></collision>
  </link>
  <joint name="left_ee_mount_joint" type="fixed"><parent link="left_arm_tool0"/><child link="left_ee_body"/><origin xyz="0 0 0" rpy="0 0 0"/>
  </joint>
  <link name="left_ee_finger_1">
    <inertial><origin xyz="0 0 0.04"/><mass value="0.05"/><inertia ixx="4.0871e-05" iyy="4.1354e-05" izz="7.0167e-06" ixy="0" ixz="0" iyz="0"/></inertial>
    <visual><geometry><mesh filename="meshes/ee_finger.stl"/></geometry><material name="blue"><color rgba="0.1 0.45 0.7 1"/></material></visual>
    <collision><origin xyz="0 0 0.0475" rpy="0 0 0"/><geometry><box size="0.024 0.028 0.095"/></geometry></collision>
  </link>
  <joint name="left_ee_finger_1_joint" type="revolute"><parent link="left_ee_body"/><child link="left_ee_finger_1"/><origin xyz="2.32683e-18 0.038 0.15" rpy="0 0 1.5708"/>
    <axis xyz="0 -1 0"/>
    <limit lower="-0.15" upper="0.45" effort="2.0" velocity="2"/><dynamics damping="0.5" friction="0.1"/>
  </joint>
  <link name="left_ee_finger_2">
    <inertial><origin xyz="0 0 0.04"/><mass value="0.05"/><inertia ixx="4.0871e-05" iyy="4.1354e-05" izz="7.0167e-06" ixy="0" ixz="0" iyz="0"/></inertial>
    <visual><geometry><mesh filename="meshes/ee_finger.stl"/></geometry><material name="blue"><color rgba="0.1 0.45 0.7 1"/></material></visual>
    <collision><origin xyz="0 0 0.0475" rpy="0 0 0"/><geometry><box size="0.024 0.028 0.095"/></geometry></collision>
  </link>
  <joint name="left_ee_finger_2_joint" type="revolute"><parent link="left_ee_body"/><child link="left_ee_finger_2"/><origin xyz="-0.032909 -0.019 0.15" rpy="0 0 3.66519"/>
    <axis xyz="0 -1 0"/>
    <limit lower="-0.15" upper="0.45" effort="2.0" velocity="2"/><dynamics damping="0.5" friction="0.1"/>
  </joint>
  <link name="left_ee_finger_3">
    <inertial><origin xyz="0 0 0.04"/><mass value="0.05"/><inertia ixx="4.0871e-05" iyy="4.1354e-05" izz="7.0167e-06" ixy="0" ixz="0" iyz="0"/></inertial>
    <visual><geometry><mesh filename="meshes/ee_finger.stl"/></geometry><material name="blue"><color rgba="0.1 0.45 0.7 1"/></material></visual>
    <collision><origin xyz="0 0 0.0475" rpy="0 0 0"/><geometry><box size="0.024 0.028 0.095"/></geometry></collision>
  </link>
  <joint name="left_ee_finger_3_joint" type="revolute"><parent link="left_ee_body"/><child link="left_ee_finger_3"/><origin xyz="0.032909 -0.019 0.15" rpy="0 0 5.75959"/>
    <axis xyz="0 -1 0"/>
    <limit lower="-0.15" upper="0.45" effort="2.0" velocity="2"/><dynamics damping="0.5" friction="0.1"/>
  </joint>
  <link name="left_ee_suction_cup">
    <inertial><origin xyz="0 0 0.02"/><mass value="0.04"/><inertia ixx="9.3333e-06" iyy="9.3333e-06" izz="8e-06" ixy="0" ixz="0" iyz="0"/></inertial>
    <collision><origin xyz="0 0 0.02" rpy="0 0 0"/><geometry><cylinder radius="0.02" length="0.02"/></geometry></collision>
  </link>
  <joint name="left_ee_suction_joint" type="prismatic"><parent link="left_ee_body"/><child link="left_ee_suction_cup"/><origin xyz="0 0 0.23" rpy="0 0 0"/>
    <axis xyz="0 0 1"/>
    <limit lower="-0.065" upper="0" effort="40.0" velocity="0.25"/><dynamics damping="0.5" friction="0.1"/>
  </joint>
  <link name="left_ee_camera_link">
  </link>
  <joint name="left_ee_camera_joint" type="fixed"><parent link="left_ee_body"/><child link="left_ee_camera_link"/><origin xyz="0.08 0 0.077" rpy="0 -2.08994 0"/>
  </joint>
  <link name="left_ee_tcp">
  </link>
  <joint name="left_ee_tcp_joint" type="fixed"><parent link="left_ee_body"/><child link="left_ee_tcp"/><origin xyz="0 0 0.205" rpy="0 0 0"/>
  </joint>
  <link name="right_arm_base">
    <inertial><origin xyz="0 0 0.045"/><mass value="2"/><inertia ixx="0.0041625" iyy="0.0041625" izz="0.005625" ixy="0" ixz="0" iyz="0"/></inertial>
    <visual><geometry><mesh filename="meshes/arm_arm_base.stl"/></geometry><material name="dark"><color rgba="0.15 0.15 0.16 1"/></material></visual>
    <collision><origin xyz="0 0 0.045" rpy="0 0 0"/><geometry><cylinder radius="0.075" length="0.09"/></geometry></collision>
  </link>
  <joint name="right_arm_mount_joint" type="fixed"><parent link="harvester_mast"/><child link="right_arm_base"/><origin xyz="0 -0.22 0.95" rpy="1.5708 0 0"/>
  </joint>
  <link name="right_arm_shoulder">
    <inertial><origin xyz="0 0 0"/><mass value="4"/><inertia ixx="0.010758" iyy="0.010758" izz="0.00845" ixy="0" ixz="0" iyz="0"/></inertial>
    <visual><geometry><mesh filename="meshes/arm_shoulder.stl"/></geometry><material name="dark"><color rgba="0.15 0.15 0.16 1"/></material></visual>
    <collision><origin xyz="0 0 0" rpy="0 0 0"/><geometry><cylinder radius="0.062" length="0.14"/></geometry></collision>
  </link>
  <joint name="right_arm_shoulder_pan_joint" type="revolute"><parent link="right_arm_base"/><child link="right_arm_shoulder"/><origin xyz="0 0 0.152" rpy="0 0 0"/>
    <axis xyz="0 0 1"/>
    <limit lower="-3.0543" upper="3.0543" effort="150" velocity="3.142"/><dynamics damping="0.5" friction="0.1"/>
  </joint>
  <link name="right_arm_upper_arm">
    <inertial><origin xyz="0 0 0"/><mass value="6.5"/><inertia ixx="0.10422" iyy="0.10422" izz="0.008125" ixy="0" ixz="0" iyz="0"/></inertial>
    <visual><geometry><mesh filename="meshes/arm_upper_arm.stl"/></geometry><material name="white"><color rgba="0.93 0.93 0.91 1"/></material></visual>
    <collision><origin xyz="-0.2125 0 0.135" rpy="0 1.5708 0"/><geometry><cylinder radius="0.046" length="0.425"/></geometry></collision>
    <collision><origin xyz="0 0 0.07" rpy="0 0 0"/><geometry><cylinder radius="0.062" length="0.14"/></geometry></collision>
    <collision><origin xyz="-0.425 0 0.07" rpy="0 0 0"/><geometry><cylinder radius="0.055" length="0.14"/></geometry></collision>
  </link>
  <joint name="right_arm_shoulder_lift_joint" type="revolute"><parent link="right_arm_shoulder"/><child link="right_arm_upper_arm"/><origin xyz="0 0 0" rpy="1.5708 0 0"/>
    <axis xyz="0 0 1"/>
    <limit lower="-4.6251" upper="1.4835" effort="150" velocity="3.142"/><dynamics damping="0.5" friction="0.1"/>
  </joint>
  <link name="right_arm_forearm">
    <inertial><origin xyz="0 0 0"/><mass value="3.5"/><inertia ixx="0.048067" iyy="0.048067" izz="0.0028" ixy="0" ixz="0" iyz="0"/></inertial>
    <visual><geometry><mesh filename="meshes/arm_forearm.stl"/></geometry><material name="white"><color rgba="0.93 0.93 0.91 1"/></material></visual>
    <collision><origin xyz="-0.1975 0 0.02" rpy="0 1.5708 0"/><geometry><cylinder radius="0.038" length="0.395"/></geometry></collision>
    <collision><origin xyz="-0.395 0 0.03" rpy="0 0 0"/><geometry><cylinder radius="0.045" length="0.09"/></geometry></collision>
  </link>
  <joint name="right_arm_elbow_joint" type="revolute"><parent link="right_arm_upper_arm"/><child link="right_arm_forearm"/><origin xyz="-0.425 0 0" rpy="0 0 0"/>
    <axis xyz="0 0 1"/>
    <limit lower="-2.7925" upper="2.7925" effort="150" velocity="3.142"/><dynamics damping="0.5" friction="0.1"/>
  </joint>
  <link name="right_arm_wrist_1">
    <inertial><origin xyz="0 0 0"/><mass value="1.6"/><inertia ixx="0.0021433" iyy="0.0021433" izz="0.00162" ixy="0" ixz="0" iyz="0"/></inertial>
    <visual><geometry><mesh filename="meshes/arm_wrist_1.stl"/></geometry><material name="dark"><color rgba="0.15 0.15 0.16 1"/></material></visual>
    <collision><origin xyz="0 0 0" rpy="0 0 0"/><geometry><cylinder radius="0.045" length="0.09"/></geometry></collision>
  </link>
  <joint name="right_arm_wrist_1_joint" type="revolute"><parent link="right_arm_forearm"/><child link="right_arm_wrist_1"/><origin xyz="-0.395 0 0.102" rpy="0 0 0"/>
    <axis xyz="0 0 1"/>
    <limit lower="-4.6251" upper="1.4835" effort="28" velocity="3.142"/><dynamics damping="0.5" friction="0.1"/>
  </joint>
  <link name="right_arm_wrist_2">
    <inertial><origin xyz="0 0 0"/><mass value="1.6"/><inertia ixx="0.0021433" iyy="0.0021433" izz="0.00162" ixy="0" ixz="0" iyz="0"/></inertial>
    <visual><geometry><mesh filename="meshes/arm_wrist_2.stl"/></geometry><material name="dark"><color rgba="0.15 0.15 0.16 1"/></material></visual>
    <collision><origin xyz="0 0 0" rpy="0 0 0"/><geometry><cylinder radius="0.045" length="0.09"/></geometry></collision>
  </link>
  <joint name="right_arm_wrist_2_joint" type="revolute"><parent link="right_arm_wrist_1"/><child link="right_arm_wrist_2"/><origin xyz="0 -0.102 0" rpy="1.5708 0 0"/>
    <axis xyz="0 0 1"/>
    <limit lower="-3.0543" upper="3.0543" effort="28" velocity="3.142"/><dynamics damping="0.5" friction="0.1"/>
  </joint>
  <link name="right_arm_wrist_3">
    <inertial><origin xyz="0 0 0"/><mass value="0.8"/><inertia ixx="0.00045947" iyy="0.00045947" izz="0.0007056" ixy="0" ixz="0" iyz="0"/></inertial>
    <visual><geometry><mesh filename="meshes/arm_wrist_3.stl"/></geometry><material name="dark"><color rgba="0.15 0.15 0.16 1"/></material></visual>
    <collision><origin xyz="0 0 -0.02" rpy="0 0 0"/><geometry><cylinder radius="0.042" length="0.04"/></geometry></collision>
  </link>
  <joint name="right_arm_wrist_3_joint" type="revolute"><parent link="right_arm_wrist_2"/><child link="right_arm_wrist_3"/><origin xyz="0 0.1 0" rpy="1.5708 3.14159 3.14159"/>
    <axis xyz="0 0 1"/>
    <limit lower="-3.0543" upper="3.0543" effort="28" velocity="3.142"/><dynamics damping="0.5" friction="0.1"/>
  </joint>
  <link name="right_arm_tool0">
  </link>
  <joint name="right_arm_tool0_joint" type="fixed"><parent link="right_arm_wrist_3"/><child link="right_arm_tool0"/><origin xyz="0 0 0" rpy="0 0 0"/>
  </joint>
  <link name="right_ee_body">
    <inertial><origin xyz="0 0 0.08"/><mass value="0.95"/><inertia ixx="0.0025076" iyy="0.0025076" izz="0.00096187" ixy="0" ixz="0" iyz="0"/></inertial>
    <visual><geometry><mesh filename="meshes/ee_body.stl"/></geometry><material name="grey"><color rgba="0.78 0.8 0.82 1"/></material></visual>
    <collision><origin xyz="0 0 0.073" rpy="0 0 0"/><geometry><cylinder radius="0.045" length="0.146"/></geometry></collision>
    <collision><origin xyz="0.067 0 0.12" rpy="0 0 0"/><geometry><box size="0.03 0.03 0.06"/></geometry></collision>
  </link>
  <joint name="right_ee_mount_joint" type="fixed"><parent link="right_arm_tool0"/><child link="right_ee_body"/><origin xyz="0 0 0" rpy="0 0 0"/>
  </joint>
  <link name="right_ee_finger_1">
    <inertial><origin xyz="0 0 0.04"/><mass value="0.05"/><inertia ixx="4.0871e-05" iyy="4.1354e-05" izz="7.0167e-06" ixy="0" ixz="0" iyz="0"/></inertial>
    <visual><geometry><mesh filename="meshes/ee_finger.stl"/></geometry><material name="blue"><color rgba="0.1 0.45 0.7 1"/></material></visual>
    <collision><origin xyz="0 0 0.0475" rpy="0 0 0"/><geometry><box size="0.024 0.028 0.095"/></geometry></collision>
  </link>
  <joint name="right_ee_finger_1_joint" type="revolute"><parent link="right_ee_body"/><child link="right_ee_finger_1"/><origin xyz="2.32683e-18 0.038 0.15" rpy="0 0 1.5708"/>
    <axis xyz="0 -1 0"/>
    <limit lower="-0.15" upper="0.45" effort="2.0" velocity="2"/><dynamics damping="0.5" friction="0.1"/>
  </joint>
  <link name="right_ee_finger_2">
    <inertial><origin xyz="0 0 0.04"/><mass value="0.05"/><inertia ixx="4.0871e-05" iyy="4.1354e-05" izz="7.0167e-06" ixy="0" ixz="0" iyz="0"/></inertial>
    <visual><geometry><mesh filename="meshes/ee_finger.stl"/></geometry><material name="blue"><color rgba="0.1 0.45 0.7 1"/></material></visual>
    <collision><origin xyz="0 0 0.0475" rpy="0 0 0"/><geometry><box size="0.024 0.028 0.095"/></geometry></collision>
  </link>
  <joint name="right_ee_finger_2_joint" type="revolute"><parent link="right_ee_body"/><child link="right_ee_finger_2"/><origin xyz="-0.032909 -0.019 0.15" rpy="0 0 3.66519"/>
    <axis xyz="0 -1 0"/>
    <limit lower="-0.15" upper="0.45" effort="2.0" velocity="2"/><dynamics damping="0.5" friction="0.1"/>
  </joint>
  <link name="right_ee_finger_3">
    <inertial><origin xyz="0 0 0.04"/><mass value="0.05"/><inertia ixx="4.0871e-05" iyy="4.1354e-05" izz="7.0167e-06" ixy="0" ixz="0" iyz="0"/></inertial>
    <visual><geometry><mesh filename="meshes/ee_finger.stl"/></geometry><material name="blue"><color rgba="0.1 0.45 0.7 1"/></material></visual>
    <collision><origin xyz="0 0 0.0475" rpy="0 0 0"/><geometry><box size="0.024 0.028 0.095"/></geometry></collision>
  </link>
  <joint name="right_ee_finger_3_joint" type="revolute"><parent link="right_ee_body"/><child link="right_ee_finger_3"/><origin xyz="0.032909 -0.019 0.15" rpy="0 0 5.75959"/>
    <axis xyz="0 -1 0"/>
    <limit lower="-0.15" upper="0.45" effort="2.0" velocity="2"/><dynamics damping="0.5" friction="0.1"/>
  </joint>
  <link name="right_ee_suction_cup">
    <inertial><origin xyz="0 0 0.02"/><mass value="0.04"/><inertia ixx="9.3333e-06" iyy="9.3333e-06" izz="8e-06" ixy="0" ixz="0" iyz="0"/></inertial>
    <collision><origin xyz="0 0 0.02" rpy="0 0 0"/><geometry><cylinder radius="0.02" length="0.02"/></geometry></collision>
  </link>
  <joint name="right_ee_suction_joint" type="prismatic"><parent link="right_ee_body"/><child link="right_ee_suction_cup"/><origin xyz="0 0 0.23" rpy="0 0 0"/>
    <axis xyz="0 0 1"/>
    <limit lower="-0.065" upper="0" effort="40.0" velocity="0.25"/><dynamics damping="0.5" friction="0.1"/>
  </joint>
  <link name="right_ee_camera_link">
  </link>
  <joint name="right_ee_camera_joint" type="fixed"><parent link="right_ee_body"/><child link="right_ee_camera_link"/><origin xyz="0.08 0 0.077" rpy="0 -2.08994 0"/>
  </joint>
  <link name="right_ee_tcp">
  </link>
  <joint name="right_ee_tcp_joint" type="fixed"><parent link="right_ee_body"/><child link="right_ee_tcp"/><origin xyz="0 0 0.205" rpy="0 0 0"/>
  </joint>
</robot>
