LakshanandSugumar/agrobo/robots/electrical/E-01_power_single_line.pdf

# E-01 AB-1 / HM-1 power distribution (single line)

## S1 lockout

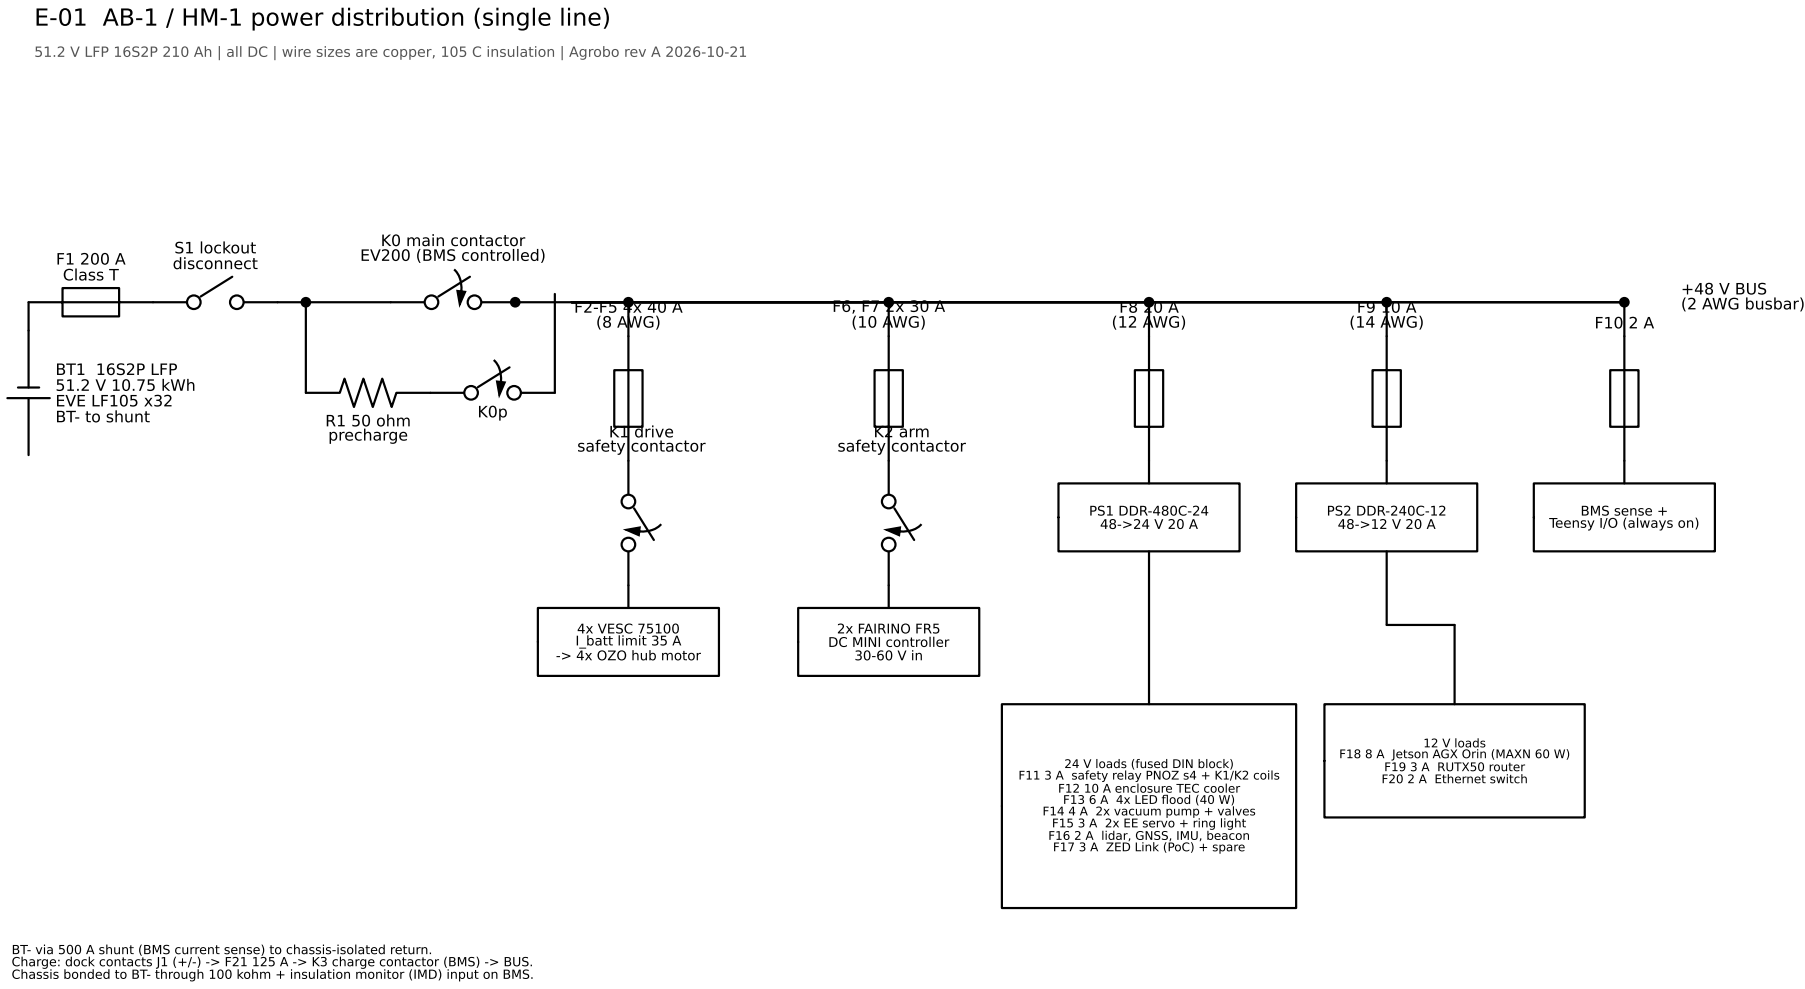
[picture p101: page 1]
F1 200 A Class T; disconnect; K0 main contactor EV200 (BMS controlled); R1 50 ohm precharge; +48 V BUS; (2 AWG busbar); (8 AWG); drive; safety; contactor; F6, F7 2x 30 A (10 AWG); K2 arm; F8 20 A (12 AWG); PS1 DDR-480C-24 48->24 V 20 A; F9 10 A (14 AWG); PS2 DDR-240C-12 48->12 V 20 A; 12 V loads; F19 3 A RUTX50 router F20 2 A Ethernet switch

51.2 V LFP 16S2P 210 Ah | all DC | wire sizes are copper, 105 C insulation | Agrobo rev A 2026-10-21

BT1 16S2P LFP
51.2 V 10.75 kWh
EVE LF105 x32
BT- to shunt

BMS sense +
Teensy I/O (always on)

4x VESC 75100
I_batt limit 35 A
-> 4x OZO hub motor

2x FAIRINO FR5
DC MINI controller

24 V loads (fused DIN block)

F18 8 A Jetson AGX Orin (MAXN 60 W)

F11 3 A safety relay PNOZ s4 + K1/K2 coils

F12 10 A enclosure TEC cooler
F13 6 A 4x LED flood (40 W)
F14 4 A 2x vacuum pump + valves
F15 3 A 2x EE servo + ring light
F16 2 A lidar, GNSS, IMU, beacon
F17 3 A ZED Link (PoC) + spare

BT- via 500 A shunt (BMS current sense) to chassis-isolated return.
Charge: dock contacts J1 (+/-) -> F21 125 A -> K3 charge contactor (BMS) -> BUS.
Chassis bonded to BT- through 100 kohm + insulation monitor (IMD) input on BMS.
