LakshanandSugumar/agrobo/(commit log)

2026-10-07 Agrobo: company website with live simulation tools, plus the ROS 2 season simulation
    web/: Next.js 16 + TypeScript site. Landing page, platform tools (Land Scout,
    farm economics, market desk, season replay), technology and results pages,
    early-access signup. API routes run TypeScript ports of the simulation's
    strategy, economics and market models; parity tests check them against the
    Python outputs.
    simulation/: ROS 2 Jazzy + Gazebo Harmonic tomato-season simulation, KPI
    report and 3-seed twin vs no-twin runs.
    Claude-Session: https://claude.ai/code/session_01XbmDsTjKdXtyPn7ufv3rs8
    [farm.sdf]
2026-10-10 Homepage film: plays full-window after a few idle seconds at the top
    IdleFilm fades the brand film in over the homepage when the visitor stays at
    the top without scrolling, clicking or typing for 4 s, plays it muted with a
    tap-for-sound control, and hands the page back on any scroll, click or key.
    Once per session, skipped for reduced motion; a hero button replays it with
    sound. Web encodes (H.264 + VP9, ~10 MB each) and poster in public/film.
    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
2026-10-11 Homepage film: swap in the photoreal cut (v2)
    Re-encoded from agrobo-film-v2.mp4 (86 s, 1080p24): H.264 21 MB, VP9 13 MB,
    new poster from the opening shot.
    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
2026-10-21 Monorepo: add robot hardware, training, training world, land, film source
    Brings every Agrobo workstream into one repo alongside the website and
    simulation. Refreshes simulation/ from the canonical copy (adds
    tools/land_analyzer.py) and the homepage film. Large renders, zips and
    model checkpoints are excluded via .gitignore.
    Claude-Session: https://claude.ai/code/session_013kxmz1NXNpeaFvCiDJL2i3
    [AB-1_base.csv, AB1-201_deck_plate.step, AB1-201_deck_plate_3mm_5052.dxf, AB1-202_axle_plate.step, AB1-202_axle_plate_10mm_6061_x4.dxf, Agrobo_BOM.xlsx, EE-1_end_effector.csv, EE1-001_flange_adapter.step]
2026-10-21 Training: freeze obs normalisation, optional --bc-reg, runs 4-5 results
    Syncs training/ from the robot training workstream: train_ppo.py update,
    README results table, and text logs/metrics for cloud CPU runs 4 and 5.
    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
    [eval_log.csv]
2026-11-03 Training: potential-based reward shaping, strict clean metric, resume, 20M-step results
    Syncs training/ from the robot training workstream: env.py reward
    shaping, strict clean-pick metric in train_ppo.py and evaluate.py,
    resume support, README results table, and text logs/metrics for the
    cloud_full_20m and cloud_pbrs_20m runs.
    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
    [eval_log.csv]
